dditsupport/dd_ac_meter_with_relay_buffer/README.md

# AC Energy Meter

Single-phase AC energy metering for any 230 V circuit or load. The device
measures voltage, current, real power, energy, power factor, and frequency
with a PZEM-004T v3.0, buffers 15-minute readings to internal flash, and
mirrors them to a MilesWeb-hosted PHP/MySQL backend via two store-and-forward
paths:

- **Wi-Fi** — when a known hotspot is in range, the ESP32 connects, NTP-syncs,
  POSTs buffered rows, and clears them on server ACK.
- **BLE** — a companion Android app pulls buffered rows over GATT and
  forwards them to the same MilesWeb endpoint over the phone's cellular
  data.

The ESP32 is the source of truth. Cloud and app are catch-up mirrors.

## Relay: compressor-aware AC cutoff

Each meter drives a relay (default GPIO 10) that acts as an **off-hours AC
cutoff** — a safety net for when a store manager forgets to switch the AC off
after closing. Wiring is **fail-safe NC**: the relay sits **de-energized while
the AC is allowed (open hours)** so the AC has power, and it **energizes to cut
the AC** during off hours. If the controller loses power, the relay
de-energizes and the AC keeps working. Drive a **contactor rated for the
compressor's inrush** (units are 1.5–2 ton), not a bare PCB relay — see
[`docs/PINOUT.md`](docs/PINOUT.md).

An admin sets, per device, from the backend (Admin → Devices → **Relay**):

- **AC-allowed open hours** — weekly windows (e.g. 09:00→02:00, or 11:00→23:00);
  the relay cuts power *outside* them.
- **Compressor watt threshold** — below it the compressor is considered off.
- **Grace minutes** — how long to wait for the compressor to cycle off before
  cutting.

The firmware caches all three in NVS and enforces cutoff from its local clock
even during a Wi-Fi outage. Crucially it **never opens the relay while the
compressor is drawing load**: at closing it waits for the compressor to cycle
off (wattage drops below the threshold) and then cuts, hard-cutting only at the
grace deadline if it never idles. If the AC is already idle at closing it never
cuts. No open-hours schedule cached = relay stays de-energized (AC on), the
fail-safe for an unconfigured device.

The firmware reports its relay state (energized/cut + mode) on every
`ingest.php` POST, so the admin table shows a **live indicator** per meter, and
exposes the fuller state (state-machine phase + latest wattage) over the BLE
relay characteristic. The logged wattage rows are what you tune the
threshold/grace against after observing real data.

The **Android app** can also take the relay over BLE from the device detail
screen: **On** (energize = cut) / **Off** (de-energize = AC on) force it
regardless of schedule, and **Auto** returns it to cutoff control. The override
lives in RAM, so a power-cycle returns the meter to its server config.

## Repository layout

```
firmware/                                             ESP32 Arduino sketches (one folder per board)
  esp32.supermini_ds1307_ac_energy_meter/             ESP32-C3 Super Mini firmware (DS1307, no OLED)
  esp32.WROOM.DevKit.V1_ds1307_ac_energy_meter/  ESP32 WROOM DevKit V1 firmware (DS1307, no display)
backend/                                              MilesWeb PHP + MySQL (planned, not yet built)
android/                                              Companion app (planned, not yet built)
docs/                                                 Wiring, provisioning, future hardware notes
hardware/                                             PCB source (DipTrace) + dimensioned outline drawing
tools/                                                Bench-test helpers (fake_ingest.py)
```

Both firmware folders are self-contained Arduino sketches for the same
meter; pick the one that matches your hardware. The `.supermini` build
targets the ESP32-C3 Super Mini; the `.WROOM.DevKit.V1` build targets the
ESP32 WROOM DevKit V1. Both use a DS1307 RTC and neither has a display. They
are kept separate, not merged, but track the same firmware version and feature
set — both are now `FW_VERSION` **2.0.0** with the compressor-aware, fail-safe
NC AC-cutoff relay (AC-allowed open-hours schedule; energize = cut).

The Super Mini build is the field-tested baseline and the WROOM build carries
the same logic. The differences are hardware-driven:

| | Super Mini (ESP32-C3) | WROOM DevKit V1 |
|---|---|---|
| Cores / radio | single core; BLE and Wi-Fi contend | dual core; no coexistence issue |
| BLE lifetime | 2-min config window, then handed off to Wi-Fi | BLE up for the whole session, alongside Wi-Fi |
| Wi-Fi TX power | capped at 11 dBm (weak onboard LDO) | full 19.5 dBm |
| PZEM UART | `Serial1` | `Serial2` |
| Pin map | C3 pins | ESP32 pins; GPIO 6..11 reserved for SPI flash |
| PZEM meters | 1 | 1, or **2** with the dual-PZEM build |

TX power is runtime-settable over BLE on both boards, so either can be trimmed
if a particular install proves marginal.

### Dual-PZEM build (WROOM only)

`esp32.WROOM.DevKit.V1_dual_pzem_ac_energy_meter/` (`FW_VERSION` **3.0.0**)
reads **two** PZEM-004T meters from one ESP32 and reports both under a single
`device_id`. Each meter gets its own hardware UART — channel 1 on UART2
(GPIO 16/17), channel 2 on UART1 (GPIO 32/33) — because the TTL PZEM variant
drives its TX line permanently and two of them on one UART would collide. Set
`PZEM_CHANNELS` and the `PIN_PZEM*` / `PZEM*_ADDR` entries in `config.h`.

Every reading carries a 1-based channel end to end:

- log rows are `seq,ch,boot_id,sec,V,I,P,Wh,PF,Hz` — one sampling instant writes
  one row **per channel**, all sharing `seq`, so seq-based acking still advances
  both channels together;
- the ingest POST tags each reading with `ch` and the device with
  `channel_count`;
- readings are keyed on `(device_id, seq, channel)` in the database.

Each channel keeps independent totals, midnight anchors and fault status, so one
dead meter never masks or blocks the other.

**Two relays, one per PZEM.** Relay N (GPIO 26 for PZEM 1, GPIO 27 for PZEM 2)
cuts the AC that meter N measures, and runs a fully independent open-hours
schedule, cutoff state machine, manual override and NVS-cached config. The
compressor-idle check for relay N looks only at channel N's wattage — that
pairing is the point, since deciding relay 1 from meter 2's load would either
hard-cut a running compressor or never cut at all. A failed read on a channel
counts as "compressor may be running", so a dead meter is never mistaken for an
idle one.

Relay config is stored and pushed per channel:

- `ed_device_relay_schedule` is keyed `(device_id, channel)`;
- the ingest response carries `relay_channels: [{ch, version, schedule[],
  compressor_watts, grace_min}, ...]` (the old flat `relay_*` fields are still
  emitted from channel 1, and firmware that receives only those applies them to
  every relay);
- `/api/admin_relay.php` takes a `channel` parameter (default 1) on
  `get` / `set` / `clear`, and the admin Devices page shows a relay picker
  (hidden on single-relay devices) driven by the device's reported
  `relay_count`;
- the dashboard and reports take a `channel` too, with a **Meter** selector that
  appears only for multi-meter devices. It defaults to **All meters**
  (`channel=0`), which queries every meter and overlays them — one colour-coded
  series per meter on both charts, a per-meter breakdown row, and combined
  Current / Today / Peak / Period-total cards. Picking a single meter narrows to
  that one. Reports instead offer **one meter at a time** with no combined
  option — that chart's series are already days, so folding meters in would
  multiply the lines or silently sum unrelated loads;
- the Android app's Cloud tab gets a **Meter** chip row (shown only when the
  server reports `channel_count > 1`) and charts one meter at a time, matching
  the reports rather than the dashboard overlay;
- the live relay indicator shows **one pill per relay** (`R1 LOAD ON`,
  `R2 AC CUT`, …), backed by a new `ed_device_relay_state` table keyed
  `(device_id, channel)` that ingest refreshes from the POST's `relays[]`;
- over BLE, write `{"ch":1,"mode":"on"|"off"|"auto"}` to drive one relay —
  omit `ch` to set them all — and reading returns
  `{"relays":[{"ch":1,"mode":…,"energized":…}, …]}`.

### The device declares its own layout

Every build reports `channel_count` and `relay_count` — in the BLE Device Info
characteristic and in each ingest POST — so nothing has to be configured
per-device on the other side:

- the **cloud** knows how many per-channel relay schedules are worth pushing
  (both counts are stored on `ed_device_meta`);
- the **Android app** renders exactly that many on/off/auto control sets, so
  one screen serves a 1-relay and a 2-relay meter with no build flavours.

To keep that possible, **all** firmware builds report relay state in the same
shape — an array — even the single-relay ones, which simply send a one-entry
`relays[]`. The app reads the array and renders per entry; it never needs to
know which build it is talking to.

Server side, `/api/readings.php` takes a `channel` parameter (default `1`).
Scoping every query to one channel is required, not cosmetic — a device's two
meters are separate cumulative counters, so mixing them would make the
`MAX(energy_wh) - MIN(energy_wh)` energy total meaningless.

## How fast does data reach the cloud?

The firmware aims for **seconds, not minutes**, when Wi-Fi is reachable.
Once a 15-minute row is appended to flash, the sampling task immediately
asks the connectivity task to run a Wi-Fi cycle; the next 1-second tick
picks it up, connects, NTP-syncs, POSTs, and (on ACK) truncates the row
from flash. The 2-minute periodic scan still runs as a fallback for when
the AP is out of range.

If neither the DS1307 nor NTP gave the device a wall clock, the firmware
still POSTs (`sync_wall_time` is empty); MilesWeb is expected to return a
`server_time` ISO 8601 string in the response. The firmware uses that to
seed its clock and the RTC, so subsequent rows carry real timestamps.

## Status

This branch delivers **firmware Stages 1–7** per the project spec:

| Stage | Scope | Status |
|---|---|---|
| 1 | Board bring-up | ✅ |
| 2 | PZEM bring-up | ✅ |
| 3 | PZEM integration | ✅ |
| 4 | LittleFS + NVS + boot history | ✅ |
| 5 | Backend (MilesWeb) | ⏳ next session |
| 6 | Wi-Fi sync end-to-end | ✅ (testable against `tools/fake_ingest.py`) |
| 7 | BLE GATT service | ✅ (testable with nRF Connect) |
| 8 | Android companion app | ⏳ next session |
| 9 | Backend dashboard | ⏳ next session |
| 10 | AC install | hardware, out of code scope |

## Building the firmware

See [`docs/PROVISIONING.md`](docs/PROVISIONING.md) for the full step-by-step.
Quick path:

1. Arduino IDE 2.x with libraries: PZEM-004T-v30 (mandulaj),
   ArduinoJson, NimBLE-Arduino, RTClib.
2. Board: **ESP32C3 Dev Module**, **USB CDC On Boot: Enabled**, partition
   scheme: **No OTA (2MB APP/2MB SPIFFS)** (see `docs/PROVISIONING.md`).
3. Open `firmware/esp32.supermini_ds1307_ac_energy_meter/esp32.supermini_ds1307_ac_energy_meter.ino` and Upload.

## Bench-testing without a backend

Run the stub:

```bash
python3 tools/fake_ingest.py --port 8080
```

Point `INGEST_URL` in `firmware/esp32.supermini_ds1307_ac_energy_meter/config.h` at
`http://<laptop-ip>:8080/ingest`, reflash, and the device will exercise its
full sync path against the stub.

## Architecture quick reference

- **Two FreeRTOS tasks** sharing the ESP32-C3's single core (both pinned to
  core 0; the higher-priority sampler preempts the connectivity task):
  - sampling: 1 Hz PZEM read. Every 15 min appends one row to `/log.csv`
    and advances `last_seq`.
  - connectivity: BLE GATT always advertising. Every 2 min attempts the
    Wi-Fi cycle (scan → connect → NTP → POST → ACK truncate).
- **Single mutex** protects the small shared-state POD; readers snapshot
  a value copy and release before doing any I/O.
- **Monotonic-µs clock** for energy integration (`esp_timer_get_time()`);
  wall-clock is only used for log timestamps and midnight rollover.
- **DS1307 RTC** on I²C (GPIO 5/6, 100 kHz) seeds wall-clock at boot so
  "Today: X kWh" totals track from the first second. NTP corrections are
  written back to the chip so it stays accurate across power loss. If the
  chip is absent or reports lost-power, NTP and BLE Set-Wall-Time still work
  as before.
- **NVS** uses two namespaces (`cfg` for Wi-Fi credentials, `state` for
  boot id / seq HWM / boot history) and a high-water-mark scheme that
  persists every 10 seqs to limit flash wear at the cost of small
  monotonic gaps across crashes.
- **`/log.csv`** is append-only with crash recovery on boot (deletes any
  leftover `/log.tmp`, validates and trims the last line). Sync uses
  snapshot-and-rewrite: capture max seq from RAM, send rows ≤ that, on
  ACK rewrite the file keeping only rows > that.
- **Buffer full**: when LittleFS free space drops below max(150 KB, 10 %),
  the firmware stops logging and flags the condition in shared state
  (`buffer_full`), surfaced over BLE Device Info.

See [`docs/PROVISIONING.md`](docs/PROVISIONING.md) for security TODOs
(no BLE bonding, no cert pinning, no HMAC) deferred to future hardening.
