dditsupport/dd_ac_meter_with_relay_buffer/android/README.md

# Companion Android app

Kotlin + Jetpack Compose project, living under
[`ac-energy-meter-app/`](ac-energy-meter-app/). See its own
[README](ac-energy-meter-app/README.md) for build instructions.

## Status

Stage 8 is being built incrementally:

| Slice | Commit | Notes |
|---|---|---|
| Project scaffold (Gradle + Manifest + Compose) | ✅ first cut | |
| BLE scan filtered by firmware's service UUID | ✅ first cut | |
| Add nearby device to saved list, persist to DataStore | ✅ first cut | |
| Remove saved device | ✅ first cut | |
| Tap-to-connect detail screen | ⏳ next | will read Device Info JSON |
| BLE Wi-Fi provisioning UI (scan / pick / save) | ⏳ next | mirrors §5.2 of the spec |
| Pull buffered rows, forward to MilesWeb, ACK back | ⏳ later | the original raison d'être |
| Charts (live from `readings.php`) | ⏳ later | post-backend session |
