dditsupport/dd_ac_meter_with_relay_buffer/hardware/pcb_drawing_dimensioned.pdf

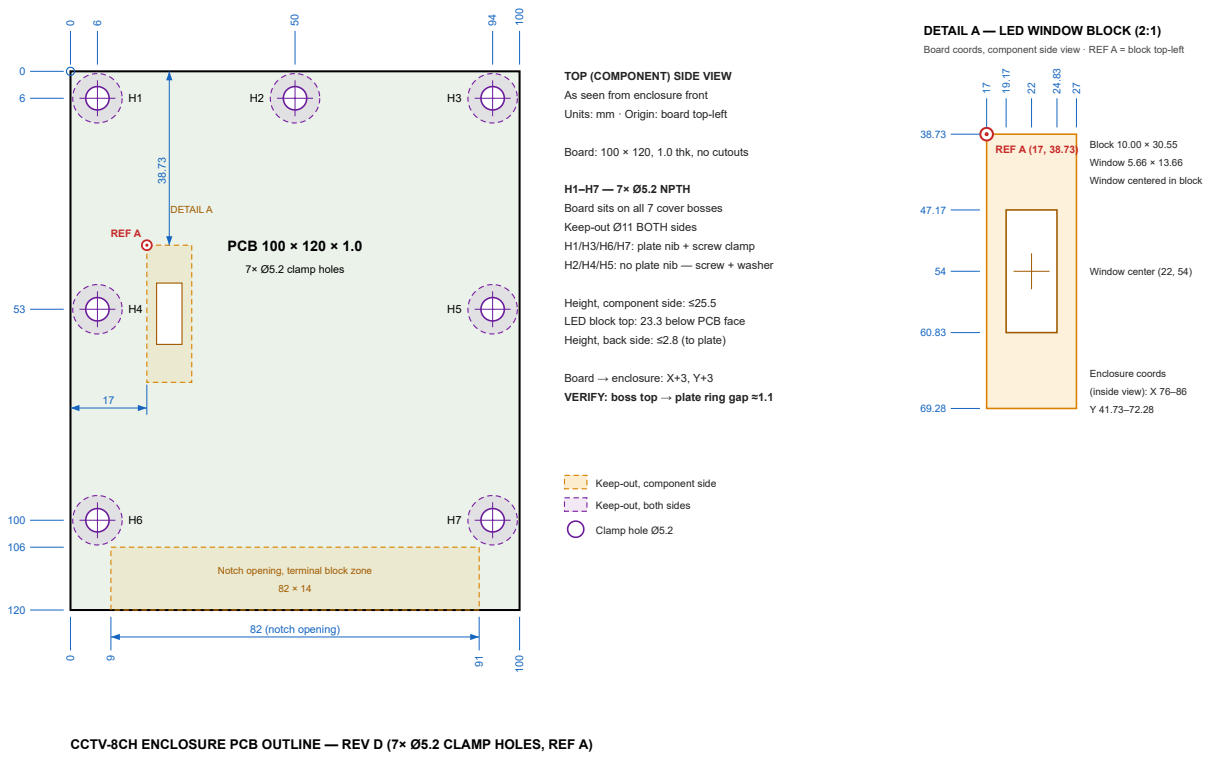
[picture p1: page 1]
PCB 100 × 120 × 1.0; 7× Ø5.2 clamp holes; DETAIL A; 82 (notch opening); REF A; Clamp hole Ø5.2; REF A (17, 38.73); Window center (22, 54); Enclosure coords; (inside view): X 76–86

DETAIL A — LED WINDOW BLOCK (2:1)

Board coords, component side view · REF A = block top-left

TOP (COMPONENT) SIDE VIEW
As seen from enclosure front
Units: mm · Origin: board top-left

Block 10.00 × 30.55
Window 5.66 × 13.66
Window centered in block

Board: 100 × 120, 1.0 thk, no cutouts

H1–H7 — 7× Ø5.2 NPTH
Board sits on all 7 cover bosses
Keep-out Ø11 BOTH sides
H1/H3/H6/H7: plate nib + screw clamp
H2/H4/H5: no plate nib — screw + washer

Height, component side: ≤25.5
LED block top: 23.3 below PCB face
Height, back side: ≤2.8 (to plate)

Board → enclosure: X+3, Y+3
VERIFY: boss top → plate ring gap ≈1.1

Keep-out, component side
Keep-out, both sides

Notch opening, terminal block zone

CCTV-8CH ENCLOSURE PCB OUTLINE — REV D (7× Ø5.2 CLAMP HOLES, REF A)
