dditsupport/dd_ac_meter_with_relay_buffer/(list of files, drawings)

Other design files:
hardware/6040_Dipak_Savkare_Relay.dip
hardware/6040_Dipak_Savkare_Relay_MOSFET.dip
hardware/DD_PCB.dip
hardware/esp32_module_grouped.dip
