dditsupport/dd_ac_meter_with_relay_buffer/firmware/esp32.WROOM.DevKit.V1_dual_pzem_ac_energy_meter/esp32.WROOM.DevKit.V1_dual_pzem_ac_energy_meter.ino

// AC Energy Meter — ESP32 WROOM firmware, DUAL-PZEM build (v3.0.0)
//
// Reads PZEM_CHANNELS (2) PZEM-004T meters — each on its own hardware UART —
// and reports both under one device_id, tagging every reading with a 1-based
// channel. Per channel it keeps independent totals, midnight anchors and fault
// status, so one dead meter never masks or blocks the other.
//
// Sketch entry point. Sets up the brownout detector, mounts storage, then
// spawns two pinned FreeRTOS tasks: SamplingTask on core 0 (both PZEMs) and
// ConnectivityTask on core 1 (BLE always, Wi-Fi periodic). The WROOM is
// dual-core with no BLE/Wi-Fi coexistence problem, so unlike the C3 Super Mini
// build BLE stays up for the whole session alongside Wi-Fi. All shared mutable
// state lives in g_state, guarded by g_state_mutex.
//
// See docs/PINOUT.md for wiring and docs/PROVISIONING.md for setup steps.

#include "config.h"
#include "shared_state.h"
#include "identity.h"
#include "time_source.h"
#include "pzem.h"
#include "storage.h"
#include "health.h"
#include "wifi_sync.h"
#include "ble_service.h"
#include "led.h"
#include "relay.h"
#include "rtc.h"

#include <esp_task_wdt.h>
#include <esp_heap_caps.h>   // heap watchdog log line
#include <esp_system.h>
#include <esp_mac.h>
#include "log_serial.h"

// ---- Global shared state ----------------------------------------------------
SharedState g_state;
SemaphoreHandle_t g_state_mutex;

// Set by loop() on a BOOT-button long-press; consumed by sampling_task, which
// owns all PZEM/Modbus access, so the reset never races a concurrent read.
static volatile bool g_energy_reset_req = false;

// ---- Forward declarations ---------------------------------------------------
static void sampling_task(void *);
static void connectivity_task(void *);
static void handle_serial_command(const String &cmd);

extern "C" void health_mark_clean_uptime();

// ---- Setup ------------------------------------------------------------------
void setup() {
  // The brownout detector is enabled by default in ESP-IDF 5.x at the chip
  // default threshold (~2.4 V). Override via menuconfig / sdkconfig if needed.

  Serial.begin(115200);
  log_serial::init();
  // Give the serial monitor time to (re)attach after reset before the first
  // prints, so the boot banner isn't lost. The WROOM DevKit has a real USB-UART
  // bridge (so unlike the Super Mini's native USB-CDC it needs no enumeration
  // window), but the reattach margin is still worth having.
  delay(1000);
  LOG_PRINTLN();
  LOG_PRINTLN("=== AC Energy Meter boot ===");

  g_state_mutex = xSemaphoreCreateMutex();
  if (!g_state_mutex) {
    LOG_PRINTLN("[fatal] state mutex alloc failed");
    while (true) delay(1000);
  }

  time_source::begin();
  health::begin();
  if (!storage::begin()) {
    LOG_PRINTLN("[fatal] storage init failed; check flash");
    while (true) delay(1000);
  }
  pzem::begin();

  // BOOT button for the fresh-install energy reset (long-press in loop()).
  pinMode(PIN_BOOT_BUTTON, INPUT_PULLUP);

  // Seed wall clock from the DS1307 if it's healthy. This lets "Today:" energy
  // totals track from boot instead of only counting the current session until
  // NTP or BLE sets the clock.
  if (rtc::begin()) {
    time_t epoch = rtc::read_epoch();
    if (epoch > 0 && time_source::set_wall_clock(epoch)) {
      struct tm lt;
      localtime_r(&epoch, &lt);
      char tbuf[40];
      strftime(tbuf, sizeof(tbuf), "%Y-%m-%d %H:%M:%S %Z", &lt);
      LOG_PRINTF("[boot] RTC time: %s  (epoch=%ld)\n", tbuf, (long)epoch);
    } else {
      LOG_PRINTLN("[boot] RTC present but returned no time");
    }
  } else {
    LOG_PRINTLN("[boot] RTC unavailable (lost power or not wired)");
  }

  // Seed shared state.
  if (state_lock(pdMS_TO_TICKS(1000))) {
    g_state.boot_id = storage::boot_id();
    g_state.last_seq = storage::last_seq();
    g_state.unsynced_count = storage::current_unsynced_count();
    g_state.buffer_full = storage::is_buffer_full();
    g_state.wifi_status = WIFI_IDLE;
    g_state.ble_status = BLE_OFF;
    g_state.wall_clock_known = time_source::wall_clock_known();
    state_unlock();
  }

  LOG_PRINTF("Device ID: %s  fw=%s  boot=%u  unsynced=%u\n",
                identity::device_id().c_str(), identity::fw_version(),
                storage::boot_id(), storage::current_unsynced_count());

  // Diagnostic: print both the factory base MAC (what esptool shows) and the
  // effective Wi-Fi STA MAC (what WiFi.macAddress() returns). They differ if
  // a Custom MAC has been burned into eFuse, which is why two ESP32s can
  // print different BLE names than their printed chip MACs would suggest.
  {
    uint8_t base[6] = {0};
    uint8_t sta[6]  = {0};
    esp_efuse_mac_get_default(base);
    esp_read_mac(sta, ESP_MAC_WIFI_STA);
    LOG_PRINTF("[boot] eFuse base MAC: %02X:%02X:%02X:%02X:%02X:%02X\n",
                  base[0], base[1], base[2], base[3], base[4], base[5]);
    LOG_PRINTF("[boot] Wi-Fi STA MAC : %02X:%02X:%02X:%02X:%02X:%02X (used for device_id)\n",
                  sta[0],  sta[1],  sta[2],  sta[3],  sta[4],  sta[5]);
  }

  // Hardcoded Wi-Fi fallback for bench testing. If WIFI_SSID is non-empty
  // and the NVS slot has no credentials yet, copy them in. Once provisioned
  // via BLE the saved value wins and this block becomes a no-op.
  if (sizeof(WIFI_SSID) > 1) {
    storage::WifiCred existing[MAX_WIFI_CREDS];
    if (storage::get_wifi_creds(existing, MAX_WIFI_CREDS) == 0) {
      if (storage::add_wifi_cred(WIFI_SSID, WIFI_PASSWORD)) {
        LOG_PRINTF("[boot] seeded Wi-Fi from config.h: %s\n", WIFI_SSID);
      }
    }
  }

  ble_service::begin();
  wifi_sync::begin();
  led::begin();
  relay::begin();

  xTaskCreatePinnedToCore(sampling_task, "sampling",
                          SAMPLING_TASK_STACK, nullptr, SAMPLING_TASK_PRIO,
                          nullptr, 0);
  xTaskCreatePinnedToCore(connectivity_task, "conn",
                          CONN_TASK_STACK, nullptr, CONN_TASK_PRIO,
                          nullptr, 1);
}

// ---- Main loop (idle / serial console / WDT feeder) ------------------------
void loop() {
  static String line;
  while (Serial.available()) {
    char c = (char)Serial.read();
    if (c == '\n' || c == '\r') {
      if (line.length()) {
        handle_serial_command(line);
        line = "";
      }
    } else if (line.length() < 64) {
      line += c;
    }
  }
  // BOOT button (GPIO 0) long-press = zero the PZEM energy register (fresh
  // install). We only raise a request here; sampling_task performs the reset so
  // all PZEM access stays on one task. Fires once per hold.
  static uint32_t boot_press_start_ms = 0;
  static bool     boot_reset_fired    = false;
  if (digitalRead(PIN_BOOT_BUTTON) == LOW) {
    if (boot_press_start_ms == 0) boot_press_start_ms = millis();
    if (!boot_reset_fired && (millis() - boot_press_start_ms) >= FACTORY_RESET_HOLD_MS) {
      boot_reset_fired   = true;
      g_energy_reset_req = true;
      LOG_PRINTLN("[reset] BOOT held — energy reset requested");
    }
  } else {
    boot_press_start_ms = 0;
    boot_reset_fired    = false;
  }

  // Factory reset requested over BLE (Android app). Done here in the main loop,
  // outside the NimBLE callback, so the NVS erase + reboot run from a safe
  // context. This wipes the device to a fresh state and restarts it.
  if (storage::consume_factory_reset_request()) {
    LOG_PRINTLN("[reset] factory reset requested — wiping NVS + log, rebooting");
    storage::factory_reset();
    delay(300);        // let the log line flush before the restart
    esp_restart();
  }

  led::tick();
  relay::tick();
  delay(50);
}

static void handle_serial_command(const String &cmd) {
  String c = cmd;
  c.trim();
  c.toUpperCase();
  if (c == "DUMP") {
    storage::dump_log_to_serial();
  } else if (c == "BOOTS") {
    storage::dump_boots_to_serial();
  } else if (c == "CLEAR") {
    storage::clear_log();
  } else if (c == "WIFI") {
    storage::WifiCred creds[MAX_WIFI_CREDS];
    size_t n = storage::get_wifi_creds(creds, MAX_WIFI_CREDS);
    LOG_PRINTF("%u saved networks\n", (unsigned)n);
    for (size_t i = 0; i < n; ++i) {
      LOG_PRINTF("  %u: %s\n", (unsigned)i, creds[i].ssid.c_str());
    }
  } else if (c == "INFO") {
    LOG_PRINTF("id=%s fw=%s boot=%u last_seq=%llu unsynced=%u free=%u\n",
                  identity::device_id().c_str(), identity::fw_version(),
                  storage::boot_id(), (unsigned long long)storage::last_seq(),
                  storage::current_unsynced_count(),
                  (unsigned)storage::free_bytes());
  } else if (c == "SYNC") {
    LOG_PRINTLN("[cmd] requesting immediate Wi-Fi sync");
    wifi_sync::request_immediate_sync();
  } else if (c == "CLEARBOOTS") {
    storage::clear_boot_history();
    LOG_PRINTLN("[cmd] boot_history cleared from NVS");
  } else if (c == "LOG") {
    // Append a synthetic row using the latest sample so the next sync
    // has something to send. Useful for end-to-end testing without
    // waiting LOG_INTERVAL_SEC.
    SharedState snap;
    if (state_snapshot(snap) && storage::seq_lock(pdMS_TO_TICKS(2000))) {
      uint64_t seq = storage::last_seq() + 1;
      bool wrote_any = false;
      // One row per channel, sharing this seq — same shape the sampling task
      // writes, so a SYNC after this exercises the real multi-channel path.
      for (uint8_t ch = 0; ch < PZEM_CHANNELS; ++ch) {
        storage::RowFields rf;
        rf.seq = seq;
        rf.channel = (uint8_t)(ch + 1);
        rf.boot_id = storage::boot_id();
        rf.sec_since_boot = (uint32_t)(time_source::monotonic_us() / 1000000ULL);
        rf.V  = snap.ch[ch].latest.voltage;
        rf.I  = snap.ch[ch].latest.current;
        rf.P  = snap.ch[ch].latest.power;
        rf.Wh = snap.ch[ch].latest.energy_wh;
        rf.PF = snap.ch[ch].latest.pf;
        rf.Hz = snap.ch[ch].latest.frequency;
        rf.epoch = (uint32_t)time_source::wall_time();   // 0 if clock unknown
        if (storage::append_row(rf)) wrote_any = true;
      }
      if (wrote_any) {
        storage::set_last_seq(seq);
        wifi_sync::request_immediate_sync();
        LOG_PRINTF("[cmd] synthetic row(s) seq=%llu logged, sync requested\n",
                      (unsigned long long)seq);
      } else {
        LOG_PRINTLN("[cmd] append_row failed (buffer full?)");
      }
      storage::seq_unlock();
    }
  } else {
    LOG_PRINTF("unknown command: %s (try DUMP, BOOTS, CLEAR, CLEARBOOTS, WIFI, INFO, SYNC, LOG)\n",
                  c.c_str());
  }
}

// ---- SamplingTask (core 0) --------------------------------------------------
static void sampling_task(void *) {
  esp_task_wdt_add(nullptr);

  uint64_t last_us = time_source::monotonic_us();
  uint64_t last_log_us = last_us;
  uint32_t prev_day_observed = 0;   // last local day this boot has seen
  bool clean_uptime_marked = false;
  uint32_t boot_start_us_sec = (uint32_t)(last_us / 1000000ULL);

  // Session anchor = first valid PZEM cumulative reading after this boot, per
  // channel. RAM-only; resets on every reboot, which is what "session" means.
  float session_anchor_wh[PZEM_CHANNELS];
  for (uint8_t i = 0; i < PZEM_CHANNELS; ++i) session_anchor_wh[i] = -1.0f;

  // Last logged PzemStatus per channel, so a fault that develops (or clears)
  // after boot is reported once per transition rather than every second.
  PzemStatus last_logged_st[PZEM_CHANNELS];
  for (uint8_t i = 0; i < PZEM_CHANNELS; ++i) last_logged_st[i] = (PzemStatus)0xFF;

  for (;;) {
    esp_task_wdt_reset();

    // Fresh-install energy reset — from the BOOT long-press (loop(), which
    // requests every channel) or the BLE "reset energy" command, which may
    // target one channel. Done here, on the PZEM-owning task, so the
    // resetEnergy() Modbus write never races pzem::read().
    bool reset_from_button = g_energy_reset_req;
    g_energy_reset_req = false;
    for (uint8_t ch = 0; ch < PZEM_CHANNELS; ++ch) {
      bool reset_from_ble = pzem::consume_reset_request(ch);
      if (!reset_from_button && !reset_from_ble) continue;
      if (pzem::reset_energy(ch)) {
        // Re-anchor session; "today" re-anchors on its own when it sees the drop.
        session_anchor_wh[ch] = -1.0f;
        LOG_PRINTF("[reset] PZEM ch%u energy register zeroed (%s)\n",
                   (unsigned)(ch + 1), reset_from_ble ? "BLE app" : "BOOT button");
      } else {
        LOG_PRINTF("[reset] pzem::reset_energy(ch%u) failed\n", (unsigned)(ch + 1));
      }
    }

    uint64_t now_us = time_source::monotonic_us();
    last_us = now_us;

    // Read every channel up front, then publish one consistent snapshot.
    PzemSample sample[PZEM_CHANNELS];
    bool       ok[PZEM_CHANNELS];
    PzemStatus st[PZEM_CHANNELS];
    float total_kwh[PZEM_CHANNELS]   = {0.0f};
    float session_kwh[PZEM_CHANNELS] = {0.0f};
    float today_kwh[PZEM_CHANNELS]   = {0.0f};
    bool  today_partial[PZEM_CHANNELS];
    bool  any_ok = false;

    uint32_t today = 0;
    bool have_clock = time_source::wall_clock_known();
    if (have_clock) today = time_source::local_day_number();
    // A day rollover is observed once for the whole unit, not per channel.
    bool observed_rollover =
        have_clock && (prev_day_observed != 0) && (prev_day_observed != today);

    for (uint8_t ch = 0; ch < PZEM_CHANNELS; ++ch) {
      sample[ch] = PzemSample{};
      today_partial[ch] = true;
      ok[ch] = pzem::read(ch, sample[ch]);
      st[ch] = pzem::classify(ch, ok[ch], sample[ch]);
      if (ok[ch]) any_ok = true;

      if (st[ch] != last_logged_st[ch]) {
        const char *sname = st[ch] == PZEM_OK ? "OK"
                          : st[ch] == PZEM_STALE ? "STALE (no Modbus response)"
                          : st[ch] == PZEM_SENSOR_FAULT ? "SENSOR_FAULT (V ~0 while on)"
                          : "UNKNOWN";
        LOG_PRINTF("[pzem] ch%u status: %s\n", (unsigned)(ch + 1), sname);
        last_logged_st[ch] = st[ch];
      }

      if (!ok[ch]) continue;

      // Total: PZEM's lifetime cumulative reading, straight conversion.
      total_kwh[ch] = sample[ch].energy_wh / 1000.0f;

      // Session: anchored at this channel's first read of the boot. Re-anchor
      // if its PZEM rolled back (resetEnergy(), or a hardware reset).
      if (session_anchor_wh[ch] < 0 || sample[ch].energy_wh < session_anchor_wh[ch]) {
        session_anchor_wh[ch] = sample[ch].energy_wh;
      }
      session_kwh[ch] = (sample[ch].energy_wh - session_anchor_wh[ch]) / 1000.0f;

      // Today: anchored in NVS per channel at the start of the day.
      if (have_clock) {
        float    anchor_wh   = storage::today_anchor_wh(ch);
        uint32_t anchor_day  = storage::today_anchor_day(ch);
        bool     anchor_clean = storage::today_anchor_clean(ch);

        bool need_reanchor = (anchor_wh < 0) ||
                             (anchor_day != today) ||
                             (sample[ch].energy_wh < anchor_wh);
        if (need_reanchor) {
          // Clean iff we watched the day boundary tick over during this boot
          // (so we caught the full day's energy). Otherwise it's a mid-day
          // boot, a wall-clock-just-arrived case, or a multi-day gap.
          bool clean = observed_rollover;
          storage::set_today_anchor(ch, sample[ch].energy_wh, today, clean);
          anchor_wh = sample[ch].energy_wh;
          anchor_clean = clean;
        }
        today_kwh[ch] = (sample[ch].energy_wh - anchor_wh) / 1000.0f;
        if (today_kwh[ch] < 0) today_kwh[ch] = 0.0f;
        today_partial[ch] = !anchor_clean;
      }

    }
    if (have_clock) prev_day_observed = today;

    if (state_lock()) {
      for (uint8_t ch = 0; ch < PZEM_CHANNELS; ++ch) {
        if (ok[ch]) {
          g_state.ch[ch].latest      = sample[ch];
          g_state.ch[ch].total_kwh   = total_kwh[ch];
          g_state.ch[ch].session_kwh = session_kwh[ch];
          g_state.ch[ch].today_kwh   = today_kwh[ch];
          g_state.ch[ch].today_is_partial = today_partial[ch];
          if (sample[ch].power > g_state.ch[ch].peak_power_w) {
            g_state.ch[ch].peak_power_w = sample[ch].power;
          }
        }
        g_state.ch[ch].pzem_status = st[ch];
      }
      g_state.wall_clock_known = time_source::wall_clock_known();
      g_state.uptime_sec = (uint32_t)(now_us / 1000000ULL);
      g_state.unsynced_count = storage::current_unsynced_count();
      g_state.buffer_full = storage::is_buffer_full();
      state_unlock();
    }

    // Feed each relay the wattage from ITS OWN PZEM channel. Passing ok[ch] as
    // `valid` matters: a failed read must not look like 0 W, or the cutoff
    // would treat a dead meter as an idle compressor and cut it under load.
    for (uint8_t ch = 0; ch < PZEM_CHANNELS && ch < relay::count(); ++ch) {
      relay::update_power(ch, sample[ch].power, ok[ch]);
    }

    // Periodic log row. Cadence is server-configurable (storage::log_interval_sec)
    // and falls back to LOG_INTERVAL_SEC_DEFAULT (config.h) on a fresh device.
    // One sampling instant emits one row PER CHANNEL, all sharing `seq`.
    uint32_t log_period_sec = storage::log_interval_sec();
    // Hold the seq lock across seq assignment -> append -> set_last_seq so a
    // concurrent rebase_seq() (server-reported seq collision) cannot renumber
    // the buffer in between. Only a rebase holds it for long; if it is busy,
    // leave last_log_us alone and log on the next 1 s tick instead.
    if ((uint64_t)(now_us - last_log_us) >= (uint64_t)log_period_sec * 1000000ULL &&
        storage::seq_lock(pdMS_TO_TICKS(200))) {
      last_log_us = now_us;
      if (any_ok) {
        uint64_t seq = storage::last_seq() + 1;
        bool wrote_any = false;
        for (uint8_t ch = 0; ch < PZEM_CHANNELS; ++ch) {
          // Skip a channel that has no fresh reading; the other still logs.
          if (!ok[ch]) continue;
          storage::RowFields rf;
          rf.seq = seq;
          rf.channel = (uint8_t)(ch + 1);   // 1-based on the wire
          rf.boot_id = storage::boot_id();
          rf.sec_since_boot = (uint32_t)(now_us / 1000000ULL);
          rf.V  = sample[ch].voltage;
          rf.I  = sample[ch].current;
          rf.P  = sample[ch].power;
          rf.Wh = sample[ch].energy_wh;
          rf.PF = sample[ch].pf;
          rf.Hz = sample[ch].frequency;
          rf.epoch = (uint32_t)time_source::wall_time();   // 0 if clock unknown
          if (storage::append_row(rf)) wrote_any = true;
        }
        if (wrote_any) {
          storage::set_last_seq(seq);
          if (state_lock()) {
            g_state.last_seq = seq;
            g_state.unsynced_count = storage::current_unsynced_count();
            state_unlock();
          }
          // Push as soon as the next ConnectivityTask tick runs. If Wi-Fi is
          // reachable the rows ship within seconds; if not they stay in
          // /log.csv and the periodic cycle retries.
          wifi_sync::request_immediate_sync();
        }
      }
      storage::seq_unlock();
    }

    // Mark clean uptime after passing the boot-loop window.
    if (!clean_uptime_marked &&
        (uint32_t)(now_us / 1000000ULL) - boot_start_us_sec >= BOOTLOOP_WINDOW_SEC) {
      health_mark_clean_uptime();
      clean_uptime_marked = true;
    }

    vTaskDelay(pdMS_TO_TICKS(SAMPLE_INTERVAL_MS));
  }
}

// ---- ConnectivityTask (core 1) ---------------------------------------------
static void connectivity_task(void *) {
  esp_task_wdt_add(nullptr);
  uint64_t last_wifi_us      = time_source::monotonic_us();
  uint64_t last_ble_alive_us = time_source::monotonic_us();
  bool first_cycle = true;
  // BLE_CONFIG_WINDOW_SEC is 0 on the WROOM, so the BLE->Wi-Fi handoff below is
  // compiled out entirely: `ble_off` stays false for the whole run, BLE keeps
  // ticking, and Wi-Fi is always allowed. The dual-core WROOM runs both radios
  // concurrently with no coexistence workaround. (On the single-core C3 this
  // same code shuts BLE down after the config window.)
  bool ble_off = false;
  // Stuck-Wi-Fi escalation state (see the watchdog block below). Seconds spent
  // ASSOCIATED without a successful POST; reset by a dropped link or a POST.
  uint32_t stuck_wifi_sec   = 0;
  uint32_t last_since_post  = UINT32_MAX;
  bool     stuck_rest_tried = false;
  bool     force_radio_rest = false;
  // Timestamp of the last radio rest, periodic or forced.
  uint64_t last_radio_rest_us = time_source::monotonic_us();

  for (;;) {
    esp_task_wdt_reset();
    uint64_t now_us = time_source::monotonic_us();
    uint64_t uptime_sec = now_us / 1000000ULL;
#if BLE_CONFIG_WINDOW_SEC == 0
    // The BLE config window is the only reader of uptime_sec here, and it is
    // compiled out on builds with no handoff (the WROOMs). The stuck-Wi-Fi
    // watchdog used to read it too, but it is association-gated now and needs
    // no uptime guard.
    (void)uptime_sec;
#endif

    if (!ble_off) {
      ble_service::tick();
      if (ble_service::is_alive()) last_ble_alive_us = now_us;
    }

    // Is Wi-Fi permitted to be on the air at all right now? False during the C3's
    // BLE config window (before the handoff) and in boot-loop BLE-only mode.
    // Hoisted out of the block below because the radio rest has to honour it
    // too — see there.
    bool wifi_allowed = false;

    if (!health::boot_loop_tripped()) {
#if BLE_CONFIG_WINDOW_SEC > 0
      if (!ble_off && uptime_sec >= (uint64_t)BLE_CONFIG_WINDOW_SEC) {
        // Config window is over, but if the app is still connected, don't cut it
        // off mid-session — hold BLE (and keep Wi-Fi off the radio) until the app
        // disconnects, then hand the radio to Wi-Fi. Log the deferral once.
        if (ble_service::is_connected()) {
          static bool logged_defer = false;
          if (!logged_defer) {
            LOG_PRINTLN("[conn] BLE config window over but app is connected — deferring handoff until it disconnects");
            logged_defer = true;
          }
        } else {
          LOG_PRINTLN("[conn] BLE config window over — shutting BLE down, Wi-Fi takes the radio");
          ble_service::shutdown();
          ble_off = true;
          first_cycle = true;   // connect immediately now that the radio is free
        }
      }
      wifi_allowed = ble_off;   // Wi-Fi only after BLE has handed off the radio
#else
      wifi_allowed = true;      // WROOM: BLE + Wi-Fi run concurrently, always
#endif

      // On-demand Wi-Fi scan requested over BLE (provisioning).
      if (!ble_off && wifi_sync::consume_scan_request()) {
        wifi_sync::run_scan();
        ble_service::tick();  // push the fresh results immediately
      }

      if (wifi_allowed) {
        uint64_t since_us = now_us - last_wifi_us;
        uint64_t interval_us = (uint64_t)WIFI_SCAN_INTERVAL_SEC * 1000000ULL;
        bool periodic_due = first_cycle ? true : (since_us >= interval_us);
        bool triggered = wifi_sync::consume_immediate_sync_request();
        if (periodic_due || triggered) {
          first_cycle = false;
          last_wifi_us = now_us;
          wifi_sync::run_cycle();
        }
      }
    }

    // ---- Radio rest --------------------------------------------------------
    // Take Wi-Fi (and BLE advertising) off-air briefly, then bring them back and
    // sync straight away. This is what breaks a stale association that
    // try_connect_known()'s WL_CONNECTED fast path would otherwise reuse
    // indefinitely, without paying for a reboot. See config.h for the why.
    {
      // The rest MECHANISM always runs: the stuck-Wi-Fi escalation below drives
      // it through force_radio_rest, and that is the path that earns its keep.
      // Only the blind periodic SCHEDULE is optional, so a server-pushed
      // interval of 0 retires the timer WITHOUT disabling on-demand
      // reassociation.
      uint32_t rest_interval = storage::radio_rest_interval_sec();
      bool periodic_rest_due =
          rest_interval > 0 &&
          (time_source::monotonic_us() - last_radio_rest_us) >=
              (uint64_t)rest_interval * 1000000ULL;
      // Defer past the deadline while a phone is connected rather than cutting
      // the session off; the rest happens as soon as it disconnects.
      // Only ever rest a radio that is allowed to be on. radio_on() ends with
      // WiFi.mode(WIFI_STA), so without this a server-pushed rest interval would
      // bring Wi-Fi up during the C3's BLE-only config window, or in boot-loop
      // BLE-only mode — defeating the handoff this build exists to enforce and
      // putting both radios on the air together, which is the coexistence crash
      // it is there to avoid.
      if (wifi_allowed && (periodic_rest_due || force_radio_rest) &&
          (ble_off || !ble_service::is_connected())) {
        force_radio_rest = false;
        uint32_t rest_dur = storage::radio_rest_duration_sec();
        LOG_PRINTF("[health] radio rest: off-air for %u s\n", (unsigned)rest_dur);
        // Only touch BLE while it is still up. After the config-window handoff
        // (ble_off) the controller is shut down and these would be meaningless.
        if (!ble_off) ble_service::pause_advertising();
        wifi_sync::radio_off();

        // Sleep the window out in 1 s slices so the task WDT keeps being fed and
        // the sampling task keeps its slot. PZEM sampling and log writes are
        // unaffected — rows buffer to LittleFS and ship on the next cycle.
        for (uint32_t i = 0; i < rest_dur; ++i) {
          esp_task_wdt_reset();
          vTaskDelay(pdMS_TO_TICKS(1000));
        }

        wifi_sync::radio_on();
        if (!ble_off) ble_service::resume_advertising();
        LOG_PRINTLN("[health] radio rest over — reassociating");

        last_radio_rest_us = time_source::monotonic_us();
        // Don't wait out the rest of the normal WIFI_SCAN_INTERVAL_SEC tick;
        // prove the new association immediately.
        wifi_sync::request_immediate_sync();
        // The rest deliberately took BLE off-air, so don't let that idle window
        // count against the stuck-BLE watchdog below.
        last_ble_alive_us = time_source::monotonic_us();
      }
    }

    // ---- Stuck-watchdog soft reboots ---------------------------------------
    // Independent of the 30 s task WDT — these catch the subtler case where
    // every task is alive but the radio side is silently dead.

    // Stuck-Wi-Fi accounting. This loop runs at 1 Hz, so the counter is in
    // seconds. It advances ONLY while the station is associated: a device with
    // no AP in range is not stuck, it is just offline, and counting that is what
    // made the old watchdog reboot healthy units. Any POST landing drives
    // seconds_since_last_successful_post() backwards, which is how a recovery is
    // detected. A boot that has never posted is exempt, so a fresh or
    // unprovisioned device never reboots itself — which is also why this needs
    // no uptime guard.
    {
      uint32_t since_post = wifi_sync::seconds_since_last_successful_post();
      if (!wifi_sync::is_associated() || since_post == UINT32_MAX) {
        stuck_wifi_sec = 0;        // offline, or nothing posted yet this boot
        stuck_rest_tried = false;
      } else if (since_post < last_since_post) {
        stuck_wifi_sec = 0;        // a POST just landed
        stuck_rest_tried = false;
      } else {
        stuck_wifi_sec++;          // associated, and still nothing gets through
      }
      last_since_post = since_post;
    }

    // Escalation 1: reassociate. A stale association survives WL_CONNECTED, and
    // a radio rest is the cheap cure — one sync interval, no reboot, uptime and
    // boot_id preserved. Only tried once per stuck episode.
#if STUCK_WIFI_REASSOC_SEC > 0
    if (stuck_wifi_sec >= STUCK_WIFI_REASSOC_SEC && !stuck_rest_tried) {
      LOG_PRINTF("[health] stuck-wifi: associated but no POST for %u s — forcing reassociation\n",
                 (unsigned)stuck_wifi_sec);
      stuck_rest_tried = true;
      force_radio_rest = true;
    }
#endif

    // Escalation 2: reboot, if reassociating did not help either.
    if (stuck_wifi_sec >= STUCK_WIFI_REBOOT_SEC) {
      LOG_PRINTF("[health] stuck-wifi watchdog: associated but no POST for %u s, restarting\n",
                 (unsigned)stuck_wifi_sec);
      delay(100);
      esp_restart();
    }

    // Stuck-BLE watchdog only applies while BLE is meant to be alive. After the
    // intentional handoff shutdown, BLE is off by design — don't reboot on it.
    if (!ble_off) {
      uint64_t since_ble_us = time_source::monotonic_us() - last_ble_alive_us;
      if (since_ble_us / 1000000ULL > STUCK_BLE_REBOOT_SEC) {
        LOG_PRINTF("[health] stuck-ble watchdog: %llu s since BLE was alive, restarting\n",
                   (unsigned long long)(since_ble_us / 1000000ULL));
        delay(100);
        esp_restart();
      }
    }

    // Heap watchdog. The guard in post_batch() stops the device driving a TLS
    // handshake into a starved heap, but deferring is not recovery: nothing
    // compacts a C heap, so once fragmentation has starved the large contiguous
    // block mbedTLS needs, the device would defer forever while still showing
    // "Wi-Fi connected". A reboot is the only cure, so escalate to one after
    // HEAP_LOW_REBOOT_CYCLES consecutive deferrals.
    //
    // post_batch() does not count a deferral until at least one POST has landed
    // this boot, so this cannot fire on a device that has never synced — which
    // is what stops a mis-set HEAP_MIN_* from turning into a reboot loop.
    // health::boot_loop_tripped() backstops the rest.
#if HEAP_LOW_REBOOT_CYCLES > 0
    {
      uint32_t low_cycles = wifi_sync::consecutive_low_heap_cycles();
      if (low_cycles >= HEAP_LOW_REBOOT_CYCLES) {
        LOG_PRINTF("[health] heap watchdog: %u consecutive low-heap cycles "
                   "(free=%u largest=%u), restarting\n",
                   (unsigned)low_cycles,
                   (unsigned)esp_get_free_heap_size(),
                   (unsigned)heap_caps_get_largest_free_block(MALLOC_CAP_8BIT));
        delay(100);
        esp_restart();
      }
    }
#endif

    // ---- Nightly scheduled reboot ------------------------------------------
    // Once a local calendar day, inside the configured window, for a fresh heap
    // and fresh radio stacks. See the NIGHTLY_REBOOT_* block in config.h.
    if (storage::nightly_reboot_enabled()) {
      uint32_t up_sec = (uint32_t)(time_source::monotonic_us() / 1000000ULL);
      uint32_t today  = time_source::local_day_number();   // 0 = clock unknown
      if (today != 0 && time_source::wall_clock_known() &&
          up_sec >= NIGHTLY_REBOOT_MIN_UPTIME_SEC &&
          today != storage::last_nightly_reboot_day()) {
        uint8_t start_h = storage::nightly_reboot_start_hour();
        uint8_t end_h   = storage::nightly_reboot_end_hour();
        int span_min    = (int)(end_h - start_h) * 60;
        // Per-device offset into the window, MAC-derived so it is stable across
        // boots and different on every unit — a fleet returns staggered rather
        // than all at once. Recomputed if the server moves the window, since the
        // offset is taken modulo the window's width.
        static int s_target_min  = -1;
        static int s_target_span = -1;
        if (s_target_min < 0 || s_target_span != span_min) {
          uint8_t mac[6] = {0};
          esp_read_mac(mac, ESP_MAC_WIFI_STA);
          uint32_t h = ((uint32_t)mac[3] << 16) | ((uint32_t)mac[4] << 8) | mac[5];
          s_target_min  = (int)(h % (uint32_t)span_min);
          s_target_span = span_min;
        }
        time_t now_wall = time_source::wall_time();
        struct tm lt;
        localtime_r(&now_wall, &lt);
        bool in_window = lt.tm_hour >= start_h && lt.tm_hour < end_h;
        int win_min = (lt.tm_hour - start_h) * 60 + lt.tm_min;
        // >= rather than == so a missed minute (the task can be busy inside a
        // sync cycle) still fires later in the window instead of skipping the
        // night entirely.
        if (in_window && win_min >= s_target_min &&
            (ble_off || !ble_service::is_connected()) &&
            !wifi_sync::is_radio_busy()) {
          // Record the day BEFORE restarting, or the new boot would land back
          // inside the window and reboot again.
          storage::set_last_nightly_reboot_day(today);
          LOG_PRINTF("[health] nightly reboot at %02d:%02d local "
                     "(window %02u:00-%02u:00, this device +%d min)\n",
                     lt.tm_hour, lt.tm_min,
                     (unsigned)start_h, (unsigned)end_h, s_target_min);
          delay(100);   // let the NVS write and the log line settle
          esp_restart();
        }
      }
    }

    vTaskDelay(pdMS_TO_TICKS(1000));
  }
}
