dditsupport/dd_ac_meter_with_relay_buffer/firmware/esp32.WROOM.DevKit.V1_ds1307_ac_energy_meter/wifi_sync.cpp

#include "wifi_sync.h"
#include "config.h"
#include "shared_state.h"
#include "storage.h"
#include "identity.h"
#include "time_source.h"
#include "rtc.h"
#include "led.h"
#include "relay.h"
#include "ble_service.h"   // pause/resume advertising (disabled on WROOM)

#include <WiFi.h>
#include <WiFiClientSecure.h>
#include <HTTPClient.h>
#include <ArduinoJson.h>
#include <esp_heap_caps.h>
#include <esp_system.h>
#include <esp_task_wdt.h>
#include "log_serial.h"

// TODO: HMAC payload signing as a future hardening step. For v1, the only auth
// is the X-Device-Token header. Cert pinning is also TODO; we use setInsecure()
// to accept any server cert because the device speaks to a single endpoint
// configured at flash time and the token is the bearer credential.
//
// To enable cert pinning later: replace setInsecure() with setCACert(rootCA)
// and bundle the root cert as a PROGMEM blob in config.h.

namespace wifi_sync {

static volatile bool s_radio_busy = false;
static volatile bool s_immediate_sync_pending = false;
static volatile bool s_scan_pending = false;
static String s_scan_results_json = "[]";
static volatile uint32_t s_scan_version = 0;
// Time of last fully-successful POST round-trip. 0 means "never this boot",
// which forces a heartbeat POST on the first cycle so a fresh device picks
// up server-pushed config (log_interval_sec, server_time) without waiting
// for its first 15-min log row.
static uint64_t s_last_successful_post_us = 0;

// Consecutive Wi-Fi cycles whose POST was deferred by the heap guard in
// post_batch(). Reset to 0 on any cycle where the heap was healthy. Read by the
// heap watchdog in the connectivity task, which reboots at
// HEAP_LOW_REBOOT_CYCLES.
static uint32_t s_low_heap_cycles = 0;

#if HEAP_TRACE_CYCLE
// Free heap at the end of the previous completed cycle, so the next cycle can
// attribute whatever moved while the task was idle between them.
static uint32_t s_heap_prev_cycle_end = 0;
#endif

// Last STA disconnect reason code, captured from the Wi-Fi event so the connect
// failure log can say *why* it failed. Common codes: 15 =
// 4WAY_HANDSHAKE_TIMEOUT (wrong password), 2 = AUTH_EXPIRE, 201 = NO_AP_FOUND,
// 205 = CONNECTION_FAIL. 0 = none captured yet.
static volatile uint8_t s_last_disc_reason = 0;

static void on_wifi_event(WiFiEvent_t event, WiFiEventInfo_t info) {
  if (event == ARDUINO_EVENT_WIFI_STA_DISCONNECTED) {
    s_last_disc_reason = info.wifi_sta_disconnected.reason;
  }
}

static void set_wifi_status(WifiStatus st) {
  if (state_lock()) {
    g_state.wifi_status = st;
    state_unlock();
  }
}

// Set when new credentials are saved over BLE. The WL_CONNECTED fast path below
// would otherwise keep reusing the OLD network forever, so a meter moved to a
// new SSID from the app never actually switched until it lost the old one.
static volatile bool s_reconnect_pending = false;
void request_reconnect() { s_reconnect_pending = true; }

static bool try_connect_known() {
  bool reconnect = s_reconnect_pending;
  s_reconnect_pending = false;
  // Already connected from a previous cycle? Reuse the link — re-scanning
  // and calling WiFi.begin() again every 2 min would otherwise force a
  // disconnect/reconnect and spam the log with the IDF's own
  // early-log noise (the bursts of high-bit bytes that locked_vprintf
  // can't catch because they're written via ets_printf).
  if (WiFi.status() == WL_CONNECTED && !reconnect) {
    set_wifi_status(WIFI_CONNECTED);
    return true;
  }
  if (reconnect && WiFi.status() == WL_CONNECTED) {
    LOG_PRINTLN("[wifi] new credentials saved — dropping the current association");
  }

  storage::WifiCred creds[MAX_WIFI_CREDS];
  size_t n = storage::get_wifi_creds(creds, MAX_WIFI_CREDS);
  if (n == 0) {
    LOG_PRINTLN("[wifi] no saved network — nothing to connect to");
    return false;
  }

  // Log the saved network(s) so the serial console shows exactly which SSID the
  // device is about to try (and how many are stored).
  LOG_PRINTF("[wifi] %u saved network(s):\n", (unsigned)n);
  for (size_t i = 0; i < n; ++i) {
    LOG_PRINTF("[wifi]   [%u] \"%s\"\n", (unsigned)i, creds[i].ssid.c_str());
  }

  // Not connected: clear any lingering "connecting" state before the
  // WiFi.begin() below, then give the IDF a moment to actually leave the
  // connecting state. A prior failed attempt can leave the STA stuck
  // mid-connect; the IDF
  // then rejects the next set_config with "sta is connecting, cannot set
  // config", so the fresh credentials never apply and it never associates.
  // (Background auto-reconnect — the usual source of that stuck state — is
  // disabled in begin(), so we drive every connect from a clean, idle STA.)
  WiFi.disconnect(false, false);
  delay(200);

  // Report the target AP's signal level as this device sees it. Informational
  // only — we always attempt the connect below, so a scan miss (a weak AP is
  // occasionally dropped from a scan) or a hidden SSID never blocks it.
  int found = WiFi.scanNetworks(false, true, false, 300);
  for (size_t i = 0; i < n; ++i) {
    bool seen = false;
    for (int j = 0; j < found; ++j) {
      if (WiFi.SSID(j) == creds[i].ssid) {
        LOG_PRINTF("[wifi] \"%s\" seen at %d dBm (ch %d)\n",
                      creds[i].ssid.c_str(), (int)WiFi.RSSI(j), WiFi.channel(j));
        seen = true;
        break;
      }
    }
    if (!seen) {
      LOG_PRINTF("[wifi] \"%s\" not seen in scan (hidden or out of range)\n",
                    creds[i].ssid.c_str());
    }
  }
  if (found > 0) WiFi.scanDelete();

  // Connect by calling WiFi.begin() directly for each stored network — a SINGLE
  // attempt per cycle. The dual-core WROOM has no BLE/Wi-Fi coexistence problem,
  // but a single attempt per cycle is still the right shape: the natural
  // WIFI_SCAN_INTERVAL_SEC cycle provides the retry cadence instead. We also do
  // NOT gate on the scan above: the IDF connection manager finds the AP's
  // channel itself, which also covers hidden SSIDs.
  bool connected = false;
  for (size_t i = 0; i < n && !connected; ++i) {
    set_wifi_status(WIFI_CONNECTING);
    // Print the exact SSID and password being used so the credential in NVS can
    // be verified against the router. (Diagnostic: the password is echoed in
    // clear text on the serial console.)
    LOG_PRINTF("[wifi] connecting to \"%s\" with password \"%s\" ...\n",
                  creds[i].ssid.c_str(), creds[i].password.c_str());
    s_last_disc_reason = 0;
    WiFi.begin(creds[i].ssid.c_str(), creds[i].password.c_str());
    // Apply TX power immediately after begin(). The WROOM DevKit is externally
    // regulated and has a proper antenna, so it runs at FULL power by default
    // (WIFI_TX_POWER_QDBM = 78 = 19.5 dBm) — unlike the Super Mini, which has to
    // be throttled to keep its weak LDO from sagging mid-TX-burst. The value is
    // still runtime-settable over BLE, so it can be trimmed if a particular
    // install proves marginal. This MUST be reapplied after every begin(): the
    // driver resets TX power on mode changes / reconnect, so a one-time call in
    // setup() silently drifts back to max on the first reconnect.
    WiFi.setTxPower((wifi_power_t)storage::wifi_tx_power_qdbm());
    uint32_t start = millis();
    while (WiFi.status() != WL_CONNECTED &&
           millis() - start < WIFI_CONNECT_TIMEOUT_MS) {
      esp_task_wdt_reset();  // this 15 s wait alone can approach the task WDT
      delay(200);
    }
    if (WiFi.status() == WL_CONNECTED) {
      set_wifi_status(WIFI_CONNECTED);
      LOG_PRINTF("[wifi] connected to %s, ip=%s, rssi=%d dBm\n",
                    creds[i].ssid.c_str(),
                    WiFi.localIP().toString().c_str(), (int)WiFi.RSSI());
      connected = true;
      break;
    }
    // Report the terminal status AND the STA disconnect reason so the console
    // distinguishes a wrong password (reason 15 = 4WAY_HANDSHAKE_TIMEOUT) from
    // AP-not-found (reason 201 = NO_AP_FOUND) from an auth expiry (reason 2,
    // typically a supply/RF problem). status is the Arduino
    // wl_status_t (6 = WL_DISCONNECTED).
    LOG_PRINTF("[wifi] \"%s\" did not connect (status=%d, reason=%d)\n",
                  creds[i].ssid.c_str(), (int)WiFi.status(),
                  (int)s_last_disc_reason);
    WiFi.disconnect(true, true);
  }

  return connected;
}

// Last NTP sync (uint64 monotonic-us) and last good epoch, for rate-limiting.
static uint64_t s_last_ntp_us = 0;
static bool     s_ntp_ever_ok = false;

// Last measured DS1307 drift for the hourly drift log: signed seconds where
// + = RTC ahead of true time (running fast), and the NTP epoch at which it was
// measured (0 = none yet). Sent in the POST; the server logs each distinct
// measurement so drift can be tracked over time.
static long   s_rtc_drift_sec   = 0;
static time_t s_rtc_drift_epoch = 0;

// Last successful ingest POST timestamp (monotonic-us) for the stuck-Wi-Fi
// watchdog. Sentinel 0 means "never since boot".
static uint64_t s_last_post_us = 0;

// Monotonic-us of the last NTP ATTEMPT, successful or not. Separate from
// s_last_ntp_us (last SUCCESS) because the freshness gate keys off success, and
// on its own that let a device which could never reach an NTP server retry on
// every single Wi-Fi cycle. See NTP_RETRY_INTERVAL_SEC.
static uint64_t s_last_ntp_attempt_us = 0;

static bool ntp_sync_if_due() {
  // Skip NTP if the wall clock is already known AND the last sync was less
  // than NTP_RESYNC_INTERVAL_SEC ago. Saves ~4–8 seconds of busy-wait per
  // Wi-Fi cycle when the device cycles every 2 minutes but only needs a
  // fresh time reference once an hour.
  bool wc_known = false;
  if (state_lock()) { wc_known = g_state.wall_clock_known; state_unlock(); }
  uint64_t now_us  = time_source::monotonic_us();
  uint64_t since_s = (now_us - s_last_ntp_us) / 1000000ULL;
  if (s_ntp_ever_ok && wc_known && since_s < (uint64_t)NTP_RESYNC_INTERVAL_SEC) {
    return true;  // recent enough — skip the network round-trip
  }

  // Second gate: rate-limit the ATTEMPT, not just the success. s_last_ntp_us is
  // written only on success, so the gate above cannot throttle a device that
  // never reaches an NTP server at all — it would burn a NTP_SYNC_TIMEOUT_MS
  // busy-wait on every cycle forever.
  if (s_last_ntp_attempt_us != 0 &&
      (now_us - s_last_ntp_attempt_us) / 1000000ULL < (uint64_t)NTP_RETRY_INTERVAL_SEC) {
    return s_ntp_ever_ok;   // no clock gained now, but one may already be held
  }
  s_last_ntp_attempt_us = now_us;

  configTzTime(TZ_INFO, NTP_SERVER_1, NTP_SERVER_2);
  uint32_t start = millis();
  while (millis() - start < NTP_SYNC_TIMEOUT_MS) {
    esp_task_wdt_reset();
    time_t now = time(nullptr);
    if (now > 1700000000) {
      time_source::set_wall_clock(now);
      if (state_lock()) {
        g_state.wall_clock_known = true;
        state_unlock();
      }
      // Mirror NTP-corrected time into the DS1307 so it stays accurate
      // across power loss. Skip the write if the RTC is already within
      // the small drift threshold to limit flash/I2C traffic.
      time_t rtc_now = rtc::read_epoch();
      if (rtc_now > 0) {
        // Capture the signed drift BEFORE any writeback so the hourly log
        // records how far the RTC had wandered. + = RTC ahead (fast).
        s_rtc_drift_sec   = (long)rtc_now - (long)now;
        s_rtc_drift_epoch = now;
      }
      long drift = (long)now - (long)rtc_now;
      if (drift < 0) drift = -drift;
      if (rtc_now == 0 || drift > RTC_WRITEBACK_DRIFT_SEC) {
        if (rtc::write_epoch(now)) {
          LOG_PRINTF("[wifi] RTC writeback ok (drift=%ld sec)\n", drift);
        }
      }
      LOG_PRINTF("[wifi] NTP sync ok, epoch=%ld\n", (long)now);
      s_last_ntp_us = now_us;
      s_ntp_ever_ok = true;
      return true;
    }
    delay(100);
  }
  LOG_PRINTLN("[wifi] NTP sync timed out");
  return false;
}

// Averaged CR2032 coin-cell (RTC backup) voltage in millivolts, read from
// PIN_COINCELL_ADC. analogReadMilliVolts() applies the chip's eFuse ADC
// calibration, so no manual esp_adc_cal work is needed. COINCELL_DIVIDER_RATIO
// scales the pin voltage back to the cell node (1.0 on this build — no
// divider). Reported on each POST.
static uint32_t read_coincell_mv() {
  static bool s_adc_ready = false;
  if (!s_adc_ready) {
    analogSetPinAttenuation(PIN_COINCELL_ADC, ADC_11db);  // ~0–3.1 V full scale
    s_adc_ready = true;
  }
  uint32_t acc = 0;
  for (int i = 0; i < COINCELL_ADC_SAMPLES; ++i) {
    acc += analogReadMilliVolts(PIN_COINCELL_ADC);
  }
  float mv = (float)acc / COINCELL_ADC_SAMPLES * COINCELL_DIVIDER_RATIO;
  return (uint32_t)(mv + 0.5f);
}

// The 16 KB POST request buffer lives here in .bss, NOT on the connectivity
// task stack. The on-stack copy was the documented stack-overflow culprit (see
// config.h CONN_TASK_STACK): the 16 KB doc plus the mbedTLS handshake stacking
// on top of it overflowed and silently corrupted adjacent RAM, faulting only on
// a marginal link where the handshake stacks deepest. Only the connectivity
// task calls post_batch(), so this single-owner static needs no locking.
static StaticJsonDocument<16384> s_post_doc;

// Request body buffer. Static (.bss) rather than a heap String — see the note
// at the serialisation point in post_batch() for why. Only the connectivity
// task calls post_batch(), so this single owner needs no locking.
static char s_post_body[POST_BODY_BUF_BYTES];

static bool post_batch(uint64_t snapshot_seq, uint64_t &out_acked_seq) {
  // Collect up to SYNC_BATCH_SIZE rows with seq <= snapshot_seq.
  StaticJsonDocument<16384> &doc = s_post_doc;
  doc.clear();
  doc["device_id"] = identity::device_id();
  doc["fw_version"] = identity::fw_version();
  doc["sync_wall_time"] = time_source::iso8601_now();
  doc["current_boot_id"] = storage::boot_id();
  doc["current_boot_uptime_sec"] = (uint32_t)(time_source::monotonic_us() / 1000000ULL);

  // Report current relay state so the server can show a live indicator, plus
  // how many meters/relays this unit has so the server knows how many
  // per-channel schedules to send back.
  doc["relay_on"]      = relay::is_on();
  doc["relay_mode"]    = relay::mode_str();   // "auto" | "on" | "off"
  doc["relay_version"] = relay::version();
  doc["channel_count"] = 1;
  doc["relay_count"]   = 1;

  // Hourly DS1307 drift (signed seconds, + = RTC ahead of true time), measured
  // at the last NTP sync. rtc_drift_epoch is the NTP epoch of that measurement;
  // the server dedups on (device_id, epoch) so each hourly sample is logged
  // once even though it rides every 2-minute POST until the next sync.
  if (s_rtc_drift_epoch > 0) {
    doc["rtc_drift_sec"]   = s_rtc_drift_sec;
    doc["rtc_drift_epoch"] = (uint32_t)s_rtc_drift_epoch;
  }

  // Connected-AP Wi-Fi signal strength (dBm, negative). This POST always runs
  // over Wi-Fi, so RSSI is valid; the server logs it alongside the RTC drift
  // sample and caches the latest for the admin list.
  doc["wifi_rssi"] = (int)WiFi.RSSI();

  // CR2032 coin-cell (RTC backup) voltage (millivolts). Logged next to the RTC
  // drift sample and cached as the latest for the admin list.
  doc["coincell_mv"] = read_coincell_mv();

  JsonArray hist = doc.createNestedArray("boot_history");
  storage::BootRecord recs[MAX_BOOT_HISTORY];
  size_t hn = storage::get_boot_history(recs, MAX_BOOT_HISTORY);
  for (size_t i = 0; i < hn; ++i) {
    JsonObject o = hist.createNestedObject();
    o["boot_id"] = recs[i].boot_id;
    o["duration_sec"] = recs[i].duration_sec;
  }

  JsonArray readings = doc.createNestedArray("readings");
  uint64_t max_in_batch = 0;
  uint32_t included = 0;
  storage::stream_rows_up_to(snapshot_seq, [&](const storage::RowFields &r) -> bool {
    if (included >= SYNC_BATCH_SIZE) return false;
    JsonObject o = readings.createNestedObject();
    o["seq"] = r.seq;
    o["boot_id"] = r.boot_id;
    o["sec"] = r.sec_since_boot;
    o["V"] = r.V;
    o["I"] = r.I;
    o["P"] = r.P;
    o["Wh"] = r.Wh;
    o["PF"] = r.PF;
    o["Hz"] = r.Hz;
    // Wall-clock time of the sample (UTC epoch), when the clock was known.
    // The server prefers it for rows from earlier boots, where the uptime
    // chain cannot account for time spent powered off.
    if (r.epoch) o["t"] = r.epoch;
    if (r.seq > max_in_batch) max_in_batch = r.seq;
    included++;
    return true;
  });

  if (included == 0) {
    // Empty buffer. Decide whether to send a config-fetch heartbeat anyway.
    uint64_t now_us = time_source::monotonic_us();
    bool heartbeat_due =
        (s_last_successful_post_us == 0) ||
        ((now_us - s_last_successful_post_us) >=
         (uint64_t)CONFIG_HEARTBEAT_SEC * 1000000ULL);
    if (!heartbeat_due) {
      out_acked_seq = snapshot_seq;
      return true;  // recently POSTed, truly nothing to send
    }
    // Fall through and POST with an empty readings array. Server can use
    // this opportunity to push log_interval_sec / server_time / etc.
    LOG_PRINTLN("[wifi] heartbeat POST (empty readings) to refresh config");
  }

  // Compose URL: NVS-configured host (BLE-settable) or the compiled default,
  // then the hardcoded path. Strip any trailing slash from the host so we
  // don't double up.
  String host = storage::ingest_host();
  if (host.isEmpty()) host = INGEST_HOST_DEFAULT;
  while (host.endsWith("/")) host.remove(host.length() - 1);
  String url = host + INGEST_PATH;
  bool is_https = url.startsWith("https://");

  // Heap guard — see HEAP_MIN_* in config.h. A TLS handshake needs one large
  // CONTIGUOUS allocation for mbedTLS's record buffers, so it is the first thing
  // to fail as the heap fragments. Only TLS needs that block, so a plain-HTTP
  // bench stub is never gated.
  if (is_https) {
    uint32_t free_heap = esp_get_free_heap_size();
    uint32_t largest   = (uint32_t)heap_caps_get_largest_free_block(MALLOC_CAP_8BIT);
    if (free_heap < HEAP_MIN_FREE_BYTES ||
        largest   < HEAP_MIN_LARGEST_BLOCK_BYTES) {
      if (s_last_successful_post_us == 0) {
        // NEVER POSTED THIS BOOT, so the heap is as good as it is ever going to
        // be — if it is already under the line, the LINE is wrong, not the heap,
        // and no amount of deferring or rebooting will improve it. Post anyway.
        //
        // This exemption exists because the alternative was demonstrated in the
        // field: a threshold set above at-rest free tripped on the first POST of
        // every boot, three deferrals rebooted the device, and it never posted
        // again — a ~2 minute reboot loop that also destroyed the only evidence
        // that would have identified the bad threshold. A guard is for a heap
        // that DEGRADED while running; a fresh boot that cannot clear it is a
        // misconfiguration, and the recoverable failure is the right one to
        // take. Deliberately does not touch s_low_heap_cycles, so the watchdog
        // in the connectivity task cannot fire before a POST has ever landed.
        LOG_PRINTF("[wifi] low heap at boot (free=%u largest=%u) — posting anyway; "
                   "HEAP_MIN_* look wrong for this build\n",
                      (unsigned)free_heap, (unsigned)largest);
      } else {
        s_low_heap_cycles++;
#if HEAP_LOW_REBOOT_CYCLES > 0
        // Skip the POST rather than drive a handshake into a starved heap. This
        // is only safe BECAUSE the heap watchdog in the connectivity task will
        // reboot us out of it: a C heap never compacts, so deferring is not
        // itself a recovery. The rows stay buffered either way.
        LOG_PRINTF("[wifi] low heap — deferring POST (free=%u largest=%u, %u in a row)\n",
                      (unsigned)free_heap, (unsigned)largest,
                      (unsigned)s_low_heap_cycles);
        return false;
#else
        // Reboot escalation is off, so deferring here would be a ONE-WAY TRIP —
        // nothing would ever recover the device and it would go quiet for good.
        // So report and POST anyway: a failed handshake is recoverable, a silent
        // stop is not.
        LOG_PRINTF("[wifi] low heap (free=%u largest=%u, %u in a row) — posting anyway\n",
                      (unsigned)free_heap, (unsigned)largest,
                      (unsigned)s_low_heap_cycles);
#endif
      }
    } else {
      s_low_heap_cycles = 0;
    }
  }

  // Serialise into the static .bss buffer, NOT a heap String: serializeJson()'s
  // Arduino String writer appends in 32-byte chunks via String::concat(), so an
  // N-KB body was assembled through hundreds of reallocations, each asking for a
  // slightly larger contiguous block and abandoning the previous one. That was
  // the single largest source of fragmentation in this task — and fragmentation
  // is what eventually starves the handshake above. Reserving the String up
  // front does NOT help: Writer<::String>'s constructor assigns
  // `str = (const char*)0`, freeing whatever was reserved.
  //
  // Measure before writing: the fixed-buffer serializeJson() overload truncates
  // SILENTLY if the document does not fit, which would put malformed JSON on the
  // wire. Refuse instead and say what to change — the rows stay buffered and
  // ship once the body fits.
  size_t body_len = measureJson(doc);
  if (body_len >= sizeof(s_post_body)) {
    LOG_PRINTF("[wifi] body %u B exceeds %u B buffer — lower SYNC_BATCH_SIZE or "
               "raise POST_BODY_BUF_BYTES\n",
               (unsigned)body_len, (unsigned)sizeof(s_post_body));
    return false;
  }
  serializeJson(doc, s_post_body, sizeof(s_post_body));

  // The client and HTTPClient live in an explicit scope so their destructors run
  // BEFORE the heap is measured below. Without that the "free heap" reading was
  // taken while the live TLS session still held its buffers — on this board that
  // is tens of KB, so the logged figure understated real free memory by roughly
  // that much and made a healthy device look nearly out of RAM. Every heap
  // threshold in config.h is derived from these numbers, so the scope matters.
  int    code = -1;
  String resp;
  uint32_t heap_pre = esp_get_free_heap_size();
  uint32_t heap_in  = 0;
#if HEAP_TRACE_POST
  // Free heap after each stage of the transaction. The stages must account for
  // every byte between heap_pre and heap_post, so whichever one takes memory
  // that its matching teardown never returns IS the leak.
  uint32_t hb[5] = {0, 0, 0, 0, 0};
#endif
  {
    WiFiClientSecure client;
    client.setInsecure();  // TODO: cert pinning
    // Cap the TLS handshake so a stall on a marginal link can't block this task
    // past the task watchdog — see the budget note on TLS_HANDSHAKE_TIMEOUT_S.
    client.setHandshakeTimeout(TLS_HANDSHAKE_TIMEOUT_S);
    HTTPClient http;
    http.setConnectTimeout(TCP_CONNECT_TIMEOUT_MS);  // bound the TCP connect
    http.setTimeout(HTTP_TIMEOUT_MS);                // bound the response read
#if HEAP_TRACE_POST
    hb[0] = esp_get_free_heap_size();   // both objects constructed
#endif

    bool ok;
    if (is_https) {
      ok = http.begin(client, url);
    } else {
      ok = http.begin(url);  // plain HTTP for bench stub
    }
    if (!ok) {
      LOG_PRINTLN("[wifi] http.begin failed");
      return false;
    }
    http.addHeader("Content-Type", "application/json");
    http.addHeader("X-Device-Token", DEVICE_TOKEN);
#if HEAP_TRACE_POST
    hb[1] = esp_get_free_heap_size();   // begin() + headers
#endif

    s_radio_busy = true;
    set_wifi_status(WIFI_SYNCING);
    led::signal_tx();  // flash the status LED to show data going out
    // Feed the task WDT immediately before the blocking call: connect +
    // handshake + response read is the longest unfed span in this task, ~23 s
    // worst case against a 30 s panic watchdog.
    esp_task_wdt_reset();
    code = http.POST((uint8_t *)s_post_body, body_len);
#if HEAP_TRACE_POST
    hb[2] = esp_get_free_heap_size();   // TCP connect + TLS handshake + send
#endif
    resp = http.getString();
#if HEAP_TRACE_POST
    hb[3] = esp_get_free_heap_size();   // response body read into resp
#endif
    http.end();
    s_radio_busy = false;
    heap_in = esp_get_free_heap_size();   // after end(), before destructors
#if HEAP_TRACE_POST
    hb[4] = heap_in;
#endif
  }
  // client + http destructed here.

  // Per-POST heap accounting:
  //   pre  = free before the TLS session is built
  //   in   = free while it is live; pre-in (reported as tls) is what TLS costs
  //   post = free after teardown
  //   dpost= post-pre
  // dpost is NOT the leak: `resp` still holds the response body here and is
  // freed on return, so dpost overstates the loss by roughly the response size
  // — hence resp= alongside it, to be subtracted by eye. The authoritative
  // per-cycle figure is net= on the [heap] cycle line.
  {
    uint32_t heap_post = esp_get_free_heap_size();
    LOG_PRINTF("[wifi] heap pre=%u in=%u post=%u tls=%u dpost=%+d resp=%u largest=%u min=%u\n",
                  (unsigned)heap_pre, (unsigned)heap_in, (unsigned)heap_post,
                  (unsigned)(heap_pre > heap_in ? heap_pre - heap_in : 0),
                  (int)((int32_t)heap_post - (int32_t)heap_pre),
                  (unsigned)resp.length(),
                  (unsigned)heap_caps_get_largest_free_block(MALLOC_CAP_8BIT),
                  (unsigned)esp_get_minimum_free_heap_size());
#if HEAP_TRACE_POST
    // Stage-by-stage; the six deltas sum exactly to dpost above. A clean
    // transaction has post+read taken back by end+dtor — whatever is missing
    // from that pairing is the per-POST leak, and this names which call failed
    // to give it back. `read` keeps resp alive past dtor, so it legitimately
    // does not return here: subtract resp= above.
    LOG_PRINTF("[wifi] bisect ctor=%+d begin=%+d post=%+d read=%+d end=%+d dtor=%+d\n",
                  (int)((int32_t)hb[0] - (int32_t)heap_pre),
                  (int)((int32_t)hb[1] - (int32_t)hb[0]),
                  (int)((int32_t)hb[2] - (int32_t)hb[1]),
                  (int)((int32_t)hb[3] - (int32_t)hb[2]),
                  (int)((int32_t)hb[4] - (int32_t)hb[3]),
                  (int)((int32_t)heap_post - (int32_t)hb[4]));
#endif
  }

  if (code == 409) {
    // Seq collision: the server already holds different readings under some of
    // these seqs (this unit's counter restarted, e.g. after a full flash erase).
    // It stored nothing from this batch; renumber the buffer above its highest
    // seq and resend straight away.
    StaticJsonDocument<192> cdoc;
    if (!deserializeJson(cdoc, resp) &&
        strcmp(cdoc["error"] | "", "seq_collision") == 0) {
      uint64_t floor_seq = cdoc["seq_floor"] | (uint64_t)0;
      LOG_PRINTF("[wifi] server reports seq collision, floor=%llu — renumbering buffer\n",
                 (unsigned long long)floor_seq);
      if (storage::rebase_seq(floor_seq)) request_immediate_sync();
      return false;
    }
  }
  if (code != 200) {
    LOG_PRINTF("[wifi] POST failed: code=%d body=%s\n", code, resp.c_str());
    return false;
  }
  // Relay config arrives as relay_channels[] (one entry here: ch 1). The
  // filter keeps only the fields this function reads. An overflowing
  // StaticJsonDocument fails the parse OUTRIGHT — the POST then counts as
  // failed, so the rows it delivered are never truncated and get resent
  // forever while the buffer fills, and no config is picked up.
  //
  // Sized for the server's limit of 8 open-hours windows (admin_relay.php).
  //
  // static, not a local: the connectivity task shares its stack with the
  // mbedTLS handshake (see CONN_TASK_STACK). Only this task calls post_batch(),
  // so single shared instances are safe.
  static StaticJsonDocument<2560> rdoc;
  static StaticJsonDocument<384> rfilter;
  if (rfilter.isNull()) {
    for (const char *k : {"ok", "acked_up_to_seq", "server_time", "log_interval_sec",
        "nightly_reboot_enable", "nightly_reboot_start_hour", "nightly_reboot_end_hour",
        "radio_rest_interval_sec", "radio_rest_duration_sec"}) {
      rfilter[k] = true;
    }
    rfilter["relay_channels"] = true;
  }
  rdoc.clear();
  if (deserializeJson(rdoc, resp, DeserializationOption::Filter(rfilter))) {
    LOG_PRINTF("[wifi] bad response JSON: %s\n", resp.c_str());
    return false;
  }
  if (!(rdoc["ok"] | false)) {
    LOG_PRINTF("[wifi] server rejected: %s\n", resp.c_str());
    return false;
  }
  uint64_t acked = rdoc["acked_up_to_seq"] | 0;
  if (acked == 0) acked = max_in_batch;
  out_acked_seq = acked;
  s_last_successful_post_us = time_source::monotonic_us();

  // Optional: server-pushed logging cadence. Lets ops change the 15-min
  // default to anything between 60 s and 86400 s without reflashing. Values
  // outside that range are silently rejected by storage::set_log_interval_sec().
  uint32_t srv_log_int = rdoc["log_interval_sec"] | 0;
  if (srv_log_int > 0) {
    if (storage::set_log_interval_sec(srv_log_int)) {
      LOG_PRINTF("[wifi] log_interval_sec from server: %u\n", srv_log_int);
    } else {
      LOG_PRINTF("[wifi] log_interval_sec %u out of range, ignored\n", srv_log_int);
    }
  }

  // Optional: server-pushed maintenance config. Each field is independent and an
  // absent field leaves the cached value alone, so the server can push one knob
  // without restating the rest. storage:: validates and ignores nonsense, which
  // is why a bad push cannot strand a device with its radio off or its nightly
  // reboot mis-scheduled.
  if (rdoc.containsKey("nightly_reboot_enable") ||
      rdoc.containsKey("nightly_reboot_start_hour") ||
      rdoc.containsKey("nightly_reboot_end_hour")) {
    bool    en = rdoc["nightly_reboot_enable"]     | storage::nightly_reboot_enabled();
    uint8_t sh = rdoc["nightly_reboot_start_hour"] | storage::nightly_reboot_start_hour();
    uint8_t eh = rdoc["nightly_reboot_end_hour"]   | storage::nightly_reboot_end_hour();
    if (storage::set_nightly_reboot(en, sh, eh)) {
      LOG_PRINTF("[wifi] nightly reboot from server: %s %02u:00-%02u:00\n",
                    en ? "on" : "off", (unsigned)sh, (unsigned)eh);
    } else {
      LOG_PRINTF("[wifi] nightly reboot %02u:00-%02u:00 invalid, ignored\n",
                    (unsigned)sh, (unsigned)eh);
    }
  }
  if (rdoc.containsKey("radio_rest_interval_sec") ||
      rdoc.containsKey("radio_rest_duration_sec")) {
    uint32_t ri = rdoc["radio_rest_interval_sec"] | storage::radio_rest_interval_sec();
    uint32_t rd = rdoc["radio_rest_duration_sec"] | storage::radio_rest_duration_sec();
    if (storage::set_radio_rest(ri, rd)) {
      LOG_PRINTF("[wifi] radio rest from server: every %u s for %u s\n",
                    (unsigned)ri, (unsigned)rd);
    } else {
      LOG_PRINTF("[wifi] radio rest %u/%u s invalid, ignored\n",
                    (unsigned)ri, (unsigned)rd);
    }
  }

  // Server-pushed relay config: relay_channels[] with one entry per relay —
  // {ch, version, schedule[], compressor_watts, grace_min}. This build has
  // one relay, so only ch 1 applies. relay::apply() is a no-op when nothing
  // changed; 0 leaves a cutoff knob unchanged.
  if (rdoc.containsKey("relay_channels")) {
    for (JsonObject rc : rdoc["relay_channels"].as<JsonArray>()) {
      if ((rc["ch"] | 0) != 1) continue;
      String sched_json;
      if (rc.containsKey("schedule")) serializeJson(rc["schedule"], sched_json);
      else                            sched_json = "[]";
      relay::apply(rc["version"] | 0, sched_json,
                   rc["compressor_watts"] | 0,   // 0 = leave unchanged
                   rc["grace_min"]        | 0);
    }
  }

  // Server-time fallback: if neither the DS1307 nor NTP gave us a wall
  // clock, seed time_source from the server's response. The server
  // returns server_time as an ISO 8601 string (MilesWeb is in UTC by
  // default; APP_TIMEZONE in secrets.php can change that).
  const char *srv_time = rdoc["server_time"] | (const char *)nullptr;
  if (srv_time && !time_source::wall_clock_known()) {
    time_t srv_epoch = time_source::parse_iso8601(srv_time);
    if (srv_epoch > 0 && time_source::set_wall_clock(srv_epoch)) {
      if (state_lock()) {
        g_state.wall_clock_known = true;
        state_unlock();
      }
      // Persist into the RTC if it's present (even if it had been marked
      // unavailable due to lost-power; this restarts the oscillator).
      rtc::write_epoch(srv_epoch);
      LOG_PRINTF("[wifi] wall clock seeded from server_time: %s\n", srv_time);
    }
  }

  LOG_PRINTF("[wifi] POST ok, %u rows, acked_up_to=%llu\n",
                included, (unsigned long long)acked);
  s_last_post_us = time_source::monotonic_us();
  return true;
}

uint32_t seconds_since_last_successful_post() {
  if (s_last_post_us == 0) return UINT32_MAX;
  return (uint32_t)((time_source::monotonic_us() - s_last_post_us) / 1000000ULL);
}

void begin() {
  WiFi.mode(WIFI_STA);
  // Drive every (re)connect ourselves from run_cycle()/try_connect_known()
  // instead of letting the IDF auto-reconnect in the background. On the
  // the auto-reconnect handler fires a fresh esp_wifi_connect()
  // the instant an attempt fails and races our own WiFi.disconnect()/
  // WiFi.begin(), which makes esp_wifi_set_config() reject the new credentials
  // with "sta is connecting, cannot set config" (seen in the serial log) — so
  // the SSID/password never apply and the device never associates. With
  // auto-reconnect off, each connect starts from a clean, idle STA. We already
  // reconnect on every 2-minute cycle (and immediately on a sync request), and
  // try_connect_known() early-returns while the link is up, so continuous
  // reachability is preserved without the racing background reconnector.
  WiFi.setAutoReconnect(false);
  WiFi.persistent(false);
  // Capture STA disconnect reason codes for the connect-failure diagnostics.
  WiFi.onEvent(on_wifi_event);
}

bool is_radio_busy() { return s_radio_busy; }

uint32_t consecutive_low_heap_cycles() { return s_low_heap_cycles; }

bool is_associated() { return WiFi.isConnected(); }

void radio_off() {
  // disconnect(true, true) drops the association and clears the stored config;
  // WIFI_OFF is what actually stops the PHY. disconnect() alone would leave the
  // interface up and the driver free to re-associate immediately, which is not
  // a rest — and reusing the same stale association is exactly what this is
  // meant to break.
  WiFi.disconnect(true, true);
  WiFi.mode(WIFI_OFF);
  s_radio_busy = false;
  set_wifi_status(WIFI_IDLE);
}

void radio_on() {
  WiFi.mode(WIFI_STA);
  WiFi.setAutoReconnect(false);   // see begin() — we drive reconnects ourselves
  WiFi.persistent(false);
}

void request_immediate_sync() { s_immediate_sync_pending = true; }
bool consume_immediate_sync_request() {
  if (!s_immediate_sync_pending) return false;
  s_immediate_sync_pending = false;
  return true;
}

void request_scan() { s_scan_pending = true; }
bool consume_scan_request() {
  if (!s_scan_pending) return false;
  s_scan_pending = false;
  return true;
}

String get_scan_results_json() { return s_scan_results_json; }
uint32_t scan_results_version() { return s_scan_version; }

void run_scan() {
  s_radio_busy = true;
  set_wifi_status(WIFI_SCANNING);
  // scanNetworks(async=false, show_hidden=false, passive=false, max_ms_per_chan=300)
  int n = WiFi.scanNetworks(false, false, false, 300);
  StaticJsonDocument<2048> doc;
  JsonArray arr = doc.to<JsonArray>();
  // Sort indices by RSSI (descending) and take top MAX_SCAN_RESULTS.
  int idx[64];
  int total = n;
  if (total < 0) total = 0;
  if (total > 64) total = 64;
  for (int i = 0; i < total; ++i) idx[i] = i;
  for (int i = 1; i < total; ++i) {
    int key = idx[i];
    int j = i - 1;
    while (j >= 0 && WiFi.RSSI(idx[j]) < WiFi.RSSI(key)) {
      idx[j + 1] = idx[j];
      --j;
    }
    idx[j + 1] = key;
  }
  int emit = total < MAX_SCAN_RESULTS ? total : MAX_SCAN_RESULTS;
  for (int i = 0; i < emit; ++i) {
    JsonObject o = arr.createNestedObject();
    o["s"] = WiFi.SSID(idx[i]);
    o["r"] = WiFi.RSSI(idx[i]);
    o["e"] = (WiFi.encryptionType(idx[i]) != WIFI_AUTH_OPEN) ? 1 : 0;
  }
  WiFi.scanDelete();
  String out;
  serializeJson(doc, out);
  s_scan_results_json = out;
  s_scan_version++;
  s_radio_busy = false;
  set_wifi_status(WIFI_IDLE);
  LOG_PRINTF("[wifi] scan complete: %d AP(s), emitted %d\n", n, emit);
}

bool run_cycle() {
#if HEAP_TRACE_CYCLE
  // Per-phase heap accounting for this cycle. idle + connect + ntp + post
  // accounts for ALL heap movement since the last completed cycle, so the four
  // columns sum to the drop between consecutive `free` values and whichever is
  // consistently negative owns the leak. Single-cycle values are noisy
  // (+/-400 B) — the sign of the AVERAGE over many cycles is the signal.
  uint32_t h_start = esp_get_free_heap_size();
  int32_t  d_idle  = s_heap_prev_cycle_end
                       ? (int32_t)h_start - (int32_t)s_heap_prev_cycle_end : 0;
#endif
  // Optionally quiet BLE for the cycle. On the dual-core WROOM this is DISABLED
  // (WIFI_PAUSE_BLE_DURING_SYNC = 0): BLE and Wi-Fi coexist fine, so advertising
  // keeps running throughout the sync and the app stays connectable. The hooks
  // are retained so the guard can be flipped on if a board ever needs it.
#if WIFI_PAUSE_BLE_DURING_SYNC
  ble_service::pause_advertising();
  delay(20);   // let the BLE controller settle off-air before we hit the radio
#endif

  bool result = false;
  if (try_connect_known()) {
#if HEAP_TRACE_CYCLE
    uint32_t h_conn = esp_get_free_heap_size();
#endif
    ntp_sync_if_due();  // NTP_RESYNC_INTERVAL_SEC; OK to proceed even if it fails
#if HEAP_TRACE_CYCLE
    uint32_t h_ntp = esp_get_free_heap_size();
#endif

    uint64_t snapshot = storage::snapshot_max_seq();
    // Loop until all rows up to snapshot have been acked or a POST fails.
    while (true) {
      esp_task_wdt_reset();  // multi-batch drains can span several POSTs
      uint64_t acked = 0;
      if (!post_batch(snapshot, acked)) break;
      if (acked > 0) {
        storage::truncate_up_to(acked);
        // Prune boot_history: any entry older than the oldest remaining row's
        // boot_id is no longer needed (server has it, device won't re-send).
        // If /log.csv is now empty, prune everything older than the current
        // boot so boot_history collapses to just {current_boot}.
        uint32_t min_keep = storage::boot_id();
        storage::stream_rows_up_to(UINT64_MAX, [&](const storage::RowFields &r) -> bool {
          if (r.boot_id < min_keep) min_keep = r.boot_id;
          return true;
        });
        storage::prune_boot_history_below(min_keep);

        if (state_lock()) {
          g_state.unsynced_count = storage::current_unsynced_count();
          state_unlock();
        }
      }
      // If nothing left to send for this snapshot, exit.
      if (storage::current_unsynced_count() == 0) break;
      // If we still have rows with seq <= snapshot (multi-batch case), continue.
      bool more = false;
      storage::stream_rows_up_to(snapshot, [&](const storage::RowFields &) {
        more = true;
        return false;
      });
      if (!more) break;
    }

#if HEAP_TRACE_CYCLE
    {
      // connect = try_connect_known() (scan + WiFi.begin); ntp = configTzTime()
      // plus the SNTP wait; post = the TLS POST(s) and log truncation. `idle`
      // covers a longer span whenever a previous cycle bailed early (no AP),
      // since that path never reaches this point.
      uint32_t h_end = esp_get_free_heap_size();
      LOG_PRINTF("[heap] cycle: idle=%+d connect=%+d ntp=%+d post=%+d net=%+d free=%u\n",
                    (int)d_idle,
                    (int)((int32_t)h_conn - (int32_t)h_start),
                    (int)((int32_t)h_ntp  - (int32_t)h_conn),
                    (int)((int32_t)h_end  - (int32_t)h_ntp),
                    (int)((int32_t)h_end  - (int32_t)h_start) + (int)d_idle,
                    (unsigned)h_end);
      s_heap_prev_cycle_end = h_end;
    }
#endif
    storage::set_last_sync_at((uint32_t)time(nullptr));
    // Stay connected between cycles — do NOT disconnect here. The next cycle's
    // try_connect_known() early-returns on WL_CONNECTED, so we skip the
    // reconnect (no log spam, no IDF re-association noise) and the device
    // stays reachable / shows "Connected" in the app.
    set_wifi_status(WIFI_CONNECTED);
    result = true;
  } else {
    WiFi.disconnect(true, true);
    set_wifi_status(WIFI_IDLE);
    result = false;
  }

#if WIFI_PAUSE_BLE_DURING_SYNC
  ble_service::resume_advertising();
#endif
  return result;
}

}  // namespace wifi_sync
