dditsupport/dd_ac_meter_with_relay_buffer/firmware/esp32.WROOM.DevKit.V1_ds1307_ac_energy_meter/ble_service.cpp

#include "ble_service.h"
#include "config.h"
#include "identity.h"
#include "shared_state.h"
#include "storage.h"
#include "time_source.h"
#include "wifi_sync.h"
#include "rtc.h"
#include "relay.h"
#include "pzem.h"

#include <NimBLEDevice.h>
#include <ArduinoJson.h>
#include <esp_task_wdt.h>
#include <WiFi.h>

#include "mbedtls/md.h"
#include <esp_random.h>

#include <string>
#include <cstring>
#include "log_serial.h"

static inline std::string to_std(const String &s) {
  return std::string(s.c_str(), s.length());
}

// -----------------------------------------------------------------------------
// BLE GATT layout (see docs/PROVISIONING.md for client-side flow):
//   Service: BLE_SERVICE_UUID
//     Auth Challenge  READ       32-hex-char nonce (usable before auth)
//     Auth Response   WRITE      64-hex-char HMAC_SHA256(BLE_PSK, nonce)
//     Device Info     READ       JSON {device_id, fw, unsynced_count, boot_id, uptime_sec}
//     Set Wall Time   WRITE      ISO 8601 string
//     Boot History    READ       JSON [{boot_id, duration_sec}, ...]
//     Data Stream     NOTIFY     CSV rows separated by \n, terminator "END\n"
//     Sync ACK        WRITE      uint64 seq (decimal string) the app forwarded ok
//     Wi-Fi Config    WRITE      JSON {ssid, password}
//     Wi-Fi Status    READ       JSON {ssid, status, ip}
//     Relay           READ/WRITE/NOTIFY  JSON {mode, on, sched_version};
//                     write {"mode":"on|off|auto"} for manual override
// -----------------------------------------------------------------------------
//
// -----------------------------------------------------------------------------
// Target stack: ESP32 Arduino core 3.x + NimBLE-Arduino 2.x. NimBLE 2.x added
// a NimBLEConnInfo& parameter to most callbacks (vs the ble_gap_conn_desc*
// pointer used in 1.x); the firmware tracks the 2.x signatures.
// -----------------------------------------------------------------------------
//
// ACCESS AUTH: an HMAC-SHA256 challenge/response over a static preshared key
// (BLE_PSK) gates every characteristic except the two auth characteristics.
// On connect the device issues a random nonce; the client must write
// HMAC_SHA256(BLE_PSK, nonce) back before any read/write/notify is honoured.
// The key never crosses BLE, and the per-connection nonce blocks replay. This
// keeps generic BLE tools (e.g. nRF Connect) out; it is obfuscation-grade
// deterrence, not link encryption (LE Secure Connections is a future step).

namespace ble_service {

static NimBLEServer *s_server = nullptr;
static NimBLECharacteristic *s_char_info = nullptr;
static NimBLECharacteristic *s_char_set_time = nullptr;
static NimBLECharacteristic *s_char_boots = nullptr;
static NimBLECharacteristic *s_char_stream = nullptr;
static NimBLECharacteristic *s_char_ack = nullptr;
static NimBLECharacteristic *s_char_wifi_cfg = nullptr;
static NimBLECharacteristic *s_char_wifi_status = nullptr;
static NimBLECharacteristic *s_char_wifi_scan = nullptr;
static NimBLECharacteristic *s_char_server_cfg = nullptr;
static NimBLECharacteristic *s_char_relay = nullptr;
static NimBLECharacteristic *s_char_pzem_reset = nullptr;
static NimBLECharacteristic *s_char_factory_reset = nullptr;
static NimBLECharacteristic *s_char_auth_chal = nullptr;
static NimBLECharacteristic *s_char_auth_resp = nullptr;
static String s_last_relay_json = "";
static uint32_t s_last_pushed_scan_version = 0;
static WifiStatus s_last_pushed_wifi_status = WIFI_IDLE;

static volatile bool s_client_connected = false;
static volatile bool s_streaming_active = false;
static volatile bool s_shutdown = false;   // true once shutdown() deinit'd BLE
static volatile bool s_stream_requested = false;
static uint16_t s_mtu = 23;  // default until negotiated

static String s_wifi_status_json = "{\"status\":\"idle\"}";

static void set_ble_status(BleStatus st) {
  if (state_lock()) {
    g_state.ble_status = st;
    state_unlock();
  }
}

// ---- BLE access auth (HMAC-SHA256 challenge/response) ------------------------
// s_auth_handle is the connection handle that has passed the challenge; 0xFFFF
// means none. Reads/writes/notifies are gated on it.
static uint16_t s_auth_handle = 0xFFFF;
static char     s_nonce_hex[33] = {0};   // 16 random bytes -> 32 hex chars + NUL

static inline bool is_authed(NimBLEConnInfo &info) {
  return s_auth_handle != 0xFFFF && info.getConnHandle() == s_auth_handle;
}
// True if some connection is authenticated (used to gate broadcast notifies,
// which carry no per-client handle). Only one client connects at a time here.
static inline bool authed_present() { return s_auth_handle != 0xFFFF; }

static void to_hex(const uint8_t *buf, size_t n, char *out) {
  static const char H[] = "0123456789abcdef";
  for (size_t i = 0; i < n; ++i) {
    out[2 * i]     = H[buf[i] >> 4];
    out[2 * i + 1] = H[buf[i] & 0x0F];
  }
  out[2 * n] = 0;
}

// Fresh 16-byte nonce -> hex -> Challenge characteristic. Called on connect and
// after every response attempt so a used or guessed nonce is never reusable.
static void regen_nonce() {
  uint8_t n[16];
  esp_fill_random(n, sizeof(n));
  to_hex(n, sizeof(n), s_nonce_hex);
  if (s_char_auth_chal) s_char_auth_chal->setValue(std::string(s_nonce_hex));
}

// Constant-time compare of two equal-length buffers.
static bool ct_equal(const char *a, const char *b, size_t n) {
  uint8_t d = 0;
  for (size_t i = 0; i < n; ++i) d |= (uint8_t)a[i] ^ (uint8_t)b[i];
  return d == 0;
}

// expected = lowercase hex of HMAC_SHA256(key = BLE_PSK, msg = current nonce hex).
static void compute_expected(char out65[65]) {
  uint8_t mac[32];
  const mbedtls_md_info_t *mdi = mbedtls_md_info_from_type(MBEDTLS_MD_SHA256);
  mbedtls_md_hmac(mdi,
                  (const unsigned char *)BLE_PSK, strlen(BLE_PSK),
                  (const unsigned char *)s_nonce_hex, strlen(s_nonce_hex),
                  mac);
  to_hex(mac, sizeof(mac), out65);
}

static String build_device_info_json() {
  // 384 B was already close with the host/path strings; the channel_count and
  // relay_count fields push it near the edge, and an overflowing
  // StaticJsonDocument silently truncates the JSON. 512 keeps real margin.
  StaticJsonDocument<512> doc;
  doc["device_id"] = identity::device_id();
  doc["fw"] = identity::fw_version();
  doc["unsynced_count"] = storage::current_unsynced_count();
  doc["current_boot_id"] = storage::boot_id();
  doc["uptime_sec"] = (uint32_t)(time_source::monotonic_us() / 1000000ULL);
  doc["last_seq"] = storage::last_seq();
  doc["expected_row_count"] = storage::current_unsynced_count();
  doc["wall_clock_known"] = time_source::wall_clock_known();
  doc["rtc_ok"] = rtc::available();
  // Live PZEM lifetime meter total (kWh) so the app can show it and verify a
  // reset actually took (the value drops to ~0 after a successful reset).
  {
    SharedState snap;
    if (state_snapshot(snap)) doc["total_kwh"] = snap.total_kwh;
  }
  // Current backend host as actually used by wifi_sync (NVS or compiled
  // default), plus the firmware-hardcoded path so the app can show the
  // full effective URL.
  String host = storage::ingest_host();
  doc["ingest_host"] = host.isEmpty() ? String(INGEST_HOST_DEFAULT) : host;
  doc["ingest_path"] = INGEST_PATH;
  doc["log_interval_sec"] = storage::log_interval_sec();
  // How many PZEM meters and relays this build has. The companion app uses
  // relay_count to decide how many on/off/auto control sets to render, so a
  // 1-relay and a 2-relay device are handled by the same screen.
  doc["channel_count"] = 1;
  doc["relay_count"]   = 1;
  String out;
  serializeJson(doc, out);
  return out;
}

static String build_boot_history_json() {
  StaticJsonDocument<1500> doc;
  JsonArray arr = doc.to<JsonArray>();
  storage::BootRecord recs[MAX_BOOT_HISTORY];
  size_t n = storage::get_boot_history(recs, MAX_BOOT_HISTORY);
  for (size_t i = 0; i < n; ++i) {
    JsonObject o = arr.createNestedObject();
    o["boot_id"] = recs[i].boot_id;
    o["duration_sec"] = recs[i].duration_sec;
  }
  String out;
  serializeJson(doc, out);
  return out;
}

// ---- Server / connection callbacks ------------------------------------------

class ServerCallbacks : public NimBLEServerCallbacks {
  void onConnect(NimBLEServer *srv, NimBLEConnInfo &info) override {
    (void)srv; (void)info;
    s_client_connected = true;
    s_mtu = 23;
    // New connection starts unauthenticated; issue a fresh challenge nonce.
    s_auth_handle = 0xFFFF;
    regen_nonce();
    set_ble_status(BLE_CLIENT_CONNECTED);
    LOG_PRINTLN("[ble] client connected (awaiting auth)");
  }
  void onDisconnect(NimBLEServer *srv, NimBLEConnInfo &info, int reason) override {
    (void)srv; (void)reason;
    if (info.getConnHandle() == s_auth_handle) s_auth_handle = 0xFFFF;
    s_client_connected = false;
    s_stream_requested = false;
    s_streaming_active = false;
    set_ble_status(BLE_ADVERTISING);
    LOG_PRINTLN("[ble] client disconnected, restart advertising");
    NimBLEDevice::startAdvertising();
  }
  void onMTUChange(uint16_t mtu, NimBLEConnInfo &info) override {
    (void)info;
    s_mtu = mtu;
    LOG_PRINTF("[ble] MTU=%u\n", mtu);
  }
};

// ---- Characteristic callbacks -----------------------------------------------

class SetTimeCallbacks : public NimBLECharacteristicCallbacks {
  void onWrite(NimBLECharacteristic *c, NimBLEConnInfo &info) override {
    if (!is_authed(info)) return;
    std::string v = c->getValue();
    if (v.empty()) return;
    time_t epoch = time_source::parse_iso8601(v.c_str());
    if (epoch == 0) {
      LOG_PRINTF("[ble] set_time bad value: %s\n", v.c_str());
      return;
    }
    if (time_source::set_wall_clock(epoch)) {
      if (state_lock()) {
        g_state.wall_clock_known = true;
        state_unlock();
      }
      // Phone time is less authoritative than NTP, but if the DS1307 lost
      // power (or isn't present), seeding it from the phone is still better
      // than nothing. RTClib's adjust() restarts the oscillator.
      if (!rtc::available() && rtc::write_epoch(epoch)) {
        LOG_PRINTLN("[ble] DS1307 seeded from phone time");
      }
      LOG_PRINTF("[ble] wall clock set to %ld\n", (long)epoch);
    }
  }
};

class StreamCallbacks : public NimBLECharacteristicCallbacks {
  void onSubscribe(NimBLECharacteristic *c, NimBLEConnInfo &info, uint16_t subValue) override {
    (void)c;
    if (subValue != 0 && !is_authed(info)) {
      s_stream_requested = false;
      LOG_PRINTLN("[ble] stream subscribe denied (unauth)");
      return;
    }
    if (subValue == 0) {
      s_stream_requested = false;
      s_streaming_active = false;
      LOG_PRINTLN("[ble] stream unsubscribed");
    } else {
      s_stream_requested = true;
      LOG_PRINTLN("[ble] stream subscribed");
    }
  }
};

class AckCallbacks : public NimBLECharacteristicCallbacks {
  void onWrite(NimBLECharacteristic *c, NimBLEConnInfo &info) override {
    if (!is_authed(info)) return;
    std::string v = c->getValue();
    if (v.empty()) return;
    // "rebase:<floor>" — the app relayed rows and the server answered with a
    // seq collision (see storage::rebase_seq). Renumber instead of acking.
    if (v.rfind("rebase:", 0) == 0) {
      uint64_t floor_seq = strtoull(v.c_str() + 7, nullptr, 10);
      if (storage::rebase_seq(floor_seq)) {
        LOG_PRINTF("[ble] buffer renumbered above seq=%llu\n", (unsigned long long)floor_seq);
      }
      return;
    }
    uint64_t acked = strtoull(v.c_str(), nullptr, 10);
    if (acked == 0) {
      LOG_PRINTF("[ble] ack bad value: %s\n", v.c_str());
      return;
    }
    if (storage::truncate_up_to(acked)) {
      if (state_lock()) {
        g_state.unsynced_count = storage::current_unsynced_count();
        state_unlock();
      }
      storage::set_last_sync_at((uint32_t)time(nullptr));
      LOG_PRINTF("[ble] truncated up to seq=%llu\n", (unsigned long long)acked);
    }
  }
};

// Server Config: write JSON {"host":"https://ac.aromen.biz"} to update the
// backend hostname. Path stays hardcoded in INGEST_PATH. Response is
// surfaced via the next Device Info read (ingest_host field).
class ServerCfgCallbacks : public NimBLECharacteristicCallbacks {
  void onWrite(NimBLECharacteristic *c, NimBLEConnInfo &info) override {
    if (!is_authed(info)) return;
    std::string v = c->getValue();
    StaticJsonDocument<256> doc;
    if (deserializeJson(doc, v)) {
      LOG_PRINTF("[ble] server_cfg bad json: %s\n", v.c_str());
      return;
    }
    String host = (const char *)(doc["host"] | "");
    host.trim();
    if (host.isEmpty()) {
      LOG_PRINTLN("[ble] server_cfg empty host, ignored");
      return;
    }
    // If user gave bare hostname without scheme, assume https.
    if (!host.startsWith("http://") && !host.startsWith("https://")) {
      host = "https://" + host;
    }
    if (storage::set_ingest_host(host)) {
      LOG_PRINTF("[ble] ingest host updated: %s\n", host.c_str());
    } else {
      LOG_PRINTLN("[ble] ingest host save failed");
    }
  }
};

// Relay: write {"mode":"on"|"off"|"auto"} to manually drive the relay GPIO.
//   on   -> hold energised, off -> hold de-energised, auto -> follow schedule.
// The new state is reflected back on this characteristic (READ + NOTIFY).
class RelayCallbacks : public NimBLECharacteristicCallbacks {
  void onRead(NimBLECharacteristic *c, NimBLEConnInfo &info) override {
    c->setValue(is_authed(info) ? to_std(relay::status_json()) : std::string());
  }
  void onWrite(NimBLECharacteristic *c, NimBLEConnInfo &info) override {
    if (!is_authed(info)) return;
    std::string v = c->getValue();
    StaticJsonDocument<96> doc;
    if (deserializeJson(doc, v)) {
      LOG_PRINTF("[ble] relay bad json: %s\n", v.c_str());
      return;
    }
    String m = (const char *)(doc["mode"] | "");
    m.toLowerCase();
    if      (m == "on")   relay::set_mode(relay::Mode::FORCE_ON);
    else if (m == "off")  relay::set_mode(relay::Mode::FORCE_OFF);
    else if (m == "auto") relay::set_mode(relay::Mode::AUTO);
    else { LOG_PRINTF("[ble] relay unknown mode: %s\n", m.c_str()); return; }

    // Reflect the resulting state immediately.
    s_last_relay_json = relay::status_json();
    c->setValue(to_std(s_last_relay_json));
    c->notify();
    LOG_PRINTF("[ble] relay set to %s (on=%d)\n", relay::mode_str(), relay::is_on());
  }
};

// Zero the PZEM cumulative energy register. Destructive, so it is gated on BLE
// auth AND an explicit confirmation payload: {"action":"reset_energy"}. The
// actual Modbus reset is deferred to the sampling task via pzem::request_reset()
// so it never races a concurrent read.
class PzemResetCallbacks : public NimBLECharacteristicCallbacks {
  void onWrite(NimBLECharacteristic *c, NimBLEConnInfo &info) override {
    if (!is_authed(info)) return;
    std::string v = c->getValue();
    StaticJsonDocument<96> doc;
    if (deserializeJson(doc, v)) {
      LOG_PRINTF("[ble] pzem-reset bad json: %s\n", v.c_str());
      return;
    }
    String action = (const char *)(doc["action"] | "");
    if (action != "reset_energy") {
      LOG_PRINTF("[ble] pzem-reset ignored (action=%s)\n", action.c_str());
      return;
    }
    pzem::request_reset();
    LOG_PRINTLN("[ble] energy-register reset requested by app");
  }
};

// Factory reset: wipe NVS + buffered readings and reboot into a fresh device.
// Destructive, so it is gated on BLE auth AND an explicit confirmation payload:
// {"action":"factory_reset"}. The actual wipe + reboot is deferred to the main
// loop (storage::consume_factory_reset_request) so it never runs inside this
// NimBLE callback.
class FactoryResetCallbacks : public NimBLECharacteristicCallbacks {
  void onWrite(NimBLECharacteristic *c, NimBLEConnInfo &info) override {
    if (!is_authed(info)) return;
    std::string v = c->getValue();
    StaticJsonDocument<96> doc;
    if (deserializeJson(doc, v)) {
      LOG_PRINTF("[ble] factory-reset bad json: %s\n", v.c_str());
      return;
    }
    String action = (const char *)(doc["action"] | "");
    if (action != "factory_reset") {
      LOG_PRINTF("[ble] factory-reset ignored (action=%s)\n", action.c_str());
      return;
    }
    storage::request_factory_reset();
    LOG_PRINTLN("[ble] factory reset requested by app — device will wipe and reboot");
  }
};

class WifiCfgCallbacks : public NimBLECharacteristicCallbacks {
  void onWrite(NimBLECharacteristic *c, NimBLEConnInfo &info) override {
    if (!is_authed(info)) return;
    std::string v = c->getValue();
    StaticJsonDocument<384> doc;
    if (deserializeJson(doc, v)) {
      s_wifi_status_json = "{\"status\":\"error\",\"detail\":\"bad json\"}";
      s_char_wifi_status->setValue(to_std(s_wifi_status_json));
      s_char_wifi_status->notify();
      return;
    }

    // Command shape: {"action":"scan"}
    String action = (const char *)(doc["action"] | "");
    if (action == "scan") {
      wifi_sync::request_scan();
      s_wifi_status_json = "{\"status\":\"scanning\"}";
      s_char_wifi_status->setValue(to_std(s_wifi_status_json));
      s_char_wifi_status->notify();
      // Force the next tick() to push the post-scan "idle" transition by
      // pretending we already broadcast SCANNING from the periodic path.
      s_last_pushed_wifi_status = WIFI_SCANNING;
      LOG_PRINTLN("[ble] scan requested");
      return;
    }

    // Command shape: {"action":"set_tx_power","dbm":13}  (dbm may be fractional,
    // e.g. 8.5). Stored in quarter-dBm units and applied to the radio now and on
    // every subsequent connect.
    if (action == "set_tx_power") {
      float dbm = doc["dbm"] | 0.0f;
      int qdbm = (int)(dbm * 4.0f + (dbm >= 0 ? 0.5f : -0.5f));
      if (storage::set_wifi_tx_power_qdbm(qdbm)) {
        WiFi.setTxPower((wifi_power_t)qdbm);   // apply immediately; also on next connect
        LOG_PRINTF("[ble] tx power set to %.2f dBm (qdbm=%d)\n", (double)dbm, qdbm);
        s_wifi_status_json = "";  // force tick() to rebuild + push the new value
      } else {
        LOG_PRINTF("[ble] tx power rejected: %.2f dBm (qdbm=%d, valid 2..21 dBm)\n",
                      (double)dbm, qdbm);
      }
      return;
    }

    // Credential shape: {"ssid":"...","password":"..."}
    String ssid = (const char *)(doc["ssid"] | "");
    String pass = (const char *)(doc["password"] | "");
    if (ssid.isEmpty()) {
      s_wifi_status_json = "{\"status\":\"error\",\"detail\":\"empty ssid\"}";
      s_char_wifi_status->setValue(to_std(s_wifi_status_json));
      s_char_wifi_status->notify();
      return;
    }
    if (storage::add_wifi_cred(ssid, pass)) {
      StaticJsonDocument<160> r;
      r["status"] = "saved";
      r["ssid"] = ssid;
      r["next"] = "connecting";
      String out;
      serializeJson(r, out);
      s_wifi_status_json = out;
      s_char_wifi_status->setValue(to_std(s_wifi_status_json));
      s_char_wifi_status->notify();
      wifi_sync::request_reconnect();
      wifi_sync::request_immediate_sync();
      LOG_PRINTF("[ble] wifi cred saved: %s, immediate sync requested\n", ssid.c_str());
    } else {
      s_wifi_status_json = "{\"status\":\"error\",\"detail\":\"save failed\"}";
      s_char_wifi_status->setValue(to_std(s_wifi_status_json));
      s_char_wifi_status->notify();
    }
  }
};

// Auth Response: the client writes lowercase hex of HMAC_SHA256(BLE_PSK, nonce).
// On a match we bind this connection handle as authenticated. The nonce is
// rotated after every attempt so a captured/failed value can't be replayed.
class AuthRespCallbacks : public NimBLECharacteristicCallbacks {
  void onWrite(NimBLECharacteristic *c, NimBLEConnInfo &info) override {
    std::string v = c->getValue();
    for (auto &ch : v) if (ch >= 'A' && ch <= 'F') ch += 32;  // normalise hex case
    char expected[65];
    compute_expected(expected);
    if (v.length() == 64 && ct_equal(v.c_str(), expected, 64)) {
      s_auth_handle = info.getConnHandle();
      LOG_PRINTLN("[ble] auth ok");
    } else {
      if (info.getConnHandle() == s_auth_handle) s_auth_handle = 0xFFFF;
      LOG_PRINTLN("[ble] auth failed");
    }
    regen_nonce();
  }
};

// Gated READ callbacks: an authenticated client gets the live value; an
// unauthenticated client always reads empty. Rebuilding the value here (rather
// than only blanking) means a prior unauthenticated read can't leave a stale
// empty value for the next authenticated read.
class InfoReadCallbacks : public NimBLECharacteristicCallbacks {
  void onRead(NimBLECharacteristic *c, NimBLEConnInfo &info) override {
    c->setValue(is_authed(info) ? to_std(build_device_info_json()) : std::string());
  }
};
class BootsReadCallbacks : public NimBLECharacteristicCallbacks {
  void onRead(NimBLECharacteristic *c, NimBLEConnInfo &info) override {
    c->setValue(is_authed(info) ? to_std(build_boot_history_json()) : std::string());
  }
};
class WifiStatusReadCallbacks : public NimBLECharacteristicCallbacks {
  void onRead(NimBLECharacteristic *c, NimBLEConnInfo &info) override {
    c->setValue(is_authed(info) ? to_std(s_wifi_status_json) : std::string());
  }
};
class WifiScanReadCallbacks : public NimBLECharacteristicCallbacks {
  void onRead(NimBLECharacteristic *c, NimBLEConnInfo &info) override {
    c->setValue(is_authed(info) ? to_std(wifi_sync::get_scan_results_json()) : std::string());
  }
};

// ---- Data stream pump -------------------------------------------------------

static void pump_stream() {
  if (!s_stream_requested || !s_client_connected || !authed_present()) {
    s_streaming_active = false;
    return;
  }
  if (wifi_sync::is_radio_busy()) {
    // Coexistence: pause while Wi-Fi HTTPS POST runs.
    return;
  }
  s_streaming_active = true;

  uint16_t mtu_payload = (s_mtu > 3) ? (s_mtu - 3) : 20;
  if (mtu_payload > 240) mtu_payload = 240;

  // Stream the current snapshot of rows. We use a snapshot by `last_seq` at
  // pump start to avoid sending rows the sampler appends mid-stream.
  uint64_t snap = storage::snapshot_max_seq();
  String chunk;
  chunk.reserve(mtu_payload + 64);

  storage::stream_rows_up_to(snap, [&](const storage::RowFields &r) -> bool {
    char line[128];
    // Stream layout (shared with the dual-meter build):
    // seq,boot_id,sec,V,I,P,Wh,PF,Hz,ch,epoch — ch is always 1 here, epoch the
    // wall-clock time (0 = clock unknown).
    int n = snprintf(line, sizeof(line),
                     "%llu,%u,%u,%.2f,%.3f,%.2f,%.2f,%.3f,%.2f,1,%u\n",
                     (unsigned long long)r.seq, r.boot_id, r.sec_since_boot,
                     r.V, r.I, r.P, r.Wh, r.PF, r.Hz, (unsigned)r.epoch);
    if (n <= 0) return true;
    if (chunk.length() + n > mtu_payload) {
      s_char_stream->setValue((uint8_t *)chunk.c_str(), chunk.length());
      s_char_stream->notify();
      chunk = "";
      delay(15);  // small gap to let stack flush
      esp_task_wdt_reset();
      if (!s_client_connected || !s_stream_requested) return false;
    }
    chunk += line;
    return true;
  });

  if (chunk.length() > 0 && s_client_connected && s_stream_requested) {
    s_char_stream->setValue((uint8_t *)chunk.c_str(), chunk.length());
    s_char_stream->notify();
    delay(15);
  }
  // Terminator
  if (s_client_connected && s_stream_requested) {
    const char *eos = "END\n";
    s_char_stream->setValue((uint8_t *)eos, 4);
    s_char_stream->notify();
  }
  // One-shot stream; require client to re-subscribe for a fresh dump.
  s_stream_requested = false;
  s_streaming_active = false;
}

// ---- Setup ------------------------------------------------------------------

void begin() {
  NimBLEDevice::init(identity::ble_name().c_str());
  NimBLEDevice::setPower(3);   // +3 dBm; NimBLE 2.x takes int dBm directly
  NimBLEDevice::setMTU(247);

  s_server = NimBLEDevice::createServer();
  s_server->setCallbacks(new ServerCallbacks());

  NimBLEService *svc = s_server->createService(BLE_SERVICE_UUID);

  // Auth characteristics — the only ones usable before the challenge is passed.
  s_char_auth_chal = svc->createCharacteristic(
      BLE_UUID_AUTH_CHALLENGE, NIMBLE_PROPERTY::READ);
  s_char_auth_resp = svc->createCharacteristic(
      BLE_UUID_AUTH_RESPONSE, NIMBLE_PROPERTY::WRITE);
  s_char_auth_resp->setCallbacks(new AuthRespCallbacks());
  regen_nonce();  // seed an initial nonce before any client connects

  s_char_info = svc->createCharacteristic(
      BLE_UUID_DEVICE_INFO, NIMBLE_PROPERTY::READ);
  s_char_info->setCallbacks(new InfoReadCallbacks());
  s_char_info->setValue(to_std(build_device_info_json()));

  s_char_set_time = svc->createCharacteristic(
      BLE_UUID_SET_WALL_TIME, NIMBLE_PROPERTY::WRITE);
  s_char_set_time->setCallbacks(new SetTimeCallbacks());

  s_char_boots = svc->createCharacteristic(
      BLE_UUID_BOOT_HISTORY, NIMBLE_PROPERTY::READ);
  s_char_boots->setCallbacks(new BootsReadCallbacks());
  s_char_boots->setValue(to_std(build_boot_history_json()));

  s_char_stream = svc->createCharacteristic(
      BLE_UUID_DATA_STREAM, NIMBLE_PROPERTY::NOTIFY);
  s_char_stream->setCallbacks(new StreamCallbacks());

  s_char_ack = svc->createCharacteristic(
      BLE_UUID_SYNC_ACK, NIMBLE_PROPERTY::WRITE);
  s_char_ack->setCallbacks(new AckCallbacks());

  s_char_wifi_cfg = svc->createCharacteristic(
      BLE_UUID_WIFI_CONFIG, NIMBLE_PROPERTY::WRITE);
  s_char_wifi_cfg->setCallbacks(new WifiCfgCallbacks());

  s_char_wifi_status = svc->createCharacteristic(
      BLE_UUID_WIFI_STATUS, NIMBLE_PROPERTY::READ | NIMBLE_PROPERTY::NOTIFY);
  s_char_wifi_status->setCallbacks(new WifiStatusReadCallbacks());
  s_char_wifi_status->setValue(to_std(s_wifi_status_json));

  s_char_wifi_scan = svc->createCharacteristic(
      BLE_UUID_WIFI_SCAN, NIMBLE_PROPERTY::READ | NIMBLE_PROPERTY::NOTIFY);
  s_char_wifi_scan->setCallbacks(new WifiScanReadCallbacks());
  s_char_wifi_scan->setValue(to_std(wifi_sync::get_scan_results_json()));

  s_char_server_cfg = svc->createCharacteristic(
      BLE_UUID_SERVER_CONFIG, NIMBLE_PROPERTY::WRITE);
  s_char_server_cfg->setCallbacks(new ServerCfgCallbacks());

  s_char_relay = svc->createCharacteristic(
      BLE_UUID_RELAY,
      NIMBLE_PROPERTY::READ | NIMBLE_PROPERTY::WRITE | NIMBLE_PROPERTY::NOTIFY);
  s_last_relay_json = relay::status_json();
  s_char_relay->setValue(to_std(s_last_relay_json));
  s_char_relay->setCallbacks(new RelayCallbacks());

  // Write-only "zero the energy register" command (auth + confirmation gated).
  s_char_pzem_reset = svc->createCharacteristic(
      BLE_UUID_PZEM_RESET, NIMBLE_PROPERTY::WRITE);
  s_char_pzem_reset->setCallbacks(new PzemResetCallbacks());

  // Write-only "factory reset" command (auth + confirmation gated).
  s_char_factory_reset = svc->createCharacteristic(
      BLE_UUID_FACTORY_RESET, NIMBLE_PROPERTY::WRITE);
  s_char_factory_reset->setCallbacks(new FactoryResetCallbacks());

  svc->start();

  NimBLEAdvertising *adv = NimBLEDevice::getAdvertising();
  adv->addServiceUUID(BLE_SERVICE_UUID);
  adv->setName(identity::ble_name().c_str());
  adv->enableScanResponse(true);  // NimBLE 2.x renamed setScanResponse()
  adv->start();

  set_ble_status(BLE_ADVERTISING);
  LOG_PRINTF("[ble] advertising as %s\n", identity::ble_name().c_str());
}

void tick() {
  if (s_shutdown) return;   // BLE de-initialized at the Wi-Fi handoff
  // Refresh dynamic READ values.
  if (s_char_info) s_char_info->setValue(to_std(build_device_info_json()));
  if (s_char_boots) s_char_boots->setValue(to_std(build_boot_history_json()));

  // Mirror live Wi-Fi state into the status characteristic and notify on
  // change. We report the REAL station association (WiFi.isConnected) rather
  // than the transient connectivity state-machine enum — the enum returns to
  // IDLE between sync cycles even while the STA stays joined, which made the
  // app show "Idle" for a device that's actually online. When connected we
  // include the SSID and IP so the app can display them.
  {
    // Saved SSID + current TX power ride the status JSON regardless of
    // connection state, so the app's Wi-Fi screen can show what's configured
    // even while the device is offline. The password is never exposed.
    storage::WifiCred creds[MAX_WIFI_CREDS];
    size_t nc = storage::get_wifi_creds(creds, MAX_WIFI_CREDS);
    String saved_ssid = nc > 0 ? creds[0].ssid : String();
    float tx_dbm = storage::wifi_tx_power_qdbm() / 4.0f;

    String out;
    if (WiFi.isConnected()) {
      StaticJsonDocument<256> doc;
      doc["status"] = "connected";
      doc["ssid"]   = WiFi.SSID();
      doc["ip"]     = WiFi.localIP().toString();
      doc["saved_ssid"]   = saved_ssid;
      doc["tx_power_dbm"] = tx_dbm;
      serializeJson(doc, out);
    } else {
      // Not associated — surface the transient state so the user still sees
      // "scanning"/"connecting" progress, otherwise "disconnected".
      SharedState snap;
      const char *st = "disconnected";
      if (state_snapshot(snap)) {
        switch (snap.wifi_status) {
          case WIFI_SCANNING:   st = "scanning"; break;
          case WIFI_CONNECTING: st = "connecting"; break;
          default:              st = "disconnected"; break;
        }
      }
      StaticJsonDocument<192> doc;
      doc["status"] = st;
      doc["saved_ssid"]   = saved_ssid;
      doc["tx_power_dbm"] = tx_dbm;
      serializeJson(doc, out);
    }
    if (out != s_wifi_status_json) {
      s_wifi_status_json = out;
      if (s_char_wifi_status) {
        s_char_wifi_status->setValue(to_std(out));
        if (authed_present()) s_char_wifi_status->notify();
      }
    }
  }

  // Mirror live relay state (schedule- or override-driven) and notify on
  // change so the app's toggle stays in sync without polling.
  if (s_char_relay) {
    String rj = relay::status_json();
    if (rj != s_last_relay_json) {
      s_last_relay_json = rj;
      s_char_relay->setValue(to_std(rj));
      if (authed_present()) s_char_relay->notify();
    }
  }

  // Push new scan results when the version counter advances.
  uint32_t sv = wifi_sync::scan_results_version();
  if (sv != s_last_pushed_scan_version && s_char_wifi_scan) {
    s_char_wifi_scan->setValue(to_std(wifi_sync::get_scan_results_json()));
    if (authed_present()) s_char_wifi_scan->notify();
    s_last_pushed_scan_version = sv;
  }

  if (s_stream_requested) {
    pump_stream();
  }
}

bool is_streaming() { return s_streaming_active; }

bool is_connected() { return !s_shutdown && s_client_connected; }

bool is_alive() {
  if (s_shutdown) return true;   // intentionally off at the handoff — not wedged
  if (s_client_connected) return true;
  NimBLEAdvertising *adv = NimBLEDevice::getAdvertising();
  return adv != nullptr && adv->isAdvertising();
}

void shutdown() {
  if (s_shutdown) return;
  s_shutdown = true;
  s_server = nullptr;   // freed by deinit; null it so pause/resume no-op
  // deinit(true) stops advertising/connections, tears down the host + BT
  // controller, and frees the radio for Wi-Fi.
  NimBLEDevice::deinit(true);
  set_ble_status(BLE_OFF);
  LOG_PRINTLN("[ble] de-initialized (Wi-Fi has the radio now)");
}

void pause_advertising() {
  if (s_server == nullptr) return;   // begin() not run yet
  NimBLEAdvertising *adv = NimBLEDevice::getAdvertising();
  if (adv != nullptr && adv->isAdvertising()) adv->stop();
}

void resume_advertising() {
  if (s_server == nullptr) return;
  // A connected client already keeps BLE alive, and advertising auto-restarts
  // on that client's disconnect, so don't force it here.
  if (s_client_connected) return;
  NimBLEAdvertising *adv = NimBLEDevice::getAdvertising();
  if (adv != nullptr && !adv->isAdvertising()) adv->start();
}

}  // namespace ble_service
