dditsupport/dd_ac_meter_with_relay_buffer/firmware/esp32.WROOM.DevKit.V1_ds1307_ac_energy_meter/storage.h

#pragma once
#include <freertos/FreeRTOS.h>

#include <Arduino.h>
#include <functional>

namespace storage {

struct BootRecord {
  uint32_t boot_id;
  uint32_t duration_sec;
};

struct RowFields {
  uint64_t seq;
  uint32_t boot_id;
  uint32_t sec_since_boot;
  float V;
  float I;
  float P;
  float Wh;
  float PF;
  float Hz;  // mains frequency
  // Wall-clock UTC epoch when the row was sampled, from the DS1307/NTP clock;
  // 0 = clock not known yet. Lets the server timestamp rows from an earlier
  // boot directly instead of estimating from uptimes, which cannot see how
  // long the power was off between boots.
  uint32_t epoch = 0;
};

// Mount LittleFS, run crash recovery (delete /log.tmp, validate last line),
// open NVS namespaces, compute fresh boot_id and persist it.
// Returns true on success.
bool begin();

// NVS getters/setters ---------------------------------------------------------
uint32_t boot_id();
uint64_t last_seq();
void set_last_seq(uint64_t seq);  // updates RAM and writes HWM to NVS if needed
// Serialises seq assignment against rebase_seq(). Writers hold it across
// "seq = last_seq() + 1 -> append_row() -> set_last_seq(seq)".
bool seq_lock(TickType_t ticks);
void seq_unlock();
uint64_t seq_hwm();

// Append the current boot's record once duration is known (e.g. on graceful shutdown).
// Internally used by recoverOnBoot() to chain partial previous boots too.
void push_boot_record(const BootRecord &rec);
size_t get_boot_history(BootRecord *out, size_t max_out);

// Drop boot_history entries with boot_id < min_keep_boot_id. Used after a
// successful sync: once the server has acked rows up to seq N, any history
// entry whose boot_id is older than the oldest remaining row is no longer
// needed by the firmware (the server already has it and the device will not
// re-send rows from that boot).
void prune_boot_history_below(uint32_t min_keep_boot_id);

// Wipe the entire boot_history. Exposed for the CLEARBOOTS serial command.
void clear_boot_history();

// Wi-Fi credentials -----------------------------------------------------------
struct WifiCred {
  String ssid;
  String password;
};
size_t get_wifi_creds(WifiCred *out, size_t max_out);
bool add_wifi_cred(const String &ssid, const String &password);
void clear_wifi_creds();

// last_sync_at (informational)
void set_last_sync_at(uint32_t epoch);
uint32_t last_sync_at();

// Local day number (as returned by time_source::local_day_number()) on which the
// nightly scheduled reboot last fired; 0 = never. Persisted rather than kept in
// RAM precisely because the reboot it triggers would otherwise clear it and the
// schedule would re-fire a second later, in a loop.
uint32_t last_nightly_reboot_day();
void set_last_nightly_reboot_day(uint32_t day);

// ---- Server-pushed maintenance config --------------------------------------
// Cached in NVS so it keeps working through a Wi-Fi outage; the compiled
// *_DEFAULT values in config.h apply only until the server first pushes real
// ones. Setters validate and return false on an out-of-range value, leaving the
// cached value untouched — a malformed push can never disable a device or
// mis-schedule its reboot. All are a no-op on an unchanged value, to limit flash
// wear on a server that restates config in every response.
bool     nightly_reboot_enabled();
uint8_t  nightly_reboot_start_hour();
uint8_t  nightly_reboot_end_hour();
bool     set_nightly_reboot(bool enabled, uint8_t start_hour, uint8_t end_hour);

// interval 0 = periodic rest disabled (on-demand reassociation still works).
uint32_t radio_rest_interval_sec();
uint32_t radio_rest_duration_sec();
bool     set_radio_rest(uint32_t interval_sec, uint32_t duration_sec);

// Backend host (scheme + host + optional port, e.g. "https://ac.aromen.biz").
// Empty string means "use INGEST_HOST_DEFAULT compiled into config.h".
// Updated at runtime via BLE (Server Config characteristic).
String ingest_host();
bool set_ingest_host(const String &host);

// Logging cadence in seconds — the gap between writes to /log.csv. The
// runtime value lives in NVS so it survives reboots. The server can push
// a new value via the {"log_interval_sec": N} field in each ingest.php
// response. Out-of-range values (< LOG_INTERVAL_SEC_MIN or
// > LOG_INTERVAL_SEC_MAX) are rejected.
uint32_t log_interval_sec();
bool set_log_interval_sec(uint32_t sec);

// Wi-Fi TX power in quarter-dBm units — the ESP32 wifi_power_t values are
// exactly dBm*4 (e.g. 52 = 13 dBm, 44 = 11 dBm). Runtime-settable over BLE so
// the installer can trim TX power to what the board's supply/antenna allows;
// falls back to the compiled WIFI_TX_POWER_QDBM default. Valid range 8..84 (2..21 dBm).
int  wifi_tx_power_qdbm();
bool set_wifi_tx_power_qdbm(int qdbm);

// "Today" anchor — the PZEM cumulative-Wh value captured at the start of
// today. today_kwh is computed as (current_pzem_wh - anchor) /
// 1000 so it survives ESP32 reboots without re-integration on the MCU.
//
// today_anchor_wh() returns < 0 when no anchor has ever been written.
// today_anchor_day() is time_source::local_day_number() at the moment the
// anchor was set; if today's day differs, sampling_task re-anchors.
// today_anchor_clean() is true only when the anchor was captured at a
// midnight rollover observed during a single boot (i.e. we have the full
// day's data). False means the anchor was set mid-day (boot, wall-clock
// arrival, day jump across power-off), so the displayed value is partial.
float today_anchor_wh();
uint32_t today_anchor_day();
bool today_anchor_clean();
void set_today_anchor(float wh, uint32_t day, bool clean);

// LittleFS log file -----------------------------------------------------------
// Append a row. Returns true on success, false if buffer full or write error.
bool append_row(const RowFields &row);

// Number of rows currently in /log.csv.
uint32_t row_count();

// Iterate rows with seq <= max_seq, calling cb for each.
// If cb returns false, iteration stops early. Returns count emitted.
uint32_t stream_rows_up_to(uint64_t max_seq, std::function<bool(const RowFields &)> cb);

// Snapshot: take current last_seq from RAM as "max seq to send". This avoids
// scanning the file. Returns the snapshot.
uint64_t snapshot_max_seq();

// Rewrite /log.csv keeping only rows with seq > acked_seq.
// Blocks log appends only during the brief rename. Returns true on success.
bool truncate_up_to(uint64_t acked_seq);

// The server reported a seq collision (this device's counter restarted, e.g.
// after a full flash erase, and reused seqs it already holds). Renumber every
// buffered row so the lowest lands at seq_floor + 1, and move last_seq and the
// NVS high-water mark above it. No-op if the buffer is already above it.
bool rebase_seq(uint64_t seq_floor);

// Free space in bytes on the LittleFS partition.
uint32_t free_bytes();

// Buffer-full guard: returns true if free space is below the threshold.
bool is_buffer_full();

// Update the in-memory unsynced count exposed to SharedState.
uint32_t current_unsynced_count();

// Factory reset ---------------------------------------------------------------
// Wipe the ENTIRE NVS partition (every namespace: cfg, state, relay, health)
// and drop all buffered readings, returning the device to a fresh, unprovisioned
// state. Destructive and irreversible; the caller is expected to reboot right
// after. Because it deinitializes NVS, do not touch any Preferences/NVS after
// calling it — just reboot.
void factory_reset();

// Request/consume flag so a BLE write can ask the main loop to run the reset +
// reboot from a safe context rather than inside the NimBLE callback.
void request_factory_reset();
bool consume_factory_reset_request();

// Serial helpers --------------------------------------------------------------
void dump_log_to_serial();      // for `DUMP` command
void dump_boots_to_serial();    // for `BOOTS` command
void clear_log();               // for `CLEAR` command

}  // namespace storage
