dditsupport/dd_ac_meter_with_relay_buffer/(commit log)

2026-07-03 Retarget to ESP32-C3 + DS1307, compressor-aware AC-cutoff relay, WorkPulse DB integration
    Firmware (FW 2.0.0):
    - Port ESP32-WROOM-32 (dual-core) -> ESP32-C3 Super Mini (single-core, native
    USB-CDC): task affinity to core 0, PZEM on Serial1 (GPIO20/21), new pin map.
    - Replace DS3231 with DS1307 RTC (100 kHz); remove the SSD1306 OLED.
    - NTP: time.google.com + time.cloudflare.com, resync hourly.
    - Relay is now an off-hours AC cutoff (fail-safe NC): schedule = AC-allowed
    open hours; compressor-aware state machine never opens under load and latches
    the cut. compressor_watts / grace_min are server-pushed per device.
    Backend (shared WorkPulse DB):
    - All meter tables prefixed ed_; schema.sql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
2026-07-04 Admin devices: 2-line card layout (no horizontal scroll), wider location
    Replace the wide multi-column devices table with a card list: each device
    renders on two wrapping lines (identity/assignment, then interval/status/
    actions) so nothing overflows the viewport. Location gets the most flex room.
    JS handlers retargeted from tr/td.col-relay to .dev/.col-relay; all field
    classes and the live relay indicator are unchanged.
2026-07-04 Log hourly DS1307 RTC drift to the server
    Firmware: at each hourly NTP sync, capture the signed RTC-vs-NTP offset
    (+ = RTC fast) before writeback and report it (rtc_drift_sec + rtc_drift_epoch)
    on the ingest POST.
    Backend: ed_rtc_drift_log (migration 006) records each distinct measurement
    (INSERT IGNORE dedups the sample resent on every 2-min POST until the next
    sync); the latest is cached on ed_device_meta and shown on the admin device
    card. Guarded so a pre-migration DB still ingests.
    [wifi_sync.cpp]
2026-07-04 Rename firmware/ac_energy_meter to esp32.supermini_ds1307_ac_energy_meter
    Rename the ESP32 sketch directory and update all path references in the
    README files, provisioning docs, bench-test tooling, and Android UUID
    comment.
    Claude-Session: https://claude.ai/code/session_01VBJ7aePkBQJmRR7dGJPqqe
2026-07-04 Add ESP32 WROOM DevKit V1 firmware variant (DS3231 + SSD1306 OLED)
    Add a second, self-contained Arduino sketch targeting the ESP32 WROOM
    DevKit V1 with a DS3231 RTC and an SSD1306 OLED, alongside the existing
    ESP32-C3 Super Mini (DS1307, no display) build. The two firmware folders
    are kept separate, not merged. Update the README repository layout to
    list both variants and note which hardware each targets.
    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
2026-07-04 Move both firmware variants under firmware/ directory
    Nest both ESP32 sketch folders under a top-level firmware/ directory and
    update the README layout plus all path references in the docs, bench-test
    tool, and Android UUID comment accordingly.
    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
2026-07-04 Bring WROOM DevKit V1 firmware to v2.0 (parity with supermini)
    The ESP32 WROOM DevKit V1 (DS3231 + SSD1306) variant was still at
    FW_VERSION 1.0.0 — the old relay convention that energizes INSIDE the
    schedule window — while esp32.supermini_ds1307_ac_energy_meter had
    advanced to the 2.0.0 feature set. Port that feature set into the WROOM
    build so both variants track the same firmware, differing only in
    hardware (pin map, DS3231 vs DS1307, OLED).
    Ported:
    - Compressor-aware, fail-safe NC AC-cutoff relay: schedule now means
    AC-ALLOWED open hours (energize = cut OUTSIDE the window). relay.cpp /
    relay.h copied wholesale (hardware-independent, driven by config.h).
    - config.h: FW_VERSION ->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
    [config.h, esp32.WROOM.DevKit.V1_SSD1306_ds3231_ac_energy_meter.ino, relay.cpp, relay.h, wifi_sync.cpp]
2026-07-04 Relay: always cut by grace deadline, hold until open hours
    Previously, if the compressor stayed idle through the entire grace
    window at closing, the state machine went to IDLE_DONE and never cut for
    the rest of the off-hours period. That let a late AC start (switched on
    after grace expired) run un-cut all night, since nothing re-checked.
    Change the cutoff so the relay always cuts by the grace deadline at the
    latest and latches until the next open-hours start:
    - MONITORING now calls cut_and_latch() when the grace window elapses with
    the compressor idle, instead of transitioning to a no-cut IDLE_DONE.
    - Remove the IDLE_DONE state from the SmState enum and sm_str().
    - The load-safety path is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
2026-07-04 BLE: gate access with HMAC-SHA256 challenge/response
    The BLE GATT service was fully open — any client in range (e.g. nRF
    Connect) could read buffered readings and write Wi-Fi credentials, the
    backend host, relay state, and the clock. The ble_pin was only an
    app-side gate the firmware never saw. Add a firmware-enforced access
    gate so only a client holding the shared key can use the device.
    Design (static preshared key, works offline):
    - New BLE_PSK compile-time secret in config.h (mirrors DEVICE_TOKEN),
    and matching BuildConfig.BLE_PSK in the app build.gradle. Chosen static
    because the ESP32 may have no internet to fetch a per-device secret.
    - Two new characteristics: Auth-Challenge (R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
2026-07-06 Dashboard: plot Watt line at 5-minute resolution on Today/24h
    The power (Watt) line chart on the Today and 24h views was fed from
    hourly P_avg buckets, so it looked coarse and hourly. Add a 5-minute
    aggregate to the readings API and give the power line its own finer
    bucket via a new powerAggregate range option, so short ranges plot
    every ~5-minute posted reading. Energy bars stay hourly because the
    max-min-of-cumulative-Wh method needs several samples per bucket.
    Claude-Session: https://claude.ai/code/session_01CgfhmDXmdKxh4wFLYTwiFC
2026-07-07 Update OLED SPI and DS3231 I2C pin assignments
    Remap the DevKit V1 OLED SPI pins (SCK 23, MOSI 22, RST 21, DC 19, CS 18)
    and DS3231 I2C pins (SDA 4, SCL 15). CS moves off GPIO 5 (strapping pin);
    SCL uses GPIO 15, which idles HIGH via I2C pull-ups so boot is unaffected.
    Claude-Session: https://claude.ai/code/session_01LjmBt9VuKANrwjZden5emd
2026-07-07 Use device's old-meter reading (capacity_kw) in dashboard totals
    The capacity_kw field was stored and returned by the APIs but never
    surfaced anywhere, so setting it had no visible effect. Repurpose it as
    the old meter's last reading (kWh) at install and add it to the dashboard
    Today and Period total figures so those numbers continue from the meter
    the device replaced instead of restarting at zero.
    - dashboard: add baseline (capacity_kw) to stat-today and stat-total
    - admin: relabel the field "kW" -> "Old kWh" with an explanatory tooltip
    - widen capacity_kw DECIMAL(5,2) -> DECIMAL(12,2) (migration 007) so real
    meter readings above 999.99 fit; column name kept to preserve the API
    contrac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
2026-07-07 Relay: active-low output + cut as soon as compressor idles
    Two fixes for the DevKit V1 off-hours AC cutoff:
    - Set RELAY_ACTIVE_HIGH 0 for the inverted-input relay module in use.
    GPIO 26 now idles HIGH to keep the relay de-energized (AC on) and is
    driven LOW to energize the coil (cut AC), matching the board's wiring.
    - Cut the moment wattage drops below the compressor threshold instead of
    always riding out the full grace window. Previously a compressor that was
    already idle at closing waited the entire grace period before cutting
    (MONITORING only cut on the grace deadline; the idle-cut path lived in
    WAIT_FOR_IDLE, reachable only after the compressor had been seen running).
    Mer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
    [config.h, relay.cpp, relay.h]
2026-07-07 Supermini relay: cut as soon as compressor idles
    Apply the same cutoff-logic fix to the esp32.supermini firmware. Merge
    MONITORING/WAIT_FOR_IDLE so the relay cuts the moment wattage drops below
    the compressor threshold (or at the grace deadline if it never idles),
    instead of riding out the full grace window when the AC was already idle at
    closing. An invalid/stale PZEM reading counts as "running" so a possibly-
    loaded compressor is never hard-cut early. Relay polarity is left unchanged
    (board-specific).
    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
    [relay.cpp, relay.h]
2026-07-07 Report: per-day/grand totals use start->end meter difference
    The chart lines stay hourly, but the day totals and grand Total below the
    chart summed the hourly buckets, which drops the energy accrued between
    consecutive hours and read a few percent under the dashboard's figures.
    Fetch the daily aggregate (one MAX-MIN per day) and use those start->end
    differences for each day's total; the grand total is their sum, so it now
    lines up with the dashboard's monthly total. Falls back to the hourly sum
    only if a day is missing from the daily fetch.
    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
2026-07-07 Dashboard: Period total uses start->end delta for 7d/30d/12m
    Summing daily/monthly bars drops the energy accrued in the gaps between
    buckets, so the multi-day Period total read a few percent low. Add a
    range-wide start->end meter difference (single MAX-MIN over the window) to
    the readings API as total_kwh, and use it for the Period total on the 7d,
    30d and 12m ranges. Today/24h keep the bar sum so the stat still tracks the
    hourly chart.
    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
2026-07-07 Report: grand Total uses whole-period start->end difference
    The per-day chips are each day's start->end delta, but summing them ran a
    hair under the dashboard's monthly figure — energy accrued overnight between
    days belongs to no single day's bucket. Use the range-wide start->end delta
    (readings API total_kwh) for the grand Total so it matches the dashboard
    exactly; the per-day chips are unchanged. Falls back to the per-day sum when
    total_kwh is unavailable.
    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
2026-07-07 Telescope daily/monthly buckets so nothing is lost between them
    Each daily/monthly bucket now spans from its own first reading to the NEXT
    present bucket's first reading (e.g. 01-Jun 1st reading -> 02-Jun 1st
    reading; Jun 1st reading -> Jul 1st reading). The gap between buckets —
    overnight, day-to-day, month-to-month — is charged to the earlier bucket
    instead of falling through, so the buckets sum exactly to the range's
    start->end total. The last bucket keeps its own MAX-MIN to absorb the tail
    up to the latest reading.
    Applies to the daily and monthly aggregates only (hourly chart lines are
    unchanged), shared by both the dashboard bars/Period total and the report
    per-day chips/Total. Th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
2026-07-07 Dashboard: Period total = whole-day delta, Today = sum of hourly
    Swap the two cards' definitions on the Today view (and make Period total
    consistent across all ranges):
    - Period total now always uses the range's start->end meter difference
    (server total_kwh) — for Today that's the first reading of the day to the
    current last reading, one big delta that captures the energy between hours
    too. Previously the short ranges summed the hourly bars and read low.
    - Today is now the sum of today's per-hour deltas, so it matches the hourly
    bars on the chart. It was the whole-day daily-bucket delta before.
    Claude-Session: https://claude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
2026-07-07 Handle PZEM register rollover (backend) + BOOT-button energy reset (firmware)
    Backend (readings.php):
    - The PZEM Wh register wraps back to 0 at 9999.99 kWh (9,999,990 Wh);
    differencing across that wrap otherwise reads a huge negative/10,000 kWh
    delta. Add a PZEM_WH_ROLLOVER constant and a wh_span_kwh() guard: on a
    backwards step, if the earlier value is near the ceiling treat it as a wrap
    and add the span past it; a drop from a low value is a meter reset, counted
    as zero so it can't inflate a bucket.
    - Apply the guard to the telescoping daily/monthly bucket diffs, and make
    total_kwh wrap/reset aware (monotonic -> MAX-MIN as before; a wrap uses
    (MAX-first)+last; a reset counts o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
    [config.h, esp32.WROOM.DevKit.V1_SSD1306_ds3231_ac_energy_meter.ino]
2026-07-07 Supermini: BOOT-button energy reset (GPIO 9)
    Mirror the fresh-install energy reset onto the ESP32-C3 Super Mini. The C3's
    BOOT button is GPIO 9 (its download-mode strapping pin), not GPIO 0, so
    PIN_BOOT_BUTTON is 9 here. loop() debounces a 5 s hold and raises a request;
    sampling_task performs pzem::reset_energy() so the Modbus write never races a
    read, then re-anchors the session/today counters. This board has no OLED, so
    the reset logs only (no splash).
    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
    [config.h]
2026-07-07 Log Wi-Fi signal strength (RSSI) alongside RTC drift
    Firmware (both boards): report the connected-AP RSSI (dBm) as wifi_rssi on
    each ingest POST, next to the RTC drift fields.
    Backend:
    - migration 008 + schema: add rssi_dbm to ed_rtc_drift_log (per hourly
    sample) and wifi_rssi to ed_device_meta (latest cached).
    - ingest.php: cache the latest RSSI on device_meta every POST and tag the
    current drift sample's row with it, in separate guarded blocks so a DB
    without migration 008 still logs drift and ingests normally.
    - admin devices list: show "Signal: -NN dBm" next to RTC drift, as its own
    degradable select option.
    Claude-Session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
    [wifi_sync.cpp]
2026-07-08 Supermini relay: active-low to match WROOM (PC817 optocoupler)
    Both boards drive the relay through a PC817 optocoupler, which inverts the
    input, so the pin idles HIGH (relay de-energized / AC on) and is pulled LOW
    to energize (cut AC). Set the supermini's RELAY_ACTIVE_HIGH to 0 to match the
    WROOM, and update both comments to name the PC817 as the reason.
    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
    [config.h]
2026-07-08 Rename supermini sketch to match its folder
    Arduino requires the main .ino to match the sketch folder name. Rename
    ac_energy_meter.ino -> esp32.supermini_ds1307_ac_energy_meter.ino and update
    the README / PROVISIONING open-this-file paths to match.
    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
2026-07-08 Android: relabel register field to old-meter reading (kWh)
    The cloud registration dialog still called the field "Capacity in kW", but
    the backend capacity_kw value is now the old meter's last reading (kWh),
    added to the dashboard totals. Relabel it to "Old meter reading in kWh
    (optional)" with supporting text explaining it. The API form field stays
    capacity_kw (backend contract); only the label/help text changes.
    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
2026-07-08 WiFi: clear stuck "connecting" state before scan/begin
    On the single-core ESP32-C3 (Wi-Fi coexisting with BLE), the STA could get
    stuck mid-connect after a failed attempt / auto-reconnect. The next
    WiFi.begin() was then rejected by the IDF ("sta is connecting, cannot set
    config"), so fresh credentials never applied and the C3 never associated —
    even to a strong, correct AP that the WROOM firmware and a bare scan sketch
    both join fine. Force a WiFi.disconnect() before the scan/begin so set_config
    is accepted. Applied to both boards to keep the Wi-Fi path in sync.
    Claude-Session: https://claude.ai/code/session_01LjmBt9VuKANrwjZden5emd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
    [wifi_sync.cpp]
2026-07-08 Dashboard 24h = full day; report chart survives device switching
    - 24h range now frames the whole calendar day (12 AM -> next 12 AM) with the
    x-axis pinned to 00:00-24:00, instead of a rolling "last 24 h from now" that
    started mid-hour.
    - report.php: destroy any chart still bound to the canvas (via Chart.getChart)
    before creating a new one. Switching devices re-runs load(); a leftover chart
    instance made Chart.js throw "Canvas is already in use", so the new chart
    never rendered (only the day-total chips updated).
    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
2026-07-08 Report: stop toggling canvas display (chart appeared then vanished)
    The chart drew and then immediately disappeared when switching device/range.
    Root cause: load() set the canvas's style.display to none/'' each run, and
    Chart.js's resize observer then re-measured the just-shown canvas to zero,
    collapsing the chart. The dashboard never toggles display and is unaffected.
    Leave the canvas display alone: destroy any existing chart (getChart catches a
    stray the variable lost track of), and when there are no readings just clear
    the canvas instead of hiding it. Fixes the report graph not staying visible.
    Claude-Session: https://claude.ai/cod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
2026-07-08 Supermini WiFi: connect directly, don't gate on scan
    On the single-core ESP32-C3 the radio is time-shared with BLE, so a
    synchronous active WiFi.scanNetworks() often completes only partially
    (or returns 0 APs) even when the AP is in range. try_connect_known()
    required the target SSID to appear in that scan before calling
    WiFi.begin(), so an under-reporting scan meant the device never even
    attempted to associate — and it could never join a hidden SSID.
    Drop the scan gate and call WiFi.begin() directly for the stored
    credential, letting the IDF connection manager locate the AP's channel
    (coexistence-aware and retrying). The disconnect-before-begin fix is
    kept. The BLE-driven run_scan() path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
    [wifi_sync.cpp]
2026-07-08 Supermini WiFi: log target SSID + stop auto-reconnect race
    Serial log now shows the saved network list and prints "connecting to
    <SSID>" before each attempt, plus the terminal WiFi.status() on failure
    (so a wrong password / AP-not-found / timeout are distinguishable).
    Also disable WiFi.setAutoReconnect(): on the single-core C3 the IDF
    auto-reconnect handler fires esp_wifi_connect() the instant an attempt
    fails and races our own disconnect()/begin(), which makes
    esp_wifi_set_config() reject the fresh credentials with "sta is
    connecting, cannot set config" (observed in the field log). With
    auto-reconnect off, run_cycle() drives every connect from a clean, idle
    STA. A short settle delay after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
    [wifi_sync.cpp]
2026-07-08 Supermini WiFi: log password + STA disconnect reason code
    The connect line now echoes the SSID and password (clear text, for
    credential verification against the router), and the failure line adds
    the STA disconnect reason captured from the Wi-Fi event. status=6
    (WL_DISCONNECTED) alone doesn't say why; the reason code does — 15 =
    4WAY_HANDSHAKE_TIMEOUT (wrong password), 201 = NO_AP_FOUND, etc.
    Claude-Session: https://claude.ai/code/session_01GWpS8pNyoPKRWGw59YrRyb
    [wifi_sync.cpp]
2026-07-08 Supermini WiFi: prefer Wi-Fi on shared radio + retry auth
    Field log showed disconnect reason 2 (AUTH_EXPIRE) at a strong -55 dBm
    signal — the 802.11 auth expiring before the WPA password is ever
    checked, the classic single-core ESP32-C3 symptom of BLE starving Wi-Fi
    on the shared radio.
    - esp_coex_preference_set(ESP_COEX_PREFER_WIFI) for the connect window so
    the auth/assoc frames win radio time over NimBLE advertising; restore
    ESP_COEX_PREFER_BALANCE on success or when giving up.
    - Retry the association WIFI_CONNECT_ATTEMPTS (3) times per cycle, since
    AUTH_EXPIRE is typically transient.
    Claude-Session: https://claude.ai/code/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
2026-07-08 Supermini WiFi: pause BLE advertising during connect + log target dBm
    The esp_coex_preference_set() approach both crashed the coexistence
    stack (RISC-V register dump on retry 2) and failed to fix reason 2
    (AUTH_EXPIRE). A stand-alone Wi-Fi-only scanner sees both APs at strong
    signal, proving the hardware is fine and the fault is Wi-Fi/BLE radio
    contention on the single-core C3.
    - Drop esp_coexist.h and the coex-preference calls (crash source).
    - Add ble_service::pause_advertising()/resume_advertising() and wrap the
    whole connect window so Wi-Fi owns the radio for auth/assoc/handshake,
    the same condition under which the scanner works. Advertising resumes
    on success or failure.
    - With B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
    [ble_service.cpp, ble_service.h, wifi_sync.cpp]
2026-07-08 Report CR2032 coin-cell (RTC backup) voltage with drift + RSSI
    Adds an averaged ADC read of the RTC backup coin cell, reported on each
    ingest POST as coincell_mv (millivolts) alongside wifi_rssi and
    rtc_drift, so a dying cell is visible before the clock is lost.
    Firmware (both C3 SuperMini and WROOM DevKit V1):
    - read_coincell_mv() averages analogReadMilliVolts() (eFuse-calibrated)
    over COINCELL_ADC_SAMPLES and applies COINCELL_DIVIDER_RATIO.
    - Sense pin PIN_COINCELL_ADC: GPIO4 (ADC1_CH4) on the C3, GPIO35
    (input-only ADC1_CH7) on the WROOM — both ADC1 so Wi-Fi doesn't
    disturb the reading. No divider (ratio 1.0): a CR2032 stays within the
    ~0-3.1 V ADC_11db range.
    - Migra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
    [config.h, wifi_sync.cpp]
2026-07-09 Supermini: connect Wi-Fi before BLE init; drop crashing retry
    Two field-confirmed problems, fixed:
    1. Deterministic crash (RISC-V panic, boot-loop trip). The register dumps
    always fault on the 2nd WiFi.begin() of the in-cycle retry: on the
    single-core C3, WiFi.disconnect(true,true) + re-begin() while the BLE
    controller is up crashes the coexistence stack. Remove the retry loop
    (and the now-unused WIFI_CONNECT_ATTEMPTS); the WIFI_SCAN_INTERVAL_SEC
    cycle is the retry cadence. One begin() per cycle never crashed.
    2. reason=2 (AUTH_EXPIRE) persisted even with advertising paused, because
    the BLE *controller* still shares the radio and starves the initial
    802.11 auth. Defer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
    [ble_service.cpp, config.h, esp32.supermini_ds1307_ac_energy_meter.ino, wifi_sync.cpp]
2026-07-09 Supermini WiFi: cap TX power to 15 dBm (LDO current limit)
    Root cause of the reason=2 / AUTH_EXPIRE failures, found by field
    diagnosis: the C3 Super Mini's onboard ~250 mA LDO can't source the
    radio's ~335 mA peak in a full-power (19.5 dBm) TX burst. The 3V3 rail
    sags mid-burst, the PA distorts the 802.11 auth frames, the AP never
    decodes them, and the supplicant times out with reason 2 — before the
    WPA password is ever tested (which is why the password/BLE were red
    herrings; a BLE-less diagnostic sketch failed identically at full power).
    A TX-power sweep connected in 1.6 s at 15 dBm (getTxPower=60, ~240 mA)
    and failed at 19.5 dBm (getTxPower=78) on two separate boards.
    Fix: WiFi.setTxPow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
    [config.h, wifi_sync.cpp]
2026-07-09 Supermini: run BLE+Wi-Fi concurrently, matching WROOM firmware
    Now that the real cause of the association failures is fixed (TX-power
    cap for the 250 mA LDO), the BLE-coexistence workarounds are no longer
    needed — they were chasing a misdiagnosed problem. Revert the supermini
    to the WROOM's normal concurrent structure:
    - ble_service::begin() back in setup(); BLE advertises from boot.
    - connectivity_task restored to the WROOM shape (BLE ticks every loop,
    first_cycle 30 s settle, periodic cycles) — no deferred BLE init.
    - Drop ble_service::pause_advertising()/resume_advertising() (calls and
    the now-dead API + s_started flag).
    Kept the supermini-specific essentials: the WIFI_TX_POWER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
    [ble_service.cpp, ble_service.h, esp32.supermini_ds1307_ac_energy_meter.ino, wifi_sync.cpp]
2026-07-09 Backend: keep app logged in — fix early session expiry
    The Android app persists its session cookie and auto-relogins on launch,
    but users were still kicked to the login screen every time they reopened
    the app. Cause: start_user_session() set the cookie lifetime to
    SESSION_LIFETIME but never set session.gc_maxlifetime, which defaults to
    ~24 min in PHP — so the server garbage-collected the session data ~24 min
    after the last request while the client still held a valid cookie. The
    next request then 401'd and the app showed login.
    - Set session.gc_maxlifetime to SESSION_LIFETIME.
    - Move session files to an app-private save_path outside the doc root
    (next to meter_secrets/) so the shared h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
2026-07-09 App: keep login across swipe-away (optimistic session restore)
    Backgrounding kept the user logged in (process alive), but swiping the
    app from recents kills the process and the cold start defaulted
    CloudUi.loggedIn to false — it only flipped true if tryAutoFetch()'s
    single devices() call succeeded, so any launch-time network hiccup (or a
    lapsed server session) dropped the user onto the login screen.
    Restore the logged-in UI optimistically from the persisted isLoggedIn
    flag on launch, then validate in the background: server OK -> stay and
    load; server 401 -> real logout, clear flag; network/transient -> keep
    the restored state. A system memory-kill hits the same path so it
    restores too. Pa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
2026-07-11 Change DEVICE_TOKEN to placeholder
    Updated DEVICE_TOKEN to a placeholder value.
2026-07-11 Change DEVICE_TOKEN to a placeholder value
2026-07-20 Supermini: move coin-cell ADC sense from GPIO4 to GPIO3
    Same ADC1 (GPIO3 = ADC1_CH3, non-strapping, free), no functional change
    — the read helper uses the PIN_COINCELL_ADC macro. Docs updated.
    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
2026-07-20 Dashboard: show start/end meter reading under each energy bar
    Each bucket now carries the cumulative PZEM meter reading (kWh) at its
    start and end (kwh_start/kwh_end in readings.php): start = the bucket's
    first reading, end = the next bucket's first reading in telescoping
    (daily/monthly) mode — so end - start equals the bar — or the bucket's
    own last reading otherwise.
    A small Chart.js plugin draws "start / → end" under each bar, gated to
    <= 12 bars so the 12-month and 7-day views get the labels while 30-day /
    hourly stay uncluttered. Extra bottom padding reserves room for them.
    Claude-Session: https://claude.ai/code/session_01G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
2026-07-20 Supermini: swap I2C SDA/SCL (SDA=GPIO6, SCL=GPIO5)
    Both non-strapping; the C3 I2C maps to either. Docs updated to match.
    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
    [config.h]
2026-07-20 Supermini: log raw DS1307 time at boot even when oscillator stopped
    begin() previously only surfaced the RTC time via setup()'s
    "[boot] RTC time" line, which is gated on the oscillator running — so a
    just-wired or power-lost DS1307 showed nothing about what it held. Now
    log the raw chip time (with running/stopped state) whenever the DS1307
    answers on I2C, so the boot console always shows what it reads.
    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
    [rtc.cpp]
2026-07-20 Supermini: report PZEM status at boot and on change
    Add a one-shot PZEM probe in setup() (retried a few times) that logs the
    first sample or an explicit "no response" error with wiring/baud hints —
    mirrors the RTC boot line so a miswired/unpowered meter is obvious at
    startup. Also log PZEM status transitions (OK / STALE / SENSOR_FAULT) in
    the sampling task so a fault that develops or clears after boot shows up
    on the console.
    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
    [esp32.supermini_ds1307_ac_energy_meter.ino]
2026-07-21 Supermini: retry PZEM reads to stop OK<->STALE flapping
    A single Modbus transaction to the PZEM-004T intermittently misses on the
    single-core C3 (radio activity, marginal 5 V TTL / grounding, bus noise),
    which flapped the status OK<->STALE every few seconds even with 230 V
    present. pzem::read() now retries the transaction up to PZEM_READ_ATTEMPTS
    times, spaced PZEM_READ_RETRY_MS (250 ms > the library's ~200 ms value
    cache) so each retry is a fresh read. A sample is only reported failed
    after all attempts miss.
    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
    [config.h, pzem.cpp]
2026-07-21 Add BLE "reset energy meter to 0" command from the Android app
    New write-only, auth-gated BLE characteristic (BLE_UUID_PZEM_RESET) that
    zeroes the PZEM cumulative energy register on an explicit confirmation
    payload {"action":"reset_energy"} — the same reset the BOOT long-press
    does, now reachable from the app for a fresh install.
    Firmware (both supermini and WROOM):
    - pzem::request_reset()/consume_reset_request() defer the resetEnergy()
    Modbus write to the PZEM-owning sampling task so it never races a read.
    - PzemResetCallbacks (auth + payload check) requests the reset; the
    sampling task performs it and logs the source (BLE app vs BOOT button).
    Android:
    - MeterGatt.resetEnergy() writ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
    [ble_service.cpp, config.h, esp32.WROOM.DevKit.V1_SSD1306_ds3231_ac_energy_meter.ino, esp32.supermini_ds1307_ac_energy_meter.ino]
2026-07-21 PZEM: retry resetEnergy() so a flaky bus doesn't need multiple taps
    Serial confirmed the BLE reset path works end-to-end, but reset_energy()
    missed twice before landing on the third request — the same flaky-bus
    misses that flap reads OK<->STALE. Retry the resetEnergy() Modbus command
    PZEM_READ_ATTEMPTS times so one app tap reliably zeroes the register.
    Also bring the WROOM firmware to parity: add the PZEM read/reset retry
    knobs and the read-retry loop it was missing (supermini already had the
    read retry).
    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
    [config.h, pzem.cpp]
2026-07-21 App: show reset success/failure and the live meter total
    The reset had no user feedback. Firmware now includes total_kwh (live
    PZEM lifetime total) in the BLE device-info JSON; the app reads it before
    and after the reset and reports the outcome:
    - write couldn't reach the device -> "Reset failed — couldn't reach…"
    - total dropped to ~0 -> "Energy meter reset to 0 ✓"
    - total unchanged (bus busy) -> "Reset didn't take — try again"
    Also surface the meter total in the Device info card so the user can see
    it go to 0. Applied to both firmware variants.
    Claude-Session: https://claude.ai/code/session_01GWpS8pNyoPKRWGw59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
    [ble_service.cpp]
2026-07-21 App: show cloud friendly name in the "My devices" list
    The saved-devices list only showed the MAC-derived placeholder
    ("Meter (5B:7A)"). Now, when a device is opened while signed into the
    Cloud tab, its canonical device_id and cloud friendly name (e.g. "test1")
    are cached onto the saved-device entry and shown as the list title, with
    the BLE name / MAC / id kept as secondary lines.
    - Device gains a friendlyName field; DeviceStore.updateMeta patches
    id/friendlyName in place (old JSON without the field still decodes).
    - DeviceDetailViewModel persists id + friendly name in proceedUnlocked
    (best-effort cloud lookup by device_id).
    - SavedDevicesScreen prefers friendlyName over the placeholder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
2026-07-22 Supermini: pause BLE during Wi-Fi sync to stop the coexistence crash
    Field logs showed the device connecting at 11 dBm but then crashing
    during the HTTPS POST — always at the same PC (0x4038949a), the same
    fault as the earlier connect-time crashes. It's a WiFi+BLE coexistence
    crash on the single-core C3 under radio load (the TLS upload racing BLE
    advertising), made worse at marginal signal.
    - run_cycle() now pauses BLE advertising for the whole cycle (connect +
    NTP + POST) and resumes after, so Wi-Fi owns the radio for the upload.
    Gated by WIFI_PAUSE_BLE_DURING_SYNC (default 1). It's a no-op while a
    phone is connected over BLE, so live config is unaffected — it only
    quiets the a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
    [ble_service.cpp, ble_service.h, config.h, wifi_sync.cpp]
2026-07-22 Fix connectivity-task stack overflow during TLS POST (12K -> 32K)
    The crash during the HTTPS POST (register dump with RAM-address CSRs, the
    classic stack-overflow signature; same PC every time) was not BLE
    coexistence — it was a stack overflow. post_batch() allocates a 16 KB
    StaticJsonDocument as a local on the connectivity task's 12 KB stack, so
    the buffer alone overruns the stack; the mbedTLS handshake then piles on
    top. It silently corrupted adjacent RAM and only faulted on a marginal
    link, where the TLS handshake stacks deeper. Raise CONN_TASK_STACK to
    32 KB (both firmware variants) to fit the doc + TLS + frames.
    Claude-Session: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
    [config.h]
2026-07-22 Supermini: BLE→Wi-Fi radio handoff (BLE-only 2 min, then BLE off)
    The TLS-POST crash (same PC every time, stack NOT overflowed) persisted
    with BLE advertising paused and with a bigger stack — because the BLE
    *controller* being co-active is what makes Wi-Fi unstable on the
    single-core C3, and only fully de-initializing BLE frees the radio.
    connectivity_task now runs BLE only for the first BLE_CONFIG_WINDOW_SEC
    (120 s) with Wi-Fi held OFF — the provisioning window — then calls
    ble_service::shutdown() (NimBLEDevice::deinit) and lets Wi-Fi own the
    radio for the rest of the run. Reboot for another BLE config window. The
    stuck-BLE watchdog is skipped once BLE is intentionally off; tick()/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
    [ble_service.cpp, ble_service.h, config.h, esp32.supermini_ds1307_ac_energy_meter.ino]
2026-07-22 Supermini: fix TLS-POST crash-loop (stack + heap hardening)
    The device was panic-looping during Wi-Fi TLS POSTs on a marginal link
    (RSSI ~-76 dBm, frequent code=-1/-11). Crashes landed at different PCs in
    different tasks with heap canaries in the dumps — the classic heap
    exhaustion/corruption signature — and the real panic reason was being
    swallowed by the ROM-log silencer.
    Changes:
    - wifi_sync: move post_batch()'s 16 KB StaticJsonDocument off the
    connectivity-task stack into .bss (the on-stack copy plus the mbedTLS
    handshake was the documented stack-overflow mechanism).
    - wifi_sync: add a heap guard before each TLS handshake — if free heap or
    the largest free block is below thr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
    [config.h, log_serial.cpp, wifi_sync.cpp]
2026-07-22 Supermini: fix real reboot cause — task-WDT timeout in TLS handshake
    The recurring reboot was NOT heap corruption. With ROM_LOG_QUIET=0 the true
    panic reason finally printed:
    task_wdt: Task watchdog got triggered ... - conn (CPU 0)
    Every earlier crash shared the same PC (MEPC 0x4038949a), so they were all
    this same task-watchdog abort on the connectivity task — the old builds just
    suppressed the reason line via the ROM-log silencer.
    Root cause: WiFiClientSecure's TLS handshake defaults to a 120 s timeout. On a
    marginal link (this unit runs at ~-68 to -72 dBm) a stalled handshake blocks
    the connectivity task well past the ~30 s task WDT, which aborts and reboots.
    That matches the log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
    [config.h, wifi_sync.cpp]
2026-07-29 Supermini: fix relay + status-LED drive polarity to match hardware
    The board drives both lines opposite to what the config assumed:
    - Relay: ESP32 pin HIGH turns the PC817 opto LED on and ENERGIZES the coil
    (cutting AC). That's active-high, so RELAY_ACTIVE_HIGH 0 -> 1. Boot still
    writes the de-energized state (write_pin(false) -> LOW -> AC on), so the
    fail-safe is preserved.
    - Status LED: the Wi-Fi LED anode is tied to Vcc (cathode to GPIO7 via a
    resistor), i.e. active-low, so LED_ACTIVE_HIGH 1 -> 0.
    Rewrote both comments, which were stale/contradictory (the relay note even
    described active-low while claiming a value that didn't match the define).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
    [config.h]
2026-07-30 Add factory-reset (fresh device) command over BLE + app button
    Adds an app-triggered factory reset that wipes the ESP32 back to a fresh,
    unprovisioned state.
    Firmware:
    - New write-only, auth-gated BLE characteristic (BLE_UUID_FACTORY_RESET) that
    accepts the confirmation payload {"action":"factory_reset"}.
    - storage::factory_reset() erases the ENTIRE NVS partition (every namespace:
    cfg, state, relay, health — future-proof vs. per-namespace clears) and drops
    the buffered LittleFS readings, so the device boots exactly as if freshly
    flashed: boot_id/seq reset, no Wi-Fi creds, default host + log interval, no
    relay schedule, cleared boot-loop history.
    - The wipe + reboot is deferred f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
    [ble_service.cpp, config.h, esp32.supermini_ds1307_ac_energy_meter.ino, storage.cpp]
2026-07-30 Supermini: bump boot serial delay 50ms -> 1s for USB-CDC enumeration
    The Super Mini has no USB-UART bridge; the console rides native USB-CDC,
    which takes ~hundreds of ms to enumerate on the host after reset. 50 ms
    wasn't enough, so the boot banner and early lines were being dropped.
    Claude-Session: https://claude.ai/code/session_016yMxNHfm2Az2139HNv6rrt
    [esp32.supermini_ds1307_ac_energy_meter.ino]
2026-07-30 Supermini: self-heal LittleFS mount instead of bricking on fatal
    A device came up with 'LittleFS mount failed' -> '[fatal] storage init
    failed', boot-looping. LittleFS.begin(true) is meant to format-on-fail, but
    on a partition left inconsistent by a reset caught mid-write it can format
    yet still fail to remount in the same call, so the firmware hit the fatal
    path and bricked.
    - storage::begin(): on begin(true) failure, force an explicit LittleFS.format()
    + remount before giving up. Recovers a corrupt/inconsistent filesystem
    (losing only the expendable buffered rows) instead of a dead unit.
    - storage::factory_reset(): hold the log lock through to the reboot (never
    released) and reforma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
    [storage.cpp]
2026-07-30 App: fix Cloud devices parse crash — location is a numeric id
    The backend returns "location":21 (a location foreign-key id) plus a
    separate "location_name" string, but CloudDevice.location was typed String?.
    kotlinx.serialization then failed the entire devices response with
    'Unexpected JSON token ... Expected quotation mark, but had 2 at
    $.devices[0].location', so the Cloud tab showed the raw error instead of the
    device list.
    Type location as Int? to match the server and add location_name: String? for
    the display value.
    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
2026-07-30 firmware: add wifi_multi_connect_diag diagnostic sketch
    Standalone ESP32-C3 diagnostic build kept in-tree for future Wi-Fi
    troubleshooting: walks a TX-power ladder across the saved APs and prints the
    raw STA disconnect reason code, which is what distinguishes wrong-password
    (15/202) from AP/SSID issues (201) from a marginal-supply AUTH_EXPIRE (2) that
    clears at lower TX power.
    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
    [wifi_multi_connect_diag.ino]
2026-08-20 App+fw: show saved Wi-Fi SSID and make TX power settable from the app
    Wi-Fi credential display: the config screen only showed the SSID while the
    device was actively connected (firmware only put ssid in wifi_status when
    associated). Now the firmware includes the saved SSID (from NVS) in the Wi-Fi
    status JSON regardless of connection state, and the app shows it and prefills
    the SSID field with it. The password is intentionally still never sent over BLE.
    Settable TX power: WIFI_TX_POWER was compile-time only. Added a runtime value in
    NVS (quarter-dBm units; wifi_power_t values are exactly dBm*4), applied by
    wifi_sync on every connect and settable over BLE via
    {"action":"set_tx_power","dbm":N}.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
2026-08-20 App: show relay state from the appliance's perspective, not the coil
    The relay is fail-safe NC: an ENERGIZED coil (relay.on) CUTS the AC, so the
    appliance is powered when the relay is OFF. The card showed the raw coil state,
    so it read backwards — 'ON' while the AC was actually cut. The card now speaks
    in appliance terms: Status ON/OFF is the AC/appliance power (inverted from
    relay.on), and the On/Off buttons map to the inverted relay mode (On -> mode
    'off' = de-energize = AC on; Off -> mode 'on' = energize = AC cut). Auto
    unchanged.
    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
2026-08-20 fw: fix build — WIFI_TX_POWER default as numeric qdbm (no WiFi.h in storage)
    storage.cpp includes config.h but not WiFi.h, so expanding WIFI_TX_POWER ->
    WIFI_POWER_13dBm there failed with 'WIFI_POWER_13dBm was not declared in this
    scope'. The wifi_power_t enum values are exactly dBm*4, so replace the enum
    default with a plain numeric quarter-dBm macro WIFI_TX_POWER_QDBM (52 = 13 dBm)
    that any file can use without pulling in WiFi.h. wifi_sync already applies it via
    (wifi_power_t)storage::wifi_tx_power_qdbm(); storage uses the numeric default.
    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
    [config.h, storage.cpp, storage.h]
2026-08-20 Move backend from aromen.biz/meter to the ac.aromen.biz subdomain
    The app now lives at the root of the ac.aromen.biz subdomain, so the /meter
    path segment is gone: https://aromen.biz/meter/X -> https://ac.aromen.biz/X.
    - Firmware (both boards): INGEST_HOST_DEFAULT -> https://ac.aromen.biz and
    INGEST_PATH -> /api/ingest.php.
    - Backend PHP/JS: every absolute URL drops the /meter prefix (/api/*,
    /dashboard/*, /admin/*), including the REQUEST_URI check in _db.php that
    decides between a JSON 401 and a login redirect. Filesystem paths
    (meter_secrets/, meter_sessions/) and the meter_sess cookie are unchanged.
    - Android app: default baseUrl -> https://ac.aromen.biz and all endpoints
    -> $b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
2026-08-20 WROOM: port all Super Mini logic; ROM_LOG_QUIET=1 for production
    The Super Mini build is field-tested, so its logic is now the shared baseline.
    Ported to the WROOM DevKit build: storage (factory reset, runtime Wi-Fi TX
    power, LittleFS self-heal on mount failure), log_serial (ROM_LOG_QUIET gate),
    ble_service (is_connected, factory-reset characteristic, saved_ssid +
    tx_power_dbm in the Wi-Fi status JSON, set_tx_power command), and wifi_sync
    (TLS handshake cap, task-WDT feeds across the long network waits, 16 KB request
    doc moved to .bss, low-heap guard + per-POST heap logging). The .ino gains the
    BLE factory-reset handling in loop(), a 1 s boot serial settle, a storage-failure
    log line, and th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
    [ble_service.cpp, ble_service.h, config.h, esp32.WROOM.DevKit.V1_SSD1306_ds3231_ac_energy_meter.ino, log_serial.cpp, log_serial.h, storage.cpp, storage.h]
2026-08-20 WROOM: drop the SSD1306 OLED and switch DS3231 -> DS1307
    Brings the WROOM build in line with the Super Mini hardware: no display, and
    the same DS1307 RTC.
    - Deleted display.cpp/display.h and every display:: call (splash screens,
    per-sample tick) plus the OLED SPI pins (GPIO 23/22/21/19/18, now free).
    DISPLAY_REFRESH_MS is renamed SAMPLE_INTERVAL_MS to match what it actually
    gates now (the 1 Hz PZEM sample), same as the Super Mini.
    - rtc.cpp/rtc.h replaced with the DS1307 implementation: the chip reports a
    power loss via the CH (clock-halt) bit rather than the DS3231's OSF, and
    adjust() restarts the oscillator. Boot now logs the raw retained time too.
    - I2C dropped from 400 kHz to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
    [ble_service.cpp, ble_service.h, config.h, esp32.WROOM.DevKit.V1_ds1307_ac_energy_meter.ino, identity.cpp, identity.h, log_serial.cpp, log_serial.h]
2026-08-21 Add dual-PZEM WROOM firmware: two meters on one ESP32
    New sketch esp32.WROOM.DevKit.V1_dual_pzem_ac_energy_meter (FW_VERSION 3.0.0)
    reads PZEM_CHANNELS (2) PZEM-004T meters and reports both under one device_id.
    WROOM only, as asked; the Super Mini build is untouched.
    Wiring: one hardware UART per meter — ch1 on UART2 (GPIO 16/17), ch2 on UART1
    (GPIO 32/33, plain side-header pins, clear of the GPIO 6..11 flash block). They
    are NOT daisy-chained: the TTL PZEM variant drives its TX line permanently, so
    two on one UART would fight and corrupt every reply. Per-channel Modbus
    addresses are configurable so an RS485 multi-drop bus can share a UART later.
    - pzem: per-channel driver (rea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
2026-08-21 Dual-PZEM build: two relays, one per meter
    Relay N now cuts the AC that PZEM N measures. Each relay runs a fully
    independent open-hours schedule, cutoff state machine, manual override and
    NVS-cached config, and its compressor-idle check looks ONLY at channel N's
    wattage. That pairing is the point of the change: deciding relay 1 from
    meter 2's load would either hard-cut a running compressor or never cut at all.
    - config: RELAY_COUNT (= PZEM_CHANNELS), PIN_RELAY1 26 / PIN_RELAY2 27 (plain
    side-header pins, clear of the GPIO 6..11 flash block). RELAY_POWER_SOURCE is
    removed - it existed only to pick which meter fed the single relay, and each
    relay now has its own.
    - relay: ever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
2026-08-21 Devices declare their meter/relay count; app renders that many relay controls
    Every build now reports channel_count and relay_count in BLE Device Info and in
    each ingest POST, so neither the cloud nor the app needs per-device config: the
    cloud learns how many per-channel relay schedules to push, and the app renders
    exactly that many on/off/auto control sets.
    To make one app serve both layouts, ALL builds now report relay state in the
    same shape - an array. The single-relay builds send a one-entry relays[]
    instead of a flat object, so the app parses one protocol and just renders per
    entry.
    Fixes a real pre-existing bug while doing it: the app's RelayState mapped a
    field named "on", but the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
    [ble_service.cpp, relay.cpp, wifi_sync.cpp]
2026-08-21 Add triple-PZEM WROOM firmware (3 meters, 3 relays)
    New sketch esp32.WROOM.DevKit.V1_triple_pzem_ac_energy_meter (FW_VERSION 3.1.0)
    using all three of the ESP32's hardware UARTs: ch1 UART2 (16/17), ch2 UART1
    (32/33), ch3 UART0 (3/1). Relays on GPIO 26/27/25, one per meter.
    UART0 is also the flashing port, which is fine for a soldered-down module - the
    programmer is only attached on the bench and PZEM-3 only in the field. The
    runtime conflict is the real one, so DEBUG_SERIAL now decides who owns UART0
    AND therefore how many meters the build has:
    DEBUG_SERIAL 1 -> UART0 = console, 2 meters + 2 relays (bench testing)
    DEBUG_SERIAL 0 -> UART0 = PZEM-3, 3 meters + 3 relays (production, silen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
2026-08-21 Backend UI: per-meter dashboards and per-relay schedules
    The API and schema were already keyed on channel and needed no changes for a
    3-meter device, but the two front-ends only ever touched channel 1, so meters 2
    and 3 were invisible and relays 2 and 3 unconfigurable from the browser. Both
    now follow whatever the device reports.
    Fixes a bug introduced by migration 011 first: admin/devices.php still joined
    ed_device_relay_schedule, which is now keyed (device_id, channel) - so a 3-relay
    device returned three rows and would have appeared three times in the device
    list. The schedule-present indicator only needs to know whether ANY schedule
    exists, so it is now a LIMIT 1 subquery and the join i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
2026-08-21 Dashboard: show all meters at once
    The Meter selector previously switched between channels one at a time, so a
    2- or 3-meter device could not be compared without flipping back and forth. It
    now defaults to a new "All meters" entry (channel=0):
    - both charts draw one colour-coded series per meter (green/orange/blue, matched
    across the energy and power charts) with a legend, which is only shown when
    more than one series is plotted;
    - a per-meter breakdown row gives each meter's period kWh, live watts and peak;
    - the four existing cards become the COMBINED figures across meters.
    Picking a single meter still gives the focused view, and single-meter devices
    are untouched - CHANNELS collapses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
2026-08-21 Per-relay live indicator; reports pick one meter at a time
    Live relay state was device-level: ed_device_meta.relay_on/relay_mode only ever
    held relay 1's values (the firmware's flat relay_* fields), so relays 2 and 3
    were invisible on the dashboard no matter what the device reported.
    - New table ed_device_relay_state, keyed (device_id, channel), refreshed on
    every ingest POST from the relays[] array the multi-relay firmware sends.
    Single-relay firmware omits that array, so ingest synthesises a channel-1 row
    from the flat fields and every device populates the table uniformly.
    Deliberately NOT stored on ed_device_relay_schedule: a relay reports state
    whether or not anyone configured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
2026-08-21 docs: note per-relay indicator and single-meter reports
    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
2026-08-21 App Cloud tab: chart per meter
    The Cloud chart always queried the default channel, so a multi-meter device
    only ever showed meter 1 there. It now offers a Meter chip row and charts the
    selected meter.
    One meter at a time rather than an overlay, matching what the reports page just
    became: a device's meters are separate cumulative counters measuring different
    loads, so combining them on a small phone chart would be misleading rather than
    informative.
    - devices.php now returns channel_count/relay_count. They arrive with
    migrations 010/011, so they degrade to a literal 1 the same way ble_pin
    already did - the endpoint keeps working on a pre-migration DB, and the
    fallback now covers all f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
2026-08-21 fw: size the ingest-response JSON buffer by relay count
    Reviewing the 3-PZEM build for JSON capacity found the ingest RESPONSE buffer
    was the one doc that did NOT scale with channel count, plus a pre-existing
    undersize in the single-meter builds.
    An overflowing StaticJsonDocument fails deserializeJson OUTRIGHT rather than
    truncating, so the failure mode is not "the last field is missing" - the device
    logs "bad response JSON" and silently stops picking up log_interval_sec AND its
    relay config together.
    - Multi-relay builds: rdoc was a fixed 2048, sized when the response carried two
    relay_channels entries. It is already marginal at 2 relays with multi-window
    schedules and overflows at 3,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
    [wifi_sync.cpp]
2026-08-21 Drop the triple-PZEM build; keep 1-meter and 2-meter firmware
    Removes esp32.WROOM.DevKit.V1_triple_pzem_ac_energy_meter and its README
    section. The supported set is now:
    esp32.supermini_ds1307_ac_energy_meter 1 PZEM / 1 relay
    esp32.WROOM.DevKit.V1_ds1307_ac_energy_meter 1 PZEM / 1 relay
    esp32.WROOM.DevKit.V1_dual_pzem_ac_energy_meter 2 PZEM / 2 relays
    That also retires the UART0-as-Modbus tradeoff the third channel forced: no
    build gives up its serial console any more, and the DEBUG_SERIAL flag that
    coupled logging to the channel count went with it (it existed only in the
    triple build - the remaining sketches were never touched by it).
    Backend and app are deliberately left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
2026-08-22 Backend UI: make the admin and dashboard pages usable on a phone
    The relay-schedule editor was the worst offender: a 600px dialog at 90%
    width is still wider than a phone, so the Close (Off), +1 day and remove
    columns were pushed off-screen with no way to reach them. On narrow
    screens the dialog is now a full-bleed sheet and the schedule table
    collapses into one labelled card per window — seven day chips across a
    grid, full-width time inputs, a full-width Remove button, and a sticky
    Cancel/Save bar so the actions stay reachable.
    Charts were keeping the canvas's 300x120 attribute ratio, which squashed
    them into a ~120px strip on a phone. They now sit in a .chart-wrap that
    owns the height,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
2026-08-22 Admin: let an admin set a device's BLE PIN by hand
    The PIN could only be rolled at random, so getting a memorable or
    pre-agreed one meant editing ed_energy_devices.ble_pin in the database
    directly. The device row now carries a `Set` button beside `↻`, which
    prompts for a PIN (prefilled with the current one) and stores it via a
    new `set_pin` action.
    `↻` is unchanged and still rolls a random PIN.
    Both paths produce exactly six digits: that is the shape gen_ble_pin()
    has always emitted and the shape migration 004 backfilled, and the
    Android app compares the typed PIN against the stored string verbatim
    through a digits-only field — so a longer or non-numeric value would
    lock the owner ou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
2026-08-22 App: scroll the whole Configure Wi-Fi screen, not just the network list
    The screen was a fixed-height Column whose only scrollable child was the
    "Nearby networks" LazyColumn, sized with weight(1f, fill = false). The
    list therefore got whatever vertical space was left over after everything
    above it, and nothing else on the screen could scroll at all. Adding the
    Wi-Fi transmit power section in fed2acc consumed most of that remainder,
    leaving the network list scrolling inside a ~100dp strip at the bottom.
    The outer Column now carries verticalScroll(rememberScrollState()), the
    same way DeviceDetailScreen and CloudDashboardScreen already do, so the
    page scrolls as one surface.
    The network list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
2026-08-22 App: keep the Wi-Fi password label on one line
    "Password (leave blank for open network)" is 290dp wide at the resting
    label size against roughly 296dp of usable width inside the field, so it
    wrapped to a second line and made the field two rows tall — measurably so
    above a 1.05x font scale, which is most devices with text even slightly
    enlarged.
    The parenthetical hint now renders at 0.7em, which keeps it on one line
    with comfortable headroom (224dp; holds to about a 1.35x font scale).
    The size is expressed in em rather than sp deliberately: a label floats up
    and shrinks when the field takes focus, and an absolute sp hint would stay
    full-size against the shrunken "Password" beside it. An e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
2026-08-24 Dashboard: Today covers the whole day, not 07:00-19:00
    The Today range clamped its X axis to a 07:00-19:00 "daylight window" on
    the assumption that a site only draws power during business hours. These
    meters run around the clock, so every overnight reading fell outside the
    plot — on a counter drawing ~0.45 kWh/hour all night, most of the day's
    energy was simply not on the chart.
    Today now spans midnight through the end of the hour in progress. The
    right edge tracks the current hour rather than sitting at midnight, so
    the elapsed part of the day fills the plot instead of being squeezed
    against a mostly empty axis — which is also what keeps it distinct from
    the 24 h range, whose frame is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
2026-08-24 Dashboard: chart readings continue from the old meter
    capacity_kw is repurposed as the replaced meter's last reading at install,
    and the Today / Period total cards already continue from it. The start/end
    readings drawn under each bar did not, so the chart said "13.5 -> 18.4"
    while Period total said 8708.17 for the same instant.
    Those readings are now offset by the install baseline, so the last bar's
    end equals the Period total card exactly. Only the endpoints move: the bar
    heights are within-bucket deltas, and adding a constant to both ends of a
    subtraction cancels out.
    The endpoint row's suppression threshold now measures the rendered text
    instead of assuming 46px per label. Readings that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
2026-08-24 Dashboard: anchor chart readings on the device's first reading
    A device entered as "Old kWh 1348.10" charted from 1348.52, and one
    entered as 8690.10 charted from 8690.38.
    The old meter's reading was being added straight onto the raw PZEM
    counter, and that counter is not at zero when a unit goes into service —
    bench testing had already put 0.42 and 0.28 kWh on these two. The chart
    therefore started that much above the figure the admin typed in.
    readings.php now also returns origin_kwh, the channel's first-ever
    reading, and the dashboard charts old_kwh + (counter - origin_kwh). The
    point where this device took over is now exactly the old meter's final
    reading, so both devices start on the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
2026-08-27 Add the relay board's DipTrace PCB source
    `hardware/6040_Dipak_Savkare_Relay.dip` is the AC-cutoff relay board's
    layout, supplied by the board designer.
    .gitattributes marks *.dip and *.dch binary so git never line-diffs,
    merges or EOL-converts them — any of which would silently corrupt the
    file. A board revision is a whole-file replacement.
    hardware/README.md records what the format is, that only DipTrace opens
    it, and the signal and part names recoverable from the binary. Those
    notes are explicitly flagged as extracted strings rather than a BOM: a
    DipTrace board embeds the footprint libraries it was drawn from, so the
    extraction cannot separate placed parts from unused library entries.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
    [6040_Dipak_Savkare_Relay.dip]
2026-09-14 fw: fix the TLS timeout budget and the heap guard that stalled POSTs
    Field data from meter-53dcbc (supermini build, 23 days, always-on link,
    6,639 rows) shows 14 reboots, 13 of them preceded by a POST blackout that
    lasted 6.04 h to the second and ended with a single catch-up POST of
    67-72 rows. 6.04 h is STUCK_WIFI_REBOOT_SEC plus one cycle: the 6 h
    watchdog was the only thing recovering the device. Blackouts began at a
    consistent *uptime* (15.6-16.6 h or 44-50 h), never a consistent time of
    day, so this is the firmware and not the network. 976 rows (14.7%)
    arrived late, mean 2.75 h, and the 915 that crossed a reboot are stored
    as time_confidence='approx' with 1.6-4.7 min of back-dating erro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
    [config.h, wifi_sync.cpp]
2026-09-15 backend: new devices register with the default BLE PIN 112233
    Registration stamped each new device with a random 6-digit PIN, which made
    commissioning a two-person job: the installer standing in front of a
    freshly flashed meter could not open it from the app until someone else
    read the random PIN out of the admin UI. New devices now start on a fixed,
    known PIN that an admin changes per device once the meter is installed.
    Both registration paths use it — auto-registration on the first ingest
    POST, and register-and-claim from the app. The admin UI is unchanged: Set
    still takes a specific PIN and the regenerate button still calls
    gen_ble_pin() for a random one, which is now its only caller.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
2026-09-15 fw: port Group C — stuck-Wi-Fi escalation, heap watchdog, nightly reboot
    Brings all three variants up to the solar_monitor_ds1307 reference build.
    Ported rather than copied: the reference has no relay code, a different pin
    map and CONN_TASK_STACK 12288, so each piece was adapted to this tree.
    Behaviour
    - Stuck-Wi-Fi is now association-gated and escalates. The counter advances
    only while WiFi.isConnected() and resets on a dropped link or a POST
    landing, so ordinary offline time can no longer trip it. Because of that
    the thresholds are safe to make aggressive: reassociate at 10 min
    (STUCK_WIFI_REASSOC_SEC, one radio rest, uptime and boot_id preserved),
    reboot at 30 min (STUCK_WIFI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
    [config.h, esp32.WROOM.DevKit.V1_ds1307_ac_energy_meter.ino, esp32.WROOM.DevKit.V1_dual_pzem_ac_energy_meter.ino, esp32.supermini_ds1307_ac_energy_meter.ino, storage.cpp, storage.h, wifi_sync.cpp, wifi_sync.h]
2026-09-15 fw: never let the radio rest bring Wi-Fi up while the handoff says otherwise
    The Group C port put the radio-rest block outside the boot-loop guard, and
    wifi_allowed was scoped inside it, so the rest could not see whether Wi-Fi
    was permitted on the air. radio_on() ends with WiFi.mode(WIFI_STA), so with
    a server-pushed non-zero radio_rest_interval_sec the periodic rest would
    bring Wi-Fi up in boot-loop BLE-only mode — and on the C3 that puts both
    radios on the air at once, which is the exact coexistence crash the
    BLE->Wi-Fi handoff exists to prevent.
    Hoist wifi_allowed to the top of the loop body (false when boot-loop
    tripped, and on the Super Mini false until ble_off latches) and require i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
    [esp32.WROOM.DevKit.V1_ds1307_ac_energy_meter.ino, esp32.WROOM.DevKit.V1_dual_pzem_ac_energy_meter.ino, esp32.supermini_ds1307_ac_energy_meter.ino]
2026-09-15 backend: push the nightly-reboot window and radio rest to devices
    The Group C firmware reads five keys from every ingest response and caches
    them in NVS, but the server sent none of them, so every device stayed on the
    compile-time *_DEFAULT values in config.h and the window could not be moved
    without reflashing. This closes that half.
    Fleet defaults (api/_db.php, each overridable from secrets.php):
    nightly_reboot_enable 1
    nightly_reboot_start_hour 4 local time, inclusive
    nightly_reboot_end_hour 5 local time, exclusive
    radio_rest_interval_sec 0 periodic timer off; on-demand still active
    radio_rest_duration_sec 45 seconds fully off-air
    Per-device overrides liv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
    [config.h, storage.cpp]
2026-09-15 admin: put the interval and maintenance controls on one line
    The maintenance controls were added as a third row under the device's PIN
    and action buttons, which pushed every card taller and separated two sets of
    push-on-next-sync settings that belong together. Move them into .line2
    immediately after the Interval field and drop the .line3 wrapper: the row
    now reads Interval | Maintenance: | Nightly reboot | Window | Radio rest,
    then the existing meta, relay, PIN and actions.
    The "Maintenance:" label stays as an inline divider between the two groups,
    with a left rule and padding instead of the old dashed row border. The rule
    is dropped in the narrow-screen media query, where the row wraps any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
2026-09-15 fw: stop starving the TLS handshake — it needs 48 KB, not 3 KB
    meter-2e5694 was in a ~2 minute reboot loop and then, once it got far
    enough to POST, failing every POST with code=-1. Two separate mistakes,
    both mine, both now measured rather than inferred.
    WHAT THE LOG SHOWS. The "min=" field (esp_get_minimum_free_heap_size) on
    four real POSTs:
    pre=48048 min=296 -> transient peak draw 47752 B
    pre=46944 min=408 -> 46536 B
    pre=46200 min=408 -> 45792 B
    pre=46876 min=1504 -> 45372 B
    A TLS handshake transiently claims 45-48 KB — an order of magnitude more
    than the ~3 KB the established session holds, which is a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
    [config.h, esp32.WROOM.DevKit.V1_ds1307_ac_energy_meter.ino, esp32.WROOM.DevKit.V1_dual_pzem_ac_energy_meter.ino, esp32.supermini_ds1307_ac_energy_meter.ino, wifi_sync.cpp]
2026-09-15 fw: set the real DEVICE_TOKEN in all three variants
    All three still carried the placeholder "token". The backend compares the
    X-Device-Token header against the DEVICE_TOKEN constant from secrets.php
    with hash_equals(), so a device on the placeholder is refused with a 401
    before any row is read — ingest.php falls through to the session-auth path
    and rejects an unauthenticated POST.
    No backend change: DEVICE_TOKEN is not defined anywhere in this repo, it
    comes from secrets.php on the server. The two must match exactly, so the
    comment now says so — changing one side alone starts returning 401 to the
    whole fleet.
    Claude-Session: https:/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
2026-09-15 hardware: add the relay/MOSFET PCB layout
    DipTrace PCB layout for the relay + MOSFET driver board (270,585 B,
    "DTBOARD" magic), committed byte-for-byte as supplied. Lives in a new
    hardware/ folder, now listed in the README's repository layout.
    .gitattributes marks *.dip and *.dch as binary — shorthand for
    -diff -merge -text. Without it git would try to line-merge a layout on a
    conflict, which does not produce a wrong board so much as a corrupt file,
    and could rewrite line endings inside the container. The practical
    consequence is that these files cannot be merged at all, so hardware/README.md
    says to treat a board as checked out by one person at a time and to describe
    the change in the co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
    [6040_Dipak_Savkare_Relay_MOSFET.dip]
2026-09-15 hardware: update the relay/MOSFET PCB layout
    Replaces the layout committed in 0cc46cf with a newer revision, byte-for-byte
    as supplied.
    before 270585 B md5 d64e68968f81ca9b02dcb9188e767031
    after 270733 B md5 cdfea0460a823f3d15a1b4def70e03bb
    The two share only a 12-byte prefix — DipTrace rewrites the whole container on
    save, so the byte-level delta says nothing about what changed on the board
    beyond "it grew by 148 bytes". What was actually edited is not recorded here
    because nothing in the repository can recover it: git shows this as
    "Bin 270585 -> 270733 bytes" and that is the entire diff. If the change matters
    to anyone reading the history later, it needs saying in words.
    Co-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
    [6040_Dipak_Savkare_Relay_MOSFET.dip]
2026-09-17 hardware: add the dimensioned PCB outline drawing
    CCTV-8CH ENCLOSURE PCB OUTLINE — REV D, one A4 vector sheet (96,837 B),
    committed byte-for-byte as supplied. GitHub previews PDFs in the browser, so
    unlike the .dip beside it this is readable without an EDA licence — which is
    the reason to keep it here rather than only in the layout.
    hardware/README.md records what the sheet actually constrains, so the numbers
    are greppable and survive the file: board 100 × 120 × 1.0 mm; 7× Ø5.2 NPTH on
    an x = 6/50/94, y = 6/53/106 grid with Ø11 keep-out BOTH sides; H1/H3/H6/H7
    plate nib + screw clamp against H2/H4/H5 screw + washer; height budget ≤25.5
    component side and ≤2.8 to the back plate;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
2026-09-19 dashboard: add the meter readings table under the energy chart
    Pure addition (+113, no deletions) to dashboard/index.php: the card, its
    styling in the page's own <style> block, and the render function. No API
    change — readings.php already returns kwh_start / kwh_end per bucket, and
    loadRange() already turns them into each bar's s / e carrying the old-meter
    offset. The table just tabulates what the chart is already drawn from, so
    end - start is exactly the bar's kWh rather than a second estimate.
    Until now that arithmetic was only visible as the one-line "Meter reading:
    A -> B" under the chart, and in per-bar labels that the existing code drops
    once bars get narrow (30 days, or any phone).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
2026-09-24 dashboard: Period total/Today as window usage, add Meter reading card, make 24 h rolling
    Period total and Today added the old-meter baseline (capacity_kw) on top
    of the window's consumption, so every range read ~8,700 kWh. They now show
    only the energy used in the window. The cumulative figure moves to a new
    Meter reading card, fed by a latest_kwh field on readings.php so it shows
    the last reading even when the device hasn't posted recently.
    24 h was the same calendar day as Today; it is now a rolling last-24-hours
    window.
    Claude-Session: https://claude.ai/code/session_01Fnmi8okpXGWwyyVuCZZKXM
2026-09-24 dashboard: drop the Today card, add a custom date range
    The Today card duplicated Period total on the Today range. A Custom button
    reveals from/to date pickers; the bucket size follows the span (hourly up
    to 2 days, daily up to ~3 months, monthly beyond).
    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
2026-10-03 firmware: fix data-loss and relay-safety bugs found in review
    All three variants:
    - time_source: compute UTC offsets arithmetically instead of flipping the
    process-wide TZ to UTC around mktime(). Other tasks calling localtime_r()
    in that window saw UTC, so a relay tick could read open hours as off-hours
    and cut an idle AC, and the sampling task could re-anchor "today".
    - storage: factory reset keeps boot_id and the seq high-water mark. The
    server ignores duplicate (device_id, seq, channel), so restarting seq at 1
    made it silently drop (and ack) every new row until seq passed the old max.
    - storage: an interrupted log truncate (power lost between removing
    /log.csv and renaming /lo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
    [ble_service.cpp, relay.cpp, storage.cpp, time_source.cpp, wifi_sync.cpp]
2026-10-03 app + dashboard: forward the stream channel; restrict device selection
    - Android: parse the dual-meter firmware's trailing channel field and send
    it as `ch` on ingest, so relayed rows land on the right meter. Older
    9-field firmware still parses and defaults to channel 1.
    - Dashboard and report pages: only accept a ?device_id= from the user's
    visible devices. The page read device meta (relay state, channel count)
    for whatever id was passed, exposing other accounts' devices.
    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
2026-10-03 Timestamp readings from the device clock across reboots and power cuts
    Rows from an earlier boot were timed by adding up boot uptimes back from
    the sync, which cannot see how long the unit was powered off, so every
    unsynced row from before a power cut landed late by the outage length.
    - Firmware (all three variants): each buffered row now records the
    wall-clock UTC epoch at sampling (0 while the clock is unknown), as an
    optional trailing field so rows buffered by older firmware still parse.
    It is uploaded as `t` and streamed over BLE as field 11 (single-meter
    builds now stream channel 1 as field 10 so both builds share a layout).
    The serial LOG command on the single-meter builds a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
    [ble_service.cpp, esp32.WROOM.DevKit.V1_ds1307_ac_energy_meter.ino, esp32.WROOM.DevKit.V1_dual_pzem_ac_energy_meter.ino, esp32.supermini_ds1307_ac_energy_meter.ino, storage.cpp, storage.h]
2026-10-03 Automatically renumber a device's readings after a seq collision
    A device that loses its seq counter (full flash erase, or a replacement
    board on the same device ID) restarts at seq 1. The server ignored those
    rows as duplicates of the old ones and acked them, so the device deleted
    them: every new reading was silently lost until seq passed the old max.
    - ingest.php: when a duplicate key holds a DIFFERENT reading (boot_id,
    sec_since_boot or energy differ; an identical resend is still a no-op),
    roll back the whole batch and answer 409 {error: seq_collision,
    seq_floor: <highest stored seq>}. 409 rather than 200 so firmware
    without this support keeps the rows instead of deleting them.
    -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
    [ble_service.cpp, esp32.WROOM.DevKit.V1_ds1307_ac_energy_meter.ino, esp32.WROOM.DevKit.V1_dual_pzem_ac_energy_meter.ino, esp32.supermini_ds1307_ac_energy_meter.ino, storage.cpp]
2026-10-03 Fix ingest responses overflowing the firmware's JSON buffer; fix relay "clear"
    The ingest response carried every relay schedule twice (relay_channels[]
    and the flat relay_* mirror) and the firmware parses it into a fixed
    StaticJsonDocument. Measured on a 32-bit build: one full-week window used
    1,020 of the single-relay builds' 1,024 B, so a second window made the whole
    parse fail. The POST then counted as failed, the delivered rows were never
    truncated and got resent forever while the buffer filled, and no config was
    picked up. The dual build broke at 4 windows.
    - ingest.php: send multi-relay firmware (relay_count > 1) only
    relay_channels[] and single-relay firmware only the flat fields.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
    [wifi_sync.cpp]
2026-10-03 Stop single-meter firmware logging zero rows on a missed read
    The single-meter builds logged a row when `ok || st == PZEM_OK`, but the
    sample is zero-filled every loop and classify() still reports PZEM_OK for
    the first few failed reads. A missed Modbus transaction on a logging tick
    therefore stored V = 0 / Wh = 0, and that 0 Wh becomes the bucket's
    MIN(energy_wh) on the server, blowing the hour's or day's bar up to the
    whole cumulative reading.
    - Firmware (both single-meter builds): log only fresh reads.
    - ingest.php: drop V = 0 + Wh = 0 rows (still acked, so old firmware
    deletes them).
    - readings.php: ignore such rows already stored.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
    [esp32.WROOM.DevKit.V1_ds1307_ac_energy_meter.ino, esp32.supermini_ds1307_ac_energy_meter.ino]
2026-10-03 Fix switching Wi-Fi networks from the app; app accuracy fixes
    - Firmware (all three variants): saving new credentials over BLE while
    the meter was already connected changed nothing, because every sync
    cycle reused the existing WL_CONNECTED link. Saving now requests a
    reconnect, so the next cycle drops the old association and joins with
    the new credentials.
    - App, Wi-Fi setup: right after saving, the meter still reports its
    pre-save state ("disconnected", or "connected" to the old network),
    which the app took as final, showing a false "check the password" or a
    false success. It now waits for a connect attempt, or for "connected"
    to the network being saved.
    - App, cloud dashboa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
    [ble_service.cpp, wifi_sync.cpp, wifi_sync.h]
2026-10-03 Peak card uses each bucket's true maximum; reject bad readings dates with 400
    The Peak card took the highest bucket AVERAGE from the power line, so on
    the daily/monthly views a 631 W spike read as ~384 W. It now uses the
    P_peak the API already returns. readings.php answered an unparseable
    from/to with an uncaught exception (500); it now returns 400 bad_date.
    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
2026-10-03 ingest: validate device_id like claim_device does
    An over-long id was silently truncated by INSERT IGNORE, then made the
    next insert fail with an uncaught 500.
    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
2026-10-03 Drop compatibility code for firmware that is not deployed
    No older firmware is live, so remove the shims that existed only for it:
    - Relay config has one wire format: relay_channels[]. ingest.php no longer
    sends the flat relay_* mirror; the single-meter builds read their ch 1
    entry from relay_channels, and the dual build loses its flat fallback.
    Measured on the 32-bit target: 8 windows use 2,028 / 2,560 B (single)
    and 3,532 / 4,096 B (dual).
    - Buffered rows have one layout per build, epoch included; the parsers no
    longer accept the pre-Hz / pre-epoch forms.
    - The app's stream parser requires the full 11-field line.
    - ingest.php no longer special-cases the zero rows the old single-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
    [ble_service.cpp, storage.cpp, storage.h, wifi_sync.cpp]
2026-10-03 Keep energy figures continuous across PZEM swaps, resets and register wraps
    The PZEM's raw Wh register drops to ~0 on an energy reset or when a fresh
    module is fitted, jumps to whatever a used replacement holds, and wraps to
    0 past 9999.99 kWh. Every figure was MAX-MIN of that raw value, so each
    event produced a bar of thousands of kWh, lost the energy before it, or
    made the dashboard's meter reading step backwards.
    - New column energy_cum_wh: a per-(device, channel) counter that only moves
    forward by energy used. Normal step: + difference; wrap: + span across the
    ceiling; drop (reset / fresh module): + 0; jump beyond what 26 kW could
    produce in the gap (used module): + 0. Rules live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
